TENLEAP-AI/digital-human-koubo/hardware/esp32-s3-board/kicad/README.md

# Zeebuddy 主板 V1（KiCad 9）

ESP32-S3-WROOM-1U-N16R8 + Air780E 的主板，第一版，**草稿**：原理图已画完，PCB 已布通，
**还有几条规范没满足（见下），还不能投板。**引脚分配按 `../docs/requirements.md` 的方案三，
两颗扩展芯片的引脚按板上位置重新分过（见"还没定的"一节的表）。

> **下一轮布线进行中**（2026-11-12）：板子文件仍是全部连通的 731b83a 走线；脚本已改成按 GEN-7、VIP-1、USB-3 出底子，
> 新底子上自动布线还剩 13 ~ 19 处没连。做法、数字和要定的事见 [`reports/routing-closure.md`](reports/routing-closure.md) 第 10 节。
> 现在直接重跑脚本得到的是这个没做完的版本，不是仓库里的板子。
>
> **当前状态**（2026-11-11）：六层、板厚 1.6 mm，按 [`../docs/layout-spec.md`](../docs/layout-spec.md)（V0.3）在做。
> - `zeebuddy-mainboard.kicad_pcb`：`731b83a` 那一版 570 处连接全部布通。2026-11-12 按独立复查改了两处原理图
>   （Type-C 保护芯片 U1 第 5 脚接 VBUS；R44 改为默认贴），U1 第 5 脚这根线在现在的板子上被锁定的 USB 线围住，
>   **留作 1 处未连通**，和下一轮的 USB 重画一起做。KiCad 9.0.9 完整检查：未连通 1、布线违规 0、
>   原理图一致性（含字段差异）0。报告在 [`reports/`](reports/)。
> - 首版配置：屏用 G3 ~ G7 五根数据线（G0 ~ G2 接地），保留 TF 卡，R58 ~ R60 已删除。
> - **屏的接口没有定，定之前不要投板。**屏厂给的型号（华迪创显 HD28142C22）是 MIPI 接口，这块主板是按 8 位串行 RGB 设计的，
>   驱动不了；要屏厂答复能不能做 RGB 接口的版本。见 [`../docs/display-interface-for-vendor.md`](../docs/display-interface-for-vendor.md)。
> - **KiCad 检查通过不等于规范全部满足。**还没满足或没检查的：USB 四段里三段的等长（USB-3）；
>   1 段 4.2 mm 的 0.11 mm 窄线（GEN-1 允许的窄线最长 3 mm）；过孔到焊盘 ≥0.15 mm（GEN-7）没有写进 KiCad 规则，
>   现在按 0.10 mm 检查；另有 3 处和规范的出入等确认（见规范的"待定问题"）。
>   逐项见 [`reports/routing-closure.md`](reports/routing-closure.md)。

## 文件

| 文件 | 内容 |
|---|---|
| `zeebuddy-mainboard.pdf` | 原理图 PDF，直接看这个 |
| `zeebuddy-mainboard.kicad_pro` / `.kicad_sch` | KiCad 工程和顶层图 |
| `power.kicad_sch` | 1 电源：Type-C、充电（SY6970）、电池、3.3 V |
| `mcu.kicad_sch` | 2 主控：ESP32-S3 模组、下载口、USB 切换 |
| `expander.kicad_sch` | 3 两颗 I²C 扩展芯片、按键 |
| `cellular.kicad_sch` | 4 4G：Air780E、SIM 卡、天线 |
| `display.kicad_sch` | 5 屏、触摸、背光 |
| `camera.kicad_sch` | 6 前后摄像头、总线切换、摄像头电源 |
| `audio_tf.kicad_sch` | 7 麦克风、功放、TF 卡 |
| `zeebuddy.kicad_sym` | 工程自带的符号（Air780E、排线座等） |
| `zeebuddy-mainboard.kicad_pcb` | PCB：六层，外形、螺丝孔、210 个封装；电源、地、天线线、USB 已布好并锁定，信号线全部布通 |
| `reports/drc-report.txt` / `.json` | KiCad 9.0.9 的完整检查报告（含原理图一致性） |
| `reports/routing-closure.md` | 布线收尾记录：每处断点怎么处理的、改了什么摆位、规范核查结果、还没满足的规范、独立复查的结论 |
| `connector-positions.png` | 所有排线座的位置、第 1 脚、排线插入方向（`gen/connectors.py` 生成），给结构和排线供应商 |
| `../docs/display-interface-for-vendor.md` | 给屏厂的排线接口定义（8 位串行 RGB，主板现在的接法）：脚位表、要屏厂确认的事项、背光和触摸 |
| `../docs/display-request-serial-rgb.md` | 给屏厂的改法说明（8 位串行 RGB，一页，不含内部分析）：要求、脚位、要对方答复的问题 |
| `../docs/display-interface-qspi-proposal.md` | 给屏厂评估的 QSPI 接口定义（提案，主板还没按它改） |
| `placement-front.png` / `placement-back.png` | 正反两面主要器件的摆放示意图 |
| `routing.png` | 当前布线的示意图 |
| `freerouting/zeebuddy-mainboard.dsn` | **第二轮**给 Freerouting 用的板子文件（底子作为障碍，只有信号线要布） |
| `freerouting/zeebuddy-mainboard.ses` | 第二轮 Freerouting 的结果（2.5.0，限时 20 分钟） |
| `freerouting/round1.ses` | 第一轮的布线结果，存档用。它对应的是旧摆放（提交 `2e952f9`），不能导入现在的板子 |
| `zeebuddy.pretty/` | 工程自带的封装（Air780E、SY6970、麦克风和几个占位封装） |
| `gen/` | 生成原理图、封装库和 PCB 的脚本，见下面"PCB 是怎么生成的" |

## 这份图是脚本生成的

原理图不是在 KiCad 里手画的，而是由 `gen/design.py` 生成。每个引脚引出一小段线，接一个网络标号，
同名的标号就是连在一起，所以图上看不到长连线。

要改电路：改 `gen/design.py`，然后运行

```bash
gen/build.sh
```

它会重新生成全部图纸，用 KiCad 导出网表并和脚本里写的连接逐脚比对，再跑 ERC、导出 PDF；
然后生成封装库和 PCB，跑 DRC 和"PCB 与原理图是否一致"的检查。
直接在 KiCad 里改图，下次生成时会被覆盖。

**PCB 目前也是脚本整板生成的**，每次运行都会重摆、重布。等布线接近完成、需要手工收尾时，就不能再整板重新生成了。

## 检查结果

- 网表比对：833 个引脚全部与脚本里写的连接一致。
- KiCad ERC：0 个错误，1 个警告（功放散热焊盘接地，符号库里这个脚的类型是"未指定"，可以忽略）。
- PCB 与原理图一致性：213 个封装、全部焊盘的网络都与原理图一致。
- KiCad DRC：元件之间没有重叠，没有超出板边；已布的线没有间距、短路、孔距、板边类的违规。
  有 1 个提示：天线座封装与库里的不一致（我把它自带的禁布区从"所有层"改成了只在背面，是有意的）。
  未连接 0 个。

这些只说明"图和脚本一致、没有悬空或短接、摆放不打架"，**不代表电路经过了实物验证**。

## PCB 是怎么生成的

| 步骤 | 脚本 | 做什么 |
|---|---|---|
| 摆放 | `gen/place.py`、`gen/board.py` | 每个元件的位置；生成摆好的板子 |
| 底子 | `gen/power.py`、`gen/route.py` | `power.py` 是手工定坐标的电源铜皮和过孔，程序逐段检查间距；`route.py` 再布天线线、USB、每个地和 3.3 V 焊盘的短线加过孔，全部锁定 |
| 交给自动布线 | `gen/freeroute.py` | 生成 `freerouting/*.dsn`；布完后用 `--ses` 导入结果 |
| 收尾 | `gen/finish.py` | 清掉悬空线头，去掉违规线段并重连，补还没连上的 |
| 检查 | `gen/check.py` | 按规范逐条量数字，出"规则 — 要求 — 实测 — 结论"表 |
| 查原因 | `gen/diagnose.py` | 布不通时查是板子装不下还是布线程序的问题 |

```bash
/usr/bin/python3.12 gen/board.py .     # 摆放
/usr/bin/python3.12 gen/route.py .     # 底子（约 2 秒）
/usr/bin/python3.12 gen/freeroute.py . # 生成 .dsn
/usr/bin/python3.12 gen/check.py .     # 检查表
```

## PCB 布线现状（六层）

六层的用法：第 1、6 层放元件、短线和电源铜皮，第 2、5 层整层地，第 3 层走信号，第 4 层铺 3.3 V。

布线分两步（规范第 2 节的顺序）：**先把底子做好并锁定，再让 Freerouting 只布信号线。**
第一轮顺序反了（先布信号，电源和地的过孔事后挤不进去），所以重做。

### 底子里有什么

| 内容 | 怎么做的 |
|---|---|
| 电池 → 充电芯片 | 背面一块 2 mm 宽的铜皮，从电池焊盘直接到充电芯片的电池脚，电池电容在路上 |
| 充电芯片 → Air780E | 充电芯片转了 90°，系统输出脚朝上，接一条 2 mm 宽的铜带沿上方直通 4G 电源开关；开关管 → 220 µF → 模组供电脚是一整块铜皮。电池焊盘到模组供电脚铜皮共约 21 mm |
| 电源汇合点（PWR-16） | 在充电芯片系统输出的电容处：4G 一路往右，另一路经 4 个过孔到正面，一条 2 mm 宽的铜带一直到功放 |
| 充电回路 | 电感紧贴开关脚（铜长 2.7 mm），自举电容压在开关节点上，系统输出电容的地焊盘正对芯片的功率地脚 |
| 3.3 V 降压（正面） | 输入电容的地从芯片肚子底下接回地脚；开关脚到电感 0.65 mm；输出经 2 个过孔进第 4 层 |
| 背光升压（正面，移到了下方） | 电感在芯片正上方，二极管和输出电容在左侧，高频回路在 2 mm 以内 |
| 5 V 输入（VBUS） | Type-C 两组供电脚各引一条 0.6 mm 的线，从保护芯片两侧绕过定位柱，到 TVS 汇成 1.0 mm，沿下边缘走，再转到背面从 SIM 卡座底下（避开卡座的触点窗）到充电芯片 |
| 天线线 | 和以前一样：0.34 mm 直线、第 5 层只在天线座焊盘下开窗。新增：线两侧各两条地线，把 1 mm 的隔离带实实在在占住 |
| USB | 四段都已布好并锁定（等长还没达标，见下） |
| 地和 3.3 V | 每个焊盘一段短线加一个过孔，共 236 个；先打电容的，再接引脚 |

### 按规范量出来的结果

`gen/check.py` 的输出（节选）：

| 规则 | 要求 | 实测 | 结论 |
|---|---|---|---|
| DRC | 间距、短路、孔距、板边等 0 条 | 0 条 | 通过 |
| 原理图一致性 | 0 处差异 | 0 处 | 通过 |
| 底子完整 | 电源、地、3.3 V、天线、USB 全部连上 | 0 处没连 | 通过 |
| PWR-1 | 电池、系统电源、4G 供电的铜皮 ≥2.0 mm；收窄处 ≥1.0 mm、长 ≤2 mm；引脚处按引脚宽 | 收窄处最窄 1.1 mm、最长 1.8 mm | 通过 |
| PWR-2 | 电池焊盘到 Air780E 供电脚：铜皮 ≤30 mm、≤15 mΩ | 约 21 mm、约 6.1 mΩ（按方块数估算，不含充电芯片和开关管） | 通过 |
| PWR-3 | 220 µF 正极到模组供电脚 ≤1.8 mm，电容在电流的路上 | 1.76 mm | 通过 |
| PWR-5 | 220 µF 地焊盘旁 ≥3 个 0.3 mm 地孔 | 3 个 | 通过 |
| PWR-8 | 换层过孔数：系统电源 ≥4，VBUS 和 3.3 V 主干 ≥2 | 4 / 2 / 2 / 2 / 2 | 通过 |
| PWR-12 | 开关节点铜长 ≤3 mm，不打过孔 | 充电 2.74 mm、3.3 V 降压 0.64 mm、背光 0.84 mm，均无过孔 | 通过 |
| PWR-14 | 散热焊盘地孔：充电芯片 ≥5，功放 ≥4 | 6 个、4 个 | 通过 |
| DEC-6 | ESP32 底部地焊盘 ≥9 个地孔 | 12 个 | 通过 |
| RF-5 | 天线线两侧地孔间距 ≤2 mm | 14 个，最大间隔 1.8 mm | 通过 |
| RF-6 | 天线线总长 ≤15 mm | 6.5 mm | 通过 |
| RF-9 | 背面其它信号离天线线 ≥1 mm | 最近 2.0 mm | 通过 |
| RF-11 | 天线座每个地焊盘旁 ≥2 个地孔 | 5 个、2 个 | 通过 |
| USB-3 | 每段两根线长度差 ≤0.5 mm | 1.8 / 0 / 3.3 / 2.6 mm | **三段不通过** |

这张表只覆盖底子负责的规则（电源、地孔、天线线、USB 长度）。信号类的规则还没有写进脚本。

### 和规范有出入的地方

这几处已经记进规范的"待定问题"，等确认：

- **USB 等长（USB-3）**：四段里三段没达标。功能上不会有问题（常见设计指南的上限约 3.8 mm），但没达到规范收紧后的 0.5 mm。
- **VBUS 线宽（PWR-9）**：Type-C 旁边有约 7 mm 是两条 0.6 mm 并联，不是一条 1.0 mm（定位柱和保护芯片之间放不下）。
- **TVS 的位置（PWR-7）**：离 Type-C 供电脚约 6 mm，规范的判据是 2 mm（那一带正面没有空位）。
- **充电输入电容的地（PWR-11）**：芯片的引脚排列不允许同一面直接连，改为经相邻地层回流，孔紧挨焊盘。

另外有两处要留意：

- 5 V 输入线有一段从 SIM 卡座底下走（背面，避开了卡座封装标出的 6 个触点窗）。卡座的实际型号定了以后要对着图纸再确认一次。
- 4G 电源开关用的是 AO3401A，数据手册给的导通电阻上限是 60 mΩ（栅压 4.5 V 时）、85 mΩ（2.5 V 时）。
  按 2 A 算会掉 0.12 V 以上，占了"跌落 ≤300 mV"预算的四成。这是原理图层面的事，这次没有动，
  打样前值得换一颗导通电阻更低的管子。

### 第三轮：布通（2026-11-11）

第二轮停在"三个信号层装不下这么多交叉"。第三轮没有加层，改的是交叉本身：

| 改了什么 | 为什么 |
|---|---|
| 前摄排线座 J11 移到上边缘右侧，紧挨总线切换芯片；按键排线座 J5 左移 10 mm | 前摄的 14 根线原来要横穿 25 mm 的 4G 模组外围 |
| 两颗扩展芯片的信号按器件在板上的位置重新分配（6 个信号换了芯片或引脚） | 左边的中断线接在右边的芯片上，右边的摄像头控制线接在中间的芯片上，各跨 30 ~ 65 mm |
| 删除 R58 ~ R60（屏低 3 位借 TF 卡线的选配） | 三条 40 mm 以上的线横穿全板，首版用不上 |
| U8 下移 0.8 mm，U7 转 180° | U8 的中断脚被两个 3.3 V 脚的连线盖死；U7 的按键脚背对着它们的上拉电阻 |
| 底子里手工加了 4 处短线（`power.py`） | TF 卡座第 4、5 脚，U8 第 18 脚，U7 的中断脚：这些脚光靠锁定的铜就被围住，自动布线解不了 |
| 测试点、时钟串联电阻、稳压芯片的输出电容等挪到它们所连的引脚旁 | 缩短支线，让出通道 |

找这类问题用的办法是在只有底子的板子上逐个引脚试"能不能出来"（出不来的就是被锁定的铜围死的），
以及对每一处没连上的连接算"最短的路要穿过哪些线、沿途有多少过孔"。

结果：Freerouting 2.5.0 自己停在剩 3 处，`finish.py` 之后剩 1 处（充电芯片的 I²C 时钟脚），
`hand.py` 手工接通；`widen.py` 把过窄的线加宽。每处断点的处理见 [`reports/routing-closure.md`](reports/routing-closure.md)。

**重新生成的命令**（顺序不能变；`hand.py` 里的坐标只对这一份布线结果有效）：

```bash
python3 gen/design.py . && python3 gen/verify.py . zeebuddy-mainboard      # 原理图
/usr/bin/python3.12 gen/board.py .                                          # 摆放
/usr/bin/python3.12 gen/route.py .                                          # 底子
/usr/bin/python3.12 gen/freeroute.py .                                      # 生成 freerouting/*.dsn
java -jar freerouting-2.5.0.jar -de freerouting/zeebuddy-mainboard.dsn -do freerouting/zeebuddy-mainboard.ses \
     --router.autorouter.max_passes=40 --router.job_timeout=00:20:00 -mt 1 --gui.enabled=false
/usr/bin/python3.12 gen/freeroute.py . --ses freerouting/zeebuddy-mainboard.ses   # 导入
RIPUP=150 /usr/bin/python3.12 gen/finish.py .                               # 清理、补线
/usr/bin/python3.12 gen/hand.py . --kicad-decides                           # 手工那几段
/usr/bin/python3.12 gen/widen.py zeebuddy-mainboard.kicad_pcb               # 加宽过窄的线
/usr/bin/python3.12 gen/check.py .                                          # 检查表
```

仓库里的 `freerouting/zeebuddy-mainboard.ses` 就是这次用的那份结果，直接从"导入"那一步做起可以得到同一块板子。

### 第二轮的记录

下面是第二轮（三层、原来的摆放）的过程，保留作记录；数字已被第三轮取代。

**结果（2026-11-11，Freerouting 2.5.0，每次限时 20 分钟）**

| 没连上的信号连接 | 第一次（原摆放） | 第二次（排线座下方清出空带） |
|---|---|---|
| 交给 Freerouting 之前 | 243 | 243 |
| Freerouting 到点停下时 | 48 | 51 |
| `finish.py` 清理并补线之后 | 38 | **42** |

两次导入后 KiCad 检查都是 0 条违规（没有短路、没有间距问题），底子一条没动。板子文件里是第二次的结果。

**第二次改了什么摆放。** 前摄排线座 J11 的引脚下方原来 0.5 mm 就是一排元件。现在：
C46、C47 挪到 C18 右边，Q2 挪到 R73 下方，Q3 ~ Q5 和它们下面三排电阻往下让了 0.9 mm。
J11 引脚下方有了约 2 mm 的空带，电源部分没有动。

**为什么数字没有变好。** 两次的差别在自动布线的波动范围内（±5）。剩下的 42 处：

| 位置 | 数量 |
|---|---|
| 前摄像头排线座 J11（正面，上边缘） | 9 |
| 屏排线座 J8（背面，上边缘） | 6 |
| 后摄像头排线座 J10（背面，上边缘） | 4 |
| 其余（扩展芯片 U8、SIM、测试点、几颗电阻等） | 23 |

出线空带只解决了"第一步迈不出去"，没有解决"迈出去以后没路走"：

- 前摄的 14 根线要从 J11（x = 14 ~ 26 mm）走到总线切换芯片 U12 / U13（x = 41 ~ 49 mm），
  中间 25 mm 是 4G 模组的外围电路，正反两面都是元件和过孔。
- J8（背面）和 J11（正面）在 x = 12 ~ 22 mm 正反重叠，两边的过孔互相占位；J8 引脚下方 1 mm 就是
  2 mm 宽的系统电源铜带，只能打一排过孔。
- 只有三个信号层（第 1、3、6 层）。放开到六层试过一次，Freerouting 自己能做到剩 19 处，但线会走在地层和 3.3 V 层上，不能用。

下一步要动的是排线座的位置（把前摄排线座移到总线切换芯片旁边，或者和屏排线座错开），这会影响排线从哪里伸出来，
要先和结构对一下。

**交接文件的做法（脚本自动完成）**

- 底子里已经连好的 25 个网络（地、3.3 V、各路电源、天线、USB）**不作为网络**交给 Freerouting：
  它们的铜变成禁布区，焊盘不带网络。Freerouting 看到的只有障碍和 243 处信号连接。
  （第一次直接把它们当锁定的线交过去，Freerouting 每一轮都去尝试连接地和 3.3 V 的 250 多个焊盘，
  30 分钟没走完第一轮。）
- 地和 3.3 V 各留一个焊盘，这样三层平面还在文件里，Freerouting 才不会在平面层上走信号线
  （去掉平面试过一次：它在平面层上布了 160 段线，全部和过孔短路）。
- 通孔在内层补了铜；板子外形往里收 0.32 mm；天线线两侧用地线占住。
- 运行时加时间上限（`--router.job_timeout`）：Freerouting 只在停下时才写结果，不限时会为最后几十处跑一个小时以上。

**重跑的命令**

```bash
/usr/bin/python3.12 gen/freeroute.py .                       # 生成 .dsn
java -jar freerouting-2.5.0.jar -de freerouting/zeebuddy-mainboard.dsn -do freerouting/zeebuddy-mainboard.ses \
     --router.autorouter.max_passes=40 --router.job_timeout=00:20:00 -mt 1 --gui.enabled=false
/usr/bin/python3.12 gen/freeroute.py . --ses freerouting/zeebuddy-mainboard.ses   # 导入
/usr/bin/python3.12 gen/finish.py .                          # 清理、补线
/usr/bin/python3.12 gen/check.py .                           # 检查表
```

注意：

- Freerouting **不会**把 USB 当差分对来走，所以 USB 是先在这边画好再锁定的。
- `.dsn` 由 `gen/freeroute.py` 生成；元件位置或底子变了要重新生成，旧的 `.ses` 就不能用了。
- 用界面跑也可以（`文件 → 打开` 选 `.dsn`，点自动布线，停下后 `文件 → 另存为` 存成 `.ses`），但界面没有时间上限，要自己看着停。

### 以前几轮的记录

**自己写的布线程序**（`SIGNALS=1 gen/route.py`，网格搜索加拆线重布）：旧摆放下布通 509 ~ 514 / 580，
四层版是 484 / 579。在新的底子上不拆线只布一遍是 489 / 576。它现在只用来做底子和收尾。

**为什么布不完**（`gen/diagnose.py`，旧摆放上量的）：没连上的 71 处里，空板上也布不通的 0 处，
被固定的铜堵住的 6 处，只是被别的信号线挡住的 65 处；需要过孔的 520 个引脚在 2 mm 内都能分到过孔位；
最紧的截面只用了 27%。结论是板子装得下，问题在布线程序。

**试过的办法**：先短后长、只拆挡路的一段、给细间距引脚预先打孔（没有帮助）、协商布线（`NEGOTIATE=1`，没有收敛，
代码保留，默认不启用）。

**Freerouting 第一轮（2026-11-11，旧摆放，结果存在 `freerouting/round1.ses`）**：信号线只剩 28 处没连（我的程序是 65 处），
但留下了这些问题，第二轮逐条做了处理：

| 第一轮的问题 | 数量 | 第二轮怎么处理 |
|---|---|---|
| 地和 3.3 V 的焊盘完全没接（它不负责接平面） | 255 处 | 底子里先接好并锁定 |
| 第三层的线从通孔上压过去 | 17 段 | 导出文件里给这些通孔补上内层的铜 |
| 离板边不到 0.3 mm | 20 段 | 导出的外形往里收 0.32 mm |
| 电源线走了第三层、线宽不够 | VBAT、VSYS、VBUS 等 | 电源全部在底子里手工布好并锁定，不交给它 |
| 天线线旁 1 mm 内有别的过孔 | 2 个 | 线两侧用锁定的地线占住 |
| 线宽 0.075 mm、悬空的过孔和线头 | 2 段、26 个、42 段 | 仍由 `finish.py` 导入后清理 |

## PCB 摆放

- 外形和四个螺丝孔取自参考主板 M03 的 STEP 模型：64 × 34 mm（参考板是 0.8 mm 四层；本板是 1.6 mm 六层）。
  右上角的螺丝孔离板边只有 1.2 mm，放不下铜环，做成了不带铜的孔；另外三个孔的铜环接地。
- **背面是"高"的一面**：ESP32-S3 模组（高 3.2 mm）、Air780E（2.3 mm）、屏 / 触摸 / 后摄的排线座、电池和喇叭焊盘、充电芯片；
  下边缘从背面看由左到右是 **TF 卡座、Type-C、4G 天线座、SIM 卡座**，三个对外的口在同一面同一条边。
- **正面是"低"的一面**：前摄排线座、两个按键排线座、麦克风、下载焊盘，以及绝大部分小元件。
  充电芯片的外围、Air780E 的大电容和电源开关、ESP32 的去耦电容、天线匹配放在背面，紧挨着对应的引脚。
- **第二轮重摆的部分**（都是为了让电源按规范走）：
  - 背面：充电芯片转了 90°，电感、各个电容按引脚重新围着它摆；4G 电源开关移到 220 µF 上方，220 µF 调了头（正极朝上）。
  - 正面：3.3 V 降压移到系统电源过孔旁边；功放留在左下角喇叭焊盘旁，转了 90°（供电脚朝右、输出朝上）；
    背光升压移到下方空处；Air780E 的三个小滤波电容和 TVS 移到供电脚正对面；Type-C 的保护芯片转了 90°，
    给两侧各让出一条 0.6 mm 的走线位；几个电源测试点挪到了各自电源的旁边。
  - 正面的 IO 扩展芯片（U8）右移了 0.6 mm，让它底部的地焊盘正对背面天线线两侧，好在里面打地孔。
- 与参考主板位置相同的：Type-C、SIM 卡座、电池焊盘、喇叭焊盘、麦克风、按键排线 A。其它位置是我定的。
- 为了把 TF 卡座放到背面，ESP32 模组顶到了上边缘，Air780E 横过来放。代价是 Air780E 四周的间距只剩
  1.3 ~ 2.2 mm（到排线座 1.3、到 SIM 卡座 1.6、到 Type-C 1.9、到 ESP32 模组 2.2），合宙建议是 3 mm。
- 图纸坐标：板子左上角在 KiCad 页面的 (100, 60) mm 处。

**占位的封装**（型号定了要换）：三种排线座（按常见的 0.5 mm 翻盖座估的尺寸）、SIM 卡座（GCT SIM8060）、
TF 卡座（Molex 104031-0811）、Type-C（HRO TYPE-C-31-M-12）、两个轻触开关、IO 扩展芯片（按 TI 的 QFN-24 封装）。

## 自建封装的出处

| 封装 | 出处 |
|---|---|
| `Air780E` | 合宙官方 PADS 封装包 V20241030 里的 109 个焊盘坐标和尺寸；与官方"封装尺寸推荐"图一致 |
| `SY6970_QFN-24_4x4mm` | SY6970 数据手册 Rev 0.1 的推荐 PCB 图：焊盘 0.55 × 0.28、间距 0.5、散热焊盘 2.7 × 2.7 |
| `MSM261S4030H0R` | 敏芯数据手册 V1.0 的推荐焊盘图：焊盘 0.9 × 0.6、行距 1.0、两列间隔 1.0 |

## 元件脚位的出处

| 元件 | 脚位出处 |
|---|---|
| ESP32-S3 模组、MAX98357A、FSUSB42、ME6211、三极管、MOS 管、保护器件 | KiCad 9 官方符号库 |
| SY6970QCC 充电芯片 | 矽力杰 SY6970 数据手册 Rev 0.1 的管脚表；外围元件值也按这份手册 |
| XL9555QF24 | 用官方库里 TCA9555RTWR 的符号；对照 XL9555 数据手册，QFN-24 的 24 个脚完全相同 |
| SY8089AAAC | 用官方库里 TLV62569DBV 的符号；对照 SY8089 数据手册，5 个脚和 0.6 V 反馈电压相同 |
| Air780E | 合宙《Air780E 硬件手册》AT 方式管脚表，109 个焊盘 |
| 摄像头 24 脚排线 | 乐鑫 ESP32-S3-EYE 主板原理图的 J4 |
| 屏 22 脚排线 | 屏厂的 LB28BOE47 确认图 |
| MSM261S4030H0R 麦克风 | 敏芯数据手册 V1.0 的管脚表 |
| SY7200AABC 背光驱动 | 矽力杰 SY7200A 数据手册 Rev 1.0 的管脚表 |
| 74CBTLV3257 | 按标准脚位自建，对照过 KiCad 官方库里同型号的分单元符号 |
| 触摸排线、按键排线、SIM 卡座 | **占位，脚位待定** |

## 可以替换的料

| 图上的型号 | 可替换 | 说明 |
|---|---|---|
| SY6970QCC | BQ25895RTWR | 24 个脚相同，贵约 6 元；TI 的数据手册用 2.2 µH 电感 |
| XL9555QF24 | TCA9555RTWR | 脚位相同；TCA9555 没有内部上拉 |
| SY8089AAAC | TLV62569DBV | 脚位和反馈电压相同 |

没有采用 NS4168 功放：它的逻辑高电平要求 0.7 × 供电电压，功放用电池电压供电时 3.3 V 的信号不够高；
改用 3.3 V 给它供电又会损失输出功率。

## 还没定的

见顶层图上的清单。封装只填了有把握的（阻容、芯片、模组）；连接器的封装是占位，画板前要按实际型号换。

**投板前要定的选配电阻**（2026-11-11 记录）：

| 电阻 | 作用 | 现状 | 等什么 |
|---|---|---|---|
| R58 ~ R60 | 把屏的低 3 位数据线借给 TF 卡的 3 根线（8 位全接，但不能用 TF 卡） | **已删除**。首版用 5 根数据线（G3 ~ G7），保留 TF 卡 | 拿到实物屏后看颜色渐变能否接受；不够再重新分配 ESP32 引脚，做到 8 位全接且保留 TF 卡 |
| R8（不贴） | 按键 1 兼作充电芯片的唤醒（QON） | 保留。它让 KEY1 多出一条 50 mm 的支线 | 确认关机后是否需要用按键 1 通过充电芯片唤醒 |
| R73（不贴） | 把 1.2 V 送到前摄的 DVDD | 保留。支线约 30 mm | 定前摄实物料号和排线定义，确认模组是否需要主板提供 1.2 V。关系到首版能不能测前摄 |

**两颗扩展芯片的引脚分配**（固件按这张表配置；信号按器件在板上的位置分，不按输入输出分）：

| 芯片 | 地址 | 位置 | 输入 | 输出 | 不用 |
|---|---|---|---|---|---|
| A（U7） | 0x20 | 板子右侧 | P00 ~ P05 = KEY1 ~ KEY6，P07 = SD_DET，P11 = LTE_STATUS_N | P06 = CAMF_PWDN，P10 = CAM_SEL，P12 = CAM_RST，P13 = EXP_SPARE | P14 ~ P17（设成输出） |
| B（U8） | 0x22 | 中间偏左 | P10 = CHG_INT，P17 = TP_INT | P00 = LCD_RST，P01 = LCD_CS，P02 = LCD_SCL，P03 = LCD_SDA，P04 = TP_RST，P05 = CAM_PWR_EN，P06 = CAMR_PWDN，P12 = PA_EN，P13 = LTE_PWR_EN，P14 = LTE_PWRKEY_EN，P15 = LTE_RESET_EN，P16 = USB_SEL | P07、P11（被天线线的地孔围住，线出不来；设成输出） |

和最初的分配相比换了位置的：TP_INT（A.P06 → B.P17）、CHG_INT（A.P10 → B.P10）、CAMF_PWDN（B.P07 → A.P06）、
CAM_SEL（B.P10 → A.P10）、CAM_RST（B.P11 → A.P12）、EXP_SPARE（B.P17 → A.P13）。两颗的 INT 并在一起接 ESP32。
