TENLEAP-AI/digital-human-koubo/hardware/esp32-s3-board/docs/pcb-redesign-brief.md

# Zeebuddy 主板改板需求说明（给 PCB 工程师）

日期：2026-11-13。

## 0. 请你做什么

这是一块儿童学习机（AI 拍学机）的主板：ESP32-S31 模组跑应用，合宙 Air780E 负责 4G 联网。
原理图和 PCB 都按 ESP32-S3 画完过一版。**2026-11-13 主控改为 ESP32-S31**，所以这次是：原理图按 S31 改，PCB 重新画。
S31 的引脚分配我们已经做好，见 `docs/esp32-s31-pinmap.md`。

| 项 | 内容 |
|---|---|
| 主要工作 | 按第 6 节的规范重新摆放、布线，做到 DRC 零错误、零未连接，规范的"必须"项全部满足 |
| 原理图 | **S31 版已画好**（2026-11-14，分支 `claude/board-s31`，214 个元件、180 个网络，网表核对和 ERC 通过）。改动见 `docs/esp32-s31-pinmap.md` 第 4 节。**用 KiCad 10 打开**（模组符号用了 KiCad 10 的格式）。该分支里的 PCB 文件还是 S3 版的，不能用，请按新原理图重画 |
| 工具 | 现有工程是 KiCad 9（9.0.9）。最好继续用 KiCad；用别的软件也行，但交付时要附 KiCad 能打开的文件或完整的 Gerber 和源文件 |
| 交付 | 见第 9 节 |
| 开工前请先回复 | 报价、工期，以及第 7.1 节两种做法你倾向哪一种 |

工程是我们用脚本生成的。交给你之后**以 KiCad 文件为准**，直接在 KiCad 里改，不用管 `gen/` 目录里的脚本。

## 1. 现有资料

全部在 GitHub 仓库 `TENLEAP-AI/digital-human-koubo` 的 `hardware/esp32-s3-board/` 目录下，
分支 `claude/esp32-board-layout-2w2fx8`。

| 文件 | 内容 |
|---|---|
| `kicad/zeebuddy-mainboard.kicad_pro` 等 | KiCad 工程：7 张原理图、PCB、自带的符号库和封装库 |
| `kicad/zeebuddy-mainboard.pdf` | 原理图 PDF |
| `docs/layout-spec.md` | **布线规范 V0.4**，每条规则有编号（GEN、PWR、RF、USB……），下文引用的编号都在这里 |
| `kicad/connector-positions.png` | 所有排线座的位置、第 1 脚、排线插入方向 |
| `kicad/reports/routing-closure.md` | 上一版布线的记录：哪里最挤、试过什么、哪些规范没满足 |
| `kicad/reports/drc-report.txt` | 上一版的 KiCad 检查报告 |
| `docs/requirements.md` | 需求和引脚预算的来龙去脉 |
| `docs/air780e-design-notes.md`、`docs/esp32-s3-design-notes.md` | 两个模组的设计要点（出自原厂资料） |

上一版 PCB 有两个状态，都可以参考：

| 版本 | 在哪 | 情况 |
|---|---|---|
| 全部布通的一版 | 分支 `claude/backup-board-v1-routed` | 570 处连接全部连通、间距违规 0；但有约 300 个过孔贴着或压着焊盘，USB 等长不满足 |
| 按新规范重做的一版 | 分支 `claude/board-v2-gen7-round` | 过孔和 USB 都满足了，但还有 13 ~ 19 处没连通，停在这里 |

## 2. 板子的基本参数

| 项目 | 要求 |
|---|---|
| 外形 | 64 × 34 mm，外形和参考主板一致（KiCad 工程里已画好，含圆角和缺口） |
| 层数、板厚 | 6 层，1.6 mm，外层 1 oz、内层 0.5 oz |
| 叠层 | 按嘉立创六层阻抗叠层设计（外层 7628 预浸料 0.21 mm），型号下单时确认（规范第 1 节、13.1） |
| 各层用途 | L1 正面元件和短线；L2 整层地；L3 主要信号层；L4 3.3 V 铺铜（先不走信号）；L5 整层地；L6 背面元件、短线、大电流铜皮 |
| 贴片 | 两面贴。重的器件（两个模组、钽电容、充电电感、卡座、Type-C）在背面 |
| 螺丝孔 | 三个接地的金属化孔，中心在 (2.0, 14.5)、(3.7, 32.0)、(60.3, 32.0)；一个非金属化孔在 (62.2, 1.2)。坐标见第 4 节说明 |
| 过孔 | 信号 0.2 / 0.45 mm，电源 0.3 / 0.6 mm。0.2 mm 是这个板厚下的下限，不要再小 |
| 限高 | Air780E 高 2.3 mm，ESP32-S31 模组 3.2 mm。外壳两面的限高还没给，开工时和结构一起确认 |

## 3. 主要器件

| 位号 | 器件 | 说明 |
|---|---|---|
| U4 | **ESP32-S31-WROOM-1U-N16R16V** | 主控，背面。18.0 × 20.5 × 3.2 mm，64 个焊盘；16 MB Flash、16 MB PSRAM；Wi-Fi 用模组自带的 IPEX 座。规格书还是预发布 v0.5 |
| | | 符号和封装用乐鑫官方 KiCad 库 github.com/espressif/kicad-libraries 里的 `ESP32-S31-WROOM-1U`（已核对与规格书一致，带 3D 模型） |
| U9 | 合宙 Air780E | 4G 模组，背面。**要能换贴北美版 Air780EEN**（同封装） |
| U2 | SY6970QCC | 开关充电 + 电源路径，I²C 地址 0x6A。可换 BQ25895RTWR（脚位相同） |
| U3 | SY8089AAAC | 3.3 V 降压。可换 TLV62569DBV |
| U11 | SY7200AABC | 背光升压恒流，20 mA |
| Q1 | AO3401A | Air780E 的电源开关 |
| U15 / U16 | 2.8 V / 1.2 V LDO | 摄像头供电 |
| U1 | USBLC6-2SC6 | Type-C 的 USB 保护 |
| ~~U6~~ | ~~FSUSB42MUX~~ | **去掉**。S31 有两个独立 USB 口：Type-C 接全速口（GPIO33 / 34），Air780E 接高速口（专用 USB_DP / USB_DM） |
| U7 / U8 | XL9555QF24 ×2 | I²C 扩展芯片。U7 地址 0x20 放输入（按键、TF 卡检测、4G 状态），U8 地址 0x22 放输出（复位、使能、屏的三线 SPI）。不用 0x21（和前摄冲突） |
| U5 | 803 型 3.08 V 复位监控（开漏） | 接 EN。**默认贴**（乐鑫要求电池供电产品加） |
| U12 ~ U14 | 74CBTLV3257 ×3 | 前后摄像头共用并口时的总线切换 |
| U17 | MAX98357A | I²S 功放，接电池电压（VSYS） |
| Y1 | 24 MHz 有源晶振 | **只留位置不贴**：摄像头主时钟改由主控 GPIO55 经 0R 输出 |
| C19 | 220 µF 低 ESR 钽电容 | Air780E 供电，不能用陶瓷电容代替（规范 PWR-4） |

### 接口和连接器

位置是板子坐标：从正面看，左上角为原点，X 向右，Y 向下，单位 mm（背面的器件也按"从正面看"的坐标写）。

| 位号 | 接口 | 面 | 位置 | 说明 |
|---|---|---|---|---|
| J8 | 屏的板对板母座，亚奇 OCN OK-128GF040/2-35（0.35 mm 间距，40 信号脚 + 2 个端头电源脚，配合高 0.6 mm） | 背面 | 上边缘，中心 x ≈ 16.2 | **屏的接口还没定，见第 5 节**；已定用亚奇公母座代替原来的 FPC 座 |
| ~~J9~~ | ~~触摸排线座~~ | | | **去掉**：触摸已并进 J8 的 37 ~ 40 脚 |
| J10 | 后摄排线座 24P 0.5 mm（OV2640，200 万） | 背面 | 上边缘，中心 x ≈ 32 | |
| J11 | 前摄排线座 24P 0.5 mm（30 万，型号待定） | 正面 | 上边缘，中心 x ≈ 51 | |
| J5 / J4 | 按键排线 6P 0.5 mm ×2 | 正面 | J5 上边缘 x ≈ 39.4；J4 右边缘 | 6 个按键分两条排线 |
| J1 | Type-C 16P | 背面 | 下边缘中间 | 5 V / 2 A 充电，兼作下载 |
| J6 | Nano SIM 卡座 | 背面 | 下边缘左侧 | |
| J13 | TF 卡座（带检测） | 背面 | 下边缘右侧 | |
| J7 | IPEX 座（4G 天线） | 背面 | 下边缘，Type-C 左边 | |
| J2 / J12 | 电池焊盘、喇叭焊盘 | 背面 | 左边缘 | 电池 2000 mAh 单节锂电 |
| MK1 | I²S 麦克风 MSM261S4030H0R | 正面 | 右下 | |
| J3 | 下载 / 调试焊盘 | 正面 | 下边缘 | 串口 0、BOOT、EN |

各排线座的第 1 脚和排线插入方向见 `kicad/connector-positions.png`。
**外形、螺丝孔、各接口所在的那条板边要和外壳对齐**。接口沿板边挪动多少可以接受，开工前和我们、结构一起确认。
上一版已经确认过可以挪：前摄排线座（从 x ≈ 20 挪到了 x ≈ 51）。

连接器的封装现在是占位的（翻盖式 FPC 用 Hirose FH12 系列代替），**画板前要按实际采购的型号换封装**，型号我们提供。
**屏和触摸的接口已定：亚奇 OCN OK-128 系列板对板公母座**，主板贴母座 OK-128GF040/2-35，屏排线上是公座 OK-128GM040/2-35。0.35 mm 间距、配合高度 0.6 mm、40 个信号脚（两排各 20）加两端 2 个电源脚（每个 3 A），信号脚每脚 0.3 A。规格书我们另发，封装按规格书里的推荐焊盘画。注意：
- 公母座脚号是镜像的，原理图和封装一律按母座的脚号；
- 两端的电源脚接地；
- 0.35 mm 间距要 0.1 mm 线宽线距，焊盘间不能过线，出线要错开打孔，六层板常规工艺能做；
- 座子上方要留压泡棉的位置（结构件压住，防跌落松脱）；
- 插拔寿命只有 30 次，调试时少插拔。

## 4. 电路配置

### 4.1 电源

| 电源 | 从哪来 | 给谁 | 电流 |
|---|---|---|---|
| VBUS 5 V | Type-C，经 USBLC6 | 充电芯片 SY6970 | 按 2 A 设计 |
| VBAT | 充电芯片 | 电池，2000 mAh 单节锂电 | 充电 ≤1 A，放电按 3 A 设计 |
| VSYS | 充电芯片的系统输出 | 下面四路 | 3 A |
| VDD_4G | VSYS 经 AO3401 开关 | Air780E | 峰值按 2 A 设计 |
| 3.3 V | VSYS 经 SY8089 降压 | ESP32、扩展芯片、屏、卡等，L4 整层铺铜分配 | 1 A |
| 2.8 V、1.2 V | 3.3 V 经两颗 LDO | 摄像头 | 小 |
| 背光 | VSYS 经 SY7200 升压恒流 | 屏背光，约 18 V | 20 mA |
| 功放 | VSYS | MAX98357A → 喇叭 | 1 A |

- 大电流（VBAT、VSYS、VDD_4G）全部走外层铜皮，最窄 2.0 mm，不上 L4（PWR-1）。
- 功放和 4G 从 VSYS 电容处星形分开，各走各的铜皮（PWR-16）。
- 充电电流的硬件兜底：ILIM 电阻 680 Ω，充电芯片的 DP / DM 短接不接 USB 数据线。原理图已做好，布线不用管。

### 4.2 ESP32-S31 引脚分配

完整的表见 `docs/esp32-s31-pinmap.md`，要点：

- 屏和摄像头接在 S31 规格书里的**专用高速引脚**上（屏数据 D0 ~ D11 = GPIO8 ~ 19、像素时钟 40、DE / HSYNC / VSYNC 43 ~ 45；摄像头 GPIO46 ~ 57），走线从模组这几个脚直接出。屏 D12 ~ D15 = GPIO35 ~ 38。
- TF 卡固定在 GPIO20 ~ 25（4 线）；Type-C 的 USB 固定在 GPIO33（D−）/ 34（D+）；调试串口 GPIO58（TX）/ 59（RX）；BOOT 键 GPIO61。
- 扩展芯片中断、触摸中断在 GPIO0、1（低功耗引脚，可唤醒）。
- GPIO36、37 是启动配置脚，接屏的 D13、D14（屏的输入上电时高阻，不影响启动）。GPIO42 空，引到测试点。

### 4.3 扩展芯片

两颗 XL9555：U7（0x20）接 6 个按键、TF 卡检测、4G 状态（全是输入）；U8（0x22）接 4G 的电源 / 开机 / 复位、摄像头电源 / 待机 / 复位 / 切换、功放使能、屏和触摸的复位、屏的三线 SPI（全是输出）。两颗的中断并在一起接 GPIO0。
同一颗芯片里的脚**可以按摆放重新分配**，改了告诉我们，固件跟着改。

## 5. 屏的接口

**2026-11-14 定：并口 RGB，两家屏共用一个 40 脚板对板座（亚奇公母座）**。联讯 ST7102 用 16 根数据线（RGB565），
NV3049F 用其中 8 根（8 位串行 RGB）。40 脚定义见 `docs/display-request-rgb-st7102.md` 第 3 节，主控引脚见 `docs/esp32-s31-pinmap.md` 第 2 节。

- 屏数据 D0 ~ D11、PCLK、DE、HSYNC、VSYNC 接模组的专用高速脚（其中 D0 ~ D7 在模组底部那圈小焊盘上），D12 ~ D15 走普通 GPIO。
- 像素时钟约 21 ~ 25 MHz（退回 8 位串行时约 60 MHz）。PCLK 两边要有地线，走线按时钟线要求（规范 SIG-4）。
- 屏的初始化三线 SPI、复位走扩展芯片。触摸 I²C、中断也在这个座子上。

## 6. 布线规范要点

完整规范见 `docs/layout-spec.md`。下面是最要紧的，标"必须"的都要满足。

| 类别 | 要求 | 编号 |
|---|---|---|
| 线宽线距 | 信号线 0.15 mm，引脚间窄处 0.10 mm 且 ≤3 mm 长；铜间距 ≥0.10 mm；铜到板边 ≥0.3 mm | GEN-1、2、6 |
| 过孔 | 孔壁到孔壁 ≥0.25 mm；过孔到焊盘 ≥0.15 mm，不在焊盘上打孔（**见 7.1**）；除塞孔外全部盖油 | GEN-5、7、8，VIP-1 |
| 地孔 | 时钟和 USB 换层时 1 mm 内配地孔；全板地孔间距 ≤5 mm | GEN-10、GND-3 |
| 电源 | 见 4.1；开关电源的电容紧贴芯片，地在同一面直接相连；开关节点 ≤3 mm、不打孔 | PWR-1 ~ 18 |
| Air780E 供电 | 220 µF 正极到供电脚 ≤1.8 mm，在电流必经路上；电池到供电脚铜皮 ≤30 mm、≤15 mΩ | PWR-2、3、5 |
| 4G 天线线 | 50 Ω 共面单端，只走 L6，约 0.34 mm 宽、两侧 0.2 mm 间隙；只在天线座信号焊盘下 L5 开窗；两侧地孔间距 ≤2 mm；总长 ≤15 mm；匹配元件紧挨天线座 | RF-1 ~ 12 |
| USB | 90 Ω 差分，约 0.19 / 0.15 mm；两根线全程并排同层；**每段长度差 ≤0.5 mm**，整条 ≤1.0 mm；每根换层 ≤2 次 | USB-1 ~ 9 |
| 去耦 | 电容离电源脚 ≤2 mm，先过电容再进芯片；每个电容自己的地孔 | DEC-1 ~ 7 |
| 时钟 | 串联电阻离驱动端 ≤3 mm；优先走 L3；与其它线间距 ≥0.3 mm；换层 ≤2 次 | SIG-4 |
| SIM 卡 | 线 ≤30 mm；时钟和数据之间夹地 | SIG-1 ~ 3 |
| 地 | L2、L5 保持完整，成排过孔错开，不切出 >3 mm 的缝 | GND-1 |
| 工艺 | 小元件间距 ≥0.3 mm；元件离板边 ≥1 mm；每面 3 个定位点（放不下就放拼板工艺边）；测试点全在正面、直径 1 mm | DFM-1 ~ 8 |

## 7. 这次改板要解决的问题

### 7.1 过孔离焊盘（最主要的问题，请先给建议）

上一版能全部布通，靠的是电源和地的过孔直接贴着、压着焊盘（约 300 个离焊盘不到 0.15 mm，其中 66 个压在小焊盘上）。
按规范把过孔从焊盘上挪开之后，我们自己重做了十几遍，始终差 13 ~ 19 处连不上。
把间距放宽到 0.10 mm 也没用，问题在"过孔压不压焊盘"，不在间距差的那 0.05 mm。

两种做法，请你评估：

| | 做法 A：盘中孔 | 做法 B：过孔不碰焊盘 |
|---|---|---|
| 怎么做 | 过孔做**树脂塞孔 + 电镀盖帽**，允许过孔打在焊盘上 | 坚持规范 GEN-7，重排几个最挤的地方 |
| 好处 | 布线空间大，上一版的摆放基本可以沿用 | 板厂工艺常规，不加价 |
| 代价 | 板厂加价，要确认六层板的价格、最小孔径 | 摆放要大改，可能要挪接口、和结构重新对 |

我们倾向做法 A，但要先知道加多少钱。你如果有别的办法，也欢迎提。

### 7.2 已知最挤的地方（上一版的经验）

这是 S3 版摆放的经验。换成 S31、去掉 USB 切换芯片和一颗扩展芯片之后，位置会变，但排线座旁、模组旁小元件这几类地方仍然最紧。

| 位置 | 情况 |
|---|---|
| 屏排线座 J8、后摄排线座 J10（背面上边缘） | 排线座的脚正上方，正面是两颗摄像头 LDO、晶振和一排电阻，几乎打不了过孔；脚下方是 Air780E 的焊盘 |
| 扩展芯片 U7 一带（右侧） | 按键线、TF 卡、摄像头控制线都在这里汇合，下面是 ESP32 模组的焊盘列 |
| Air780E 旁的小元件（中间） | 背面是模组焊盘，正面是一片小电阻和三极管，过孔位很少 |
| 充电芯片的四个信号脚 | 一边是 5 V 铜带，一边是 VSYS 铜皮 |
| Type-C 下方 | 5 V 铜带在正面围成一圈，圈里打不了孔。CC 电阻要放在圈外 |

详细记录在 `kicad/reports/routing-closure.md`。

### 7.3 其它要一起改的

- Type-C 保护芯片 U1 的第 5 脚接 VBUS（原理图已改，上一版 PCB 没接上）。
- USB 只剩两段，各自等长：Type-C → USBLC6 → 主控 GPIO33 / 34（全速）；Air780E → 主控专用高速口（**480 Mbps，按高速 USB 的要求走**：90 Ω、等长、少换层）。
- 屏的像素时钟换层 ≤2 次，串联电阻靠近 ESP32（SIG-4）。
- 定位点（DFM-5）。
- 连接器换成实际型号的封装。

## 8. 还没定、需要我们提供的

| 事项 | 什么时候给 |
|---|---|
| ESP32-S31 的硬件设计指南、参考原理图（乐鑫还没公开发布，向代理要） | 开工前 |
| 屏的接口（QSPI 还是串行 RGB） | 样品测完，几周后 |
| 做法 A 还是 B | 你给建议、我们问完板厂价格后 |
| 各排线座、卡座、Type-C 的实际型号 | 开工前 |
| 外壳两面的限高、接口能挪多少 | 开工前，和结构一起 |
| 前摄的型号（决定 R73 要不要贴、要不要给它 1.2 V） | 尽快 |
| 屏厂按我们 40 脚定义出的母座脚号对照表（座子型号已定 OK-128GF040/2-35） | 屏厂答复后 |
| R8（按键 1 兼作充电芯片唤醒）留不留 | 开工前 |
| 板厂叠层和阻抗线宽 | 下单前，按板厂计算器 |

## 9. 交付要求

1. 完整的 PCB 工程（原理图如有改动一并交）。
2. KiCad（或你所用软件）的 **DRC 报告：零错误、零未连接**，原理图和 PCB 一致。
3. **规范核查表**：`layout-spec.md` 里每条"必须"规则一行，写要求、实测值、是否满足；不满足的写原因。
4. 生产文件：Gerber、钻孔、贴片坐标、BOM、拼板图（带工艺边和定位点）。
5. 给板厂的叠层截面图：天线线和 USB 的线宽、间隙、参考层、介质厚度（规范 5.1、RF-12）。
6. 正反两面的 3D 图或 STEP 文件，给结构核对。

## 10. 验收

- DRC 零错误、零未连接，原理图一致性零差异。
- 规范核查表里"必须"项全部满足，或每一条不满足的都有我们书面同意。
- 我们按核查表抽查天线线、USB、电源铜皮、Air780E 供电几处。
- 投板前双方一起过一遍人工评审清单（规范 11.3）：丝印、器件方向、电流走向、天线净空、贴片可行性。
