TENLEAP-AI/digital-human-koubo/hardware/esp32-s3-board/docs/display-request-serial-rgb.md

# 屏打样要求：8 位串行 RGB 版本（NV3049F，给屏厂）——已作废

> **2026-11-14 作废：NV3049F 改用 16 位并口 RGB，见 [display-request-rgb-nv3049f.md](display-request-rgb-nv3049f.md)。本文只留作记录。**

日期：2026-11-12；2026-11-13 加上触摸；2026-11-14 改为 40 脚公母座（主控换 ESP32-S31）。我们的主板已经按这个接口画好，屏按下面做出来就能直接用。

## 1. 一句话要求

2.8 英寸、480 × 640、驱动芯片 NV3049F 的屏，接口做成 **8 位串行 RGB + 三线 SPI**，排线按第 3 节的 40 脚定义出；**带电容触摸**，触摸排线按第 3.1 节的 6 脚定义出。
先做 3 ~ 5 片样品，屏和触摸一起打样。

## 2. 接口要求

| 项目 | 要求 |
|---|---|
| 图像接口 | **8 位串行 RGB**：只用 8 根数据线 D7 ~ D0，每个像素分 3 个时钟送（红、绿、蓝各一个字节），加 DOTCLK、HSYNC、VSYNC、DE |
| 命令接口 | 三线 SPI（CS、SCL、SDA），9 位一帧，只用来发初始化命令。我们只写不读 |
| 逻辑电平 | 3.3 V |
| 供电 | 主板只给一路 3.3 V |
| 复位 | RST，低有效 |
| 背光 | **灯必须串联**，电流 20 mA。主板按 6 颗串联、约 18 V 做的，4 ~ 6 颗串联都可以。主板的背光是升压恒流电路，**并联的灯用不了** |

**2026-11-14 补充：主控换成 ESP32-S31 以后，引脚够接 16 位并口 RGB 了**。如果 NV3049F 支持 16 位并口 RGB（RGB565），我们更希望改用 16 位并口：和另一家屏的接法统一，像素时钟也从约 60 MHz 降到约 21 MHz。脚位就用第 3 节的 40 脚定义，第 28 ~ 35 脚接 D8 ~ D15。不支持的话按 8 位串行 RGB 做，第 28 ~ 35 脚不接。请在第 5 节第 1 条一起答复。

## 3. 排线脚位（40 脚，板对板公母座）

**2026-11-14 改**：主控换成 ESP32-S31 以后，主板上屏的座子统一用 40 脚，两家屏共用。你们的屏用其中的 8 根数据线（D0 ~ D7），
第 28 ~ 35 脚不接；触摸并进同一条排线（第 37 ~ 40 脚），触摸芯片用 3.3 V（接第 6、7 脚的 VCI）。脚号按**主板上母座的脚号**。

| 脚 | 名称 | 方向 | 说明 |
|---|---|---|---|
| 1 | LEDA | 电源 | 背光正极 |
| 2 | LEDA | 电源 | 背光正极 |
| 3 | LEDK | 电源 | 背光负极 |
| 4 | LEDK | 电源 | 背光负极 |
| 5 | GND |  |  |
| 6 | VCI | 电源 | 3.3 V |
| 7 | VCI | 电源 | 3.3 V（屏的 IO 电源也接这里） |
| 8 | GND |  |  |
| 9 | RST | 主板 → 屏 | 复位，低有效 |
| 10 | CS | 主板 → 屏 | SPI 片选 |
| 11 | SCL | 主板 → 屏 | SPI 时钟 |
| 12 | SDA | 主板 → 屏 | SPI 数据 |
| 13 | GND |  |  |
| 14 | DOTCLK | 主板 → 屏 | 像素时钟 |
| 15 | GND |  | 隔开时钟 |
| 16 | DE | 主板 → 屏 | 数据有效 |
| 17 | HSYNC | 主板 → 屏 | 行同步 |
| 18 | VSYNC | 主板 → 屏 | 场同步 |
| 19 | GND |  |  |
| 20 | D0 | 主板 → 屏 | 串行 RGB 数据（最低位） |
| 21 | D1 | 主板 → 屏 | 串行 RGB 数据 |
| 22 | D2 | 主板 → 屏 | 串行 RGB 数据 |
| 23 | D3 | 主板 → 屏 | 串行 RGB 数据 |
| 24 | D4 | 主板 → 屏 | 串行 RGB 数据 |
| 25 | D5 | 主板 → 屏 | 串行 RGB 数据 |
| 26 | D6 | 主板 → 屏 | 串行 RGB 数据 |
| 27 | D7 | 主板 → 屏 | 串行 RGB 数据（最高位） |
| 28 | NC |  | 不接（这个位置给 16 位屏用） |
| 29 | NC |  | 不接（这个位置给 16 位屏用） |
| 30 | NC |  | 不接（这个位置给 16 位屏用） |
| 31 | NC |  | 不接（这个位置给 16 位屏用） |
| 32 | NC |  | 不接（这个位置给 16 位屏用） |
| 33 | NC |  | 不接（这个位置给 16 位屏用） |
| 34 | NC |  | 不接（这个位置给 16 位屏用） |
| 35 | NC |  | 不接（这个位置给 16 位屏用） |
| 36 | GND |  |  |
| 37 | TP-INT | 触摸 → 主板 | 触摸中断，低有效 |
| 38 | TP-RST | 主板 → 触摸 | 触摸复位，低有效 |
| 39 | TP-SCL | 主板 → 触摸 | 触摸 I²C 时钟 |
| 40 | TP-SDA | 双向 | 触摸 I²C 数据 |

**排线末端的做法：用亚奇品牌的板对板（BTB）公母座**。排线末端焊**公座**，主板上贴配套的**母座**。

- 请推荐亚奇的具体系列，给出**公座和母座的完整型号**（两者必须配套）、间距（常见 0.4 mm）、配合高度。配合高度希望 ≤1.0 mm，以结构最终确认为准。
- 上面的脚位表是**信号的顺序**。换成公母座后，请按所选型号的脚数重新排一张"母座脚号 → 信号"的对照表给我们：
  选的型号不是 40 脚的话按上表顺序排，脚数比信号多的，多出的脚接地；公座和母座的脚号是镜像的，**对照表一律按主板上母座的脚号写**，避免两边对反。
- **触摸能并进同一个公母座的话，我们倾向并进**：触摸的小排线接到屏的排线上，屏和触摸从一个公座出来（比如 30 脚左右）。
  做不到就触摸单独一对小公母座。请告诉我们哪种可行。
- 排线上公座的位置、方向和背面的补强板，随排线图一起给。

## 3.1 触摸（一起打样）

屏上要带**电容触摸**，触摸的小排线接到屏的排线上，从同一个公座出来（第 3 节第 37 ~ 40 脚）。

| 项目 | 要求 |
|---|---|
| 类型 | 电容触摸，单点即可，支持两点更好 |
| 触摸芯片 | 建议 CST836U（I²C）；用别的芯片请告诉我们型号 |
| 结构 | 触摸盖板和屏贴成一体，请说明是全贴合还是框贴 |
| 接口 | I²C，主板上有 3.3 V 上拉；中断和复位低有效 |
| 供电 | 用屏排线上的 3.3 V（第 6、7 脚）。芯片如果只能用 2.8 V，请在排线上自带稳压，或者告诉我们 |

## 4. 屏厂这边要做的

1. **芯片的接口配置脚**（IM[3:0]）在排线或玻璃上接成"RGB + SPI"模式。
2. **把芯片设成 8 位串行 RGB 模式**，并给出这个模式下的完整初始化代码。
3. 排线按第 3 节的脚位出线。
4. 提供排线图：长度、出线位置、弯折位置、金手指朝哪一面、第 1 脚在哪边。屏和触摸两条排线都要。
5. 触摸和屏贴合，触摸排线按第 3.1 节出线，给出触摸芯片的驱动代码或寄存器说明。

## 5. 打样前请书面答复

| # | 问题 | 屏厂答复 |
|---|---|---|
| 1 | **请书面确认：芯片是 NV3049F，样品用 8 位串行 RGB**，也就是只用 8 根数据线、每个像素分 3 个时钟送。我们查到的 NV3049 手册（2014 年版）只写了 16 / 18 / 24 位并口和 MIPI，所以请把 NV3049F 规格书里讲串行 RGB 的那几页发给我们 | |
| 1.1 | **NV3049F 支不支持 16 位并口 RGB（RGB565）**？支持的话我们改用 16 位并口（见第 2 节末尾）。请给出 16 位模式的初始化代码和时序 | |
| 2 | 串行模式下 3 个字节的颜色顺序（红绿蓝还是蓝绿红）；HSYNC、VSYNC、DE 的极性；行、场消隐的要求 | |
| 3 | **DOTCLK 的最小值、典型值、最大值，以及推荐的刷新率。** 我们的主控（ESP32-S31）8 位数据时像素时钟最高约 80 MHz，计划按 **60 MHz 左右、每秒 50 ~ 60 帧**做。480 × 640 每个像素 3 个时钟。请确认这个时钟下显示正常，并给出对应的消隐参数 | |
| 4 | 我们查到 NV3049F 的屏是 RGB666（每种颜色 6 位）。**每个颜色字节的 8 位里，哪 6 位有效，是不是 D7 ~ D2？** 主板 8 根数据线全接 | |
| 5 | 只给一路 3.3 V 行不行；电流多大 | |
| 6 | 背光能不能按串联做；几颗灯、电压、电流 | |
| 7 | 触摸：芯片型号、I²C 地址、能不能直接用 3.3 V 供电；中断是推挽还是开漏；驱动代码或寄存器说明 | |
| 8 | 排线图：长度、从模组哪边出线、弯折位置、公座的位置和朝向；公母座的完整型号、配合高度、母座脚号对照表；触摸是否并进同一个公母座 | |
| 9 | 打样费、开模费、起订量、交期 | |

第 1 和第 3 条最要紧：第 1 条不成立，这个方案就做不了；第 3 条决定画面流不流畅、闪不闪。

## 6. 样品到了我们怎么验

先不上主板，用开发板点亮：确认初始化代码能用、60 MHz 左右画面稳定不漂移、每秒 50 帧以上不闪、颜色和渐变正常。确认之后再定排线、投主板。

触摸：用开发板的 I²C 读出触摸芯片的 ID，单点、两点触摸坐标正确，四个角和边缘都能点到。
