TENLEAP-AI/digital-human-koubo/hardware/esp32-s3-board/docs/display-interface-for-vendor.md

# 屏排线接口定义（给屏厂）

日期：2026-11-12。对应主板：Zeebuddy 主板 V1（`hardware/esp32-s3-board/kicad`）。

屏厂按这份定义做排线。脚位顺序是按 LB28BOE47（同为 NV3049F 的 8 位串行 RGB 屏）的排线定的。

> 2026-11-12：屏厂提出可以改成 QSPI 接口。QSPI 的脚位定义和要屏厂答复的问题在
> [display-interface-qspi-proposal.md](display-interface-qspi-proposal.md)，正在等屏厂评估。这一份（串行 RGB）是备选。

## 0. 先要屏厂答复的一件事：现有型号是 MIPI 接口，我们的主板驱动不了

屏厂给的资料是华迪创显 **HD28142C22**（2.83 英寸，480 × 640，驱动芯片 NV3049）：规格书 V1.0（2025-03-25）、
外形图和一份初始化代码。按规格书，这个型号是 **两通道 MIPI-DSI 接口**，22 脚排线上是 D0P/D0N、CLKP/CLKN、D1P/D1N、
RESET 和电源；初始化代码也是 MIPI 的写法（`DCS_Short_Write`，像素时钟 23 MHz，每像素一个时钟，约 60 帧 / 秒）。

**我们的主控 ESP32-S3 没有 MIPI-DSI 接口**，主板是按"8 位串行 RGB + 三线 SPI"设计的（第 1、3 节）。两者接不上。

所以排线不是"换个脚位顺序"的问题，要屏厂确认能不能做一个 **RGB 接口的版本**：

| # | 请屏厂确认 | 屏厂答复 |
|---|---|---|
| A | 这块玻璃上的 NV3049 能不能改成 **8 位串行 RGB（DOTCLK、HSYNC、VSYNC、DE、D7 ~ D0）+ 三线 SPI（CS、SCL、SDA）** 出线？接口模式是靠排线上的配置脚定，还是要换玻璃 | |
| B | 能做的话：按第 3 节的 22 脚定义出一版排线，开模费、起订量、交期 | |
| C | RGB 模式下的初始化代码。现在给的这份是 MIPI 模式的，不能直接用 | |
| D | RGB 模式下每个像素要 3 个时钟。我们的主控只能给 20 ~ 26 MHz，按现有时序（每帧约 115 万个时钟）是 **每秒 17 ~ 22 帧**。这个帧率下能不能正常显示、闪不闪 | |

如果 A 的答复是"做不了"，就要换屏（换成本来就是串行 RGB 接口的型号），或者换主控（带 MIPI 的 ESP32-P4，主板要重做）。
这件事定下来之前，下面的脚位表只是我们这一侧的要求。

## 0.0 NV3049 数据手册里写的接口（2026-11-12 补充）

查了 NV3049 的数据手册（New Vision，2014-08-25，预发布版 V1，267 页）：

| 项目 | 手册的说法 |
|---|---|
| 显存 | **没有**（Without internal GRAM）。图像要由主控不停地送 |
| 图像接口 | 两种：**MIPI-DSI**（两通道），或**并口 RGB**（16 / 18 / 24 位，每个像素一个时钟） |
| 命令接口 | 三线 9 位 SPI |
| 接口怎么选 | 芯片上的 4 个硬件配置脚 IM[3:0]，不是软件能改的 |
| **8 位串行 RGB** | **手册里没有** |
| **QSPI** | **手册里没有** |
| 并口 RGB 的像素时钟 | 周期不小于 28 ns，也就是不超过约 35 MHz |

对我们的意思：

- 按这份手册，这块玻璃不走 MIPI 就只能走**并口 RGB**。16 位并口要 16 根数据线加 4 根同步线，共 20 根，再加 SPI。
  我们的 ESP32-S3 可用的 33 个引脚已经全部分完，屏现在只占 9 个，**再多拿 11 个拿不出来**（除非砍掉摄像头或 TF 卡）。
- 我们的主板是按"8 位串行 RGB"设计的，依据是之前查到的 **NV3049F** 的实际产品（全志平台上有 8 位串行 RGB 的屏在卖）。
  NV3049F 和这份手册里的 NV3049 不是同一版：屏厂给的初始化代码切换寄存器页要连写三次（`FF 30`、`FF 49`、`FF 01`），
  手册里只写一次（`FF 01`）。所以 **F 版支不支持 8 位串行 RGB，这份手册回答不了，要屏厂或芯片原厂答复**。
- QSPI 不是这颗芯片的功能。屏厂说的 QSPI 版本只能是换了另一颗驱动芯片的屏，见 QSPI 提案里的第 1 个问题。

请屏厂补答：HD28142C22 上用的是 NV3049 还是 NV3049F；F 版有没有 8 位串行 RGB 模式，配置脚怎么接。

## 0.1 从 HD28142C22 的资料里已经确认的

这些和接口无关，RGB 版本大概率相同，已经按它改了主板：

| 项目 | 资料里的数值 | 对主板的影响 |
|---|---|---|
| 外形 | 模组 46.90 × 66.55 mm，显示区 43.20 × 57.60 mm，厚 2.37 mm | 结构用 |
| 排线 | 22 脚，0.5 mm 间距，金手指宽 0.30 mm、长 3.5 mm，排线头宽 11.5 mm；从模组下边正中伸出，总长 40 mm；展开出货 | 和我们 J8 的规格一致（22 脚、0.5 mm） |
| 金手指朝向 | 排线展开平放时，金手指在**模组背面那一面**，正面那一面是补强板；**从正面看第 1 脚在左** | 决定上接还是下接，见第 7 节 |
| 背光 | 6 颗灯**串联**，18 V，20 mA；电流的绝对上限也是 20 mA；亮度约 350 cd/m² | 主板的串联恒流升压可以带。电流采样电阻已从 5.1 Ω 改成 **10 Ω（20 mA）**；原来预设的 39 mA 超过上限 |
| 供电 | 接口表写 VCC 2.8 ~ 3.2 V；电气特性表写 VCI 2.5 ~ 3.6 V（典型 2.8 V）、IOVCC 1.65 ~ 3.6 V（典型 1.8 V） | 主板给的是 **3.3 V**，比接口表的 3.2 V 高 0.1 V。请屏厂确认 3.3 V 能不能直接用 |
| 触摸 | 这个型号**不带触摸** | 触摸屏要另配，排线和脚位另定（第 6 节） |

DWG 图纸这边没有打开（没有转换工具），外形和排线的数字取自规格书第 10 页的同一张图。
屏厂的规格书、图纸和初始化代码没有放进仓库。

## 1. 我们怎么用这块屏

| 项目 | 内容 |
|---|---|
| 屏 | LB28BOE47，2.8 英寸，480 × 640，驱动芯片 NV3049F |
| 显示接口 | 8 位串行 RGB（每个像素 3 个时钟），加 HSYNC、VSYNC、DE、DOTCLK |
| 配置接口 | 三线 SPI（CS、SCL、SDA），只用来发初始化命令 |
| 逻辑电平 | 3.3 V |
| 主控 | ESP32-S3（8 MB 八线 PSRAM） |
| **首版只接 5 根数据线** | D7 ~ D3 接主控，D2 ~ D0 在主板上经 0 Ω 接地。每种颜色 32 级 |

## 2. 主板上的排线座

| 项目 | 内容 |
|---|---|
| 位号 | J8 |
| 规格 | 22 脚，0.5 mm 间距，翻盖式 |
| 位置 | 主板**背面**，上边缘。排线从上边缘插入 |
| 第 1 脚 | 距主板左边 10.95 mm（从正面看的坐标）；第 22 脚距左边 21.45 mm。**从背面看，第 1 脚在右边** |
| 上接还是下接 | **还没定**，要和屏厂、结构一起定（见第 6 节） |
| 座子型号 | 还没选。可以按屏厂排线的厚度和金手指来选 |

所有排线座在板上的位置见 [`../kicad/connector-positions.png`](../kicad/connector-positions.png)。

## 3. 脚位

方向一栏："出"是主板输出给屏，"电源"是主板供电。

| 脚 | 名称 | 方向 | 电平 | 主板这边 | 说明 |
|---|---|---|---|---|---|
| 1 | LEDA | 电源 | 约 18 V（最高约 27 V） | 背光升压输出 | 背光正极。串联恒流驱动，见第 5 节 |
| 2 | LEDK | 电源 | 约 0.2 V | 电流采样电阻 10 Ω | 背光负极。恒流 20 mA |
| 3 | SDA | 出 | 3.3 V | I/O 扩展芯片 | SPI 数据。**只写不读**；速度很慢（每秒几千位） |
| 4 | SCL | 出 | 3.3 V | I/O 扩展芯片 | SPI 时钟 |
| 5 | NC | — | — | 不接 | |
| 6 | VCI | 电源 | 3.3 V | 3.3 V 经 0 Ω，旁边 1 µF + 100 nF | 屏的供电。主板只提供 3.3 V 这一路 |
| 7 | D7（G7） | 出 | 3.3 V | ESP32 GPIO42 | 数据最高位 |
| 8 | D6（G6） | 出 | 3.3 V | ESP32 GPIO41 | |
| 9 | D5（G5） | 出 | 3.3 V | ESP32 GPIO40 | |
| 10 | D4（G4） | 出 | 3.3 V | ESP32 GPIO39 | |
| 11 | D3（G3） | 出 | 3.3 V | ESP32 GPIO38 | |
| 12 | D2（G2） | — | 0 V | 经 0 Ω 接地 | 首版不驱动 |
| 13 | D1（G1） | — | 0 V | 经 0 Ω 接地 | 首版不驱动 |
| 14 | D0（G0） | — | 0 V | 经 0 Ω 接地 | 首版不驱动 |
| 15 | CS | 出 | 3.3 V | I/O 扩展芯片 | SPI 片选 |
| 16 | DOTCLK | 出 | 3.3 V | ESP32 GPIO47，串 33 Ω | 像素时钟。计划 20 ~ 26 MHz |
| 17 | HSYNC | 出 | 3.3 V | ESP32 GPIO44，串 100 Ω | 和主控的串口 0 接收脚共用 |
| 18 | DE | 出 | 3.3 V | ESP32 GPIO48 | |
| 19 | VSYNC | 出 | 3.3 V | ESP32 GPIO43，串 470 Ω | 和主控的串口 0 发送脚共用：上电后约 1 秒内这根线上有启动信息的波形，此时屏处于复位 |
| 20 | RST | 出 | 3.3 V | I/O 扩展芯片，主板有 4.7 kΩ 下拉 | 低有效。上电默认低，主控初始化完才释放 |
| 21 | GND | 电源 | 0 V | 地 | |
| 22 | GND | 电源 | 0 V | 地 | |

## 4. 请屏厂确认或提供

| # | 事项 | 屏厂答复 |
|---|---|---|
| 1 | 排线图：长度、宽度、出线位置、弯折位置、金手指朝哪一面、补强板、第 1 脚标记 | |
| 2 | NV3049F 在 **8 位串行 RGB、480 × 640** 下的完整初始化代码，以及三线 SPI 的格式（每帧几位、先发高位还是低位） | |
| 3 | 时序：DOTCLK 的最小、典型、最大值；每个像素 3 个时钟的颜色顺序；HSYNC、VSYNC、DE 的极性；行、场消隐 | |
| 4 | 最低刷新率。我们的主控只能做到 **20 ~ 25 帧 / 秒**（DOTCLK 20 ~ 26 MHz），这个帧率下能不能正常显示、有没有闪烁 | |
| 5 | 只接 D7 ~ D3、D2 ~ D0 接地时显示是否正常 | |
| 6 | 背光：RGB 版本是否仍是 6 颗灯串联、18 V、20 mA（规格书第 4 页写 6 颗，第 6 页的文字写 4 颗，以哪个为准） | |
| 7 | 主板只给一路 3.3 V：能不能直接接 VCC；是否还需要单独的 1.8 V 接口电源；电流多大 | |
| 8 | 上电顺序的要求：VCI、RST、信号线各自的先后和间隔 | |
| 9 | 第 19 脚（VSYNC）在复位期间有波形，屏能否承受 | |
| 10 | 触摸：芯片型号、I²C 地址、排线脚位；触摸和屏是分开两条排线还是合成一条 | |

## 5. 背光

主板的背光电路是**串联恒流升压**：输出电压自动跟随灯串，最高约 27 V（过压保护点约 30 V），电流由一颗电阻定。
按 HD28142C22 的规格书（6 颗灯串联、18 V、20 mA，绝对上限 20 mA），电阻取 10 Ω，电流 20 mA。主控用 PWM 调光，只能往下调。

如果 RGB 版本的背光和这个不一样（比如并联的低压背光），要提前告诉我们改电路。

## 6. 触摸排线座（J9）

HD28142C22 不带触摸，触摸屏要另配。下面是按常见定义占位的，**没有依据，等触摸屏的供应商给脚位**：

| 脚 | 我们的假设 | 主板这边 |
|---|---|---|
| 1 | VDD 3.3 V | 3.3 V |
| 2 | GND | 地 |
| 3 | SCL | I²C 时钟（和摄像头、扩展芯片、充电芯片共用一条总线） |
| 4 | SDA | I²C 数据 |
| 5 | INT | I/O 扩展芯片（输入） |
| 6 | RST | I/O 扩展芯片，有 10 kΩ 上拉 |

位置：主板背面，上边缘，J8 左边（从正面看的坐标：第 1 脚距左边 3.75 mm，第 6 脚 6.25 mm）。6 脚，0.5 mm 间距。

触摸芯片的 I²C 地址不能和板上已有的冲突：扩展芯片 0x20、0x22，充电芯片 SY6970（0x6A），摄像头（OV2640 是 0x30，
前摄待定，常见的占 0x21）。

## 7. 还没定、会影响排线的事

1. **上接还是下接。** 同一条排线插上接座和下接座，第 1 脚的位置正好相反。判断方法：把排线按整机里真实的走法弯到主板的座子上，
   看金手指朝哪边——**朝着主板板面的用下接座，背着板面的用上接座**。现有排线的金手指在模组背面那一面，从正面看第 1 脚在左；
   主板的 J8 在背面、上边缘，从背面看第 1 脚在右。屏和主板在整机里怎么叠、排线从屏的下边绕到主板的哪条边，要结构先给出来。
   定下来之后按 1:1 打印核对一次再开模。
2. **排线长度和弯折。** 取决于屏和主板在整机里的相对位置，由结构给出。
3. **座子型号。** 定了上接或下接、排线厚度之后选。
