TENLEAP-AI/digital-human-koubo/hardware/esp32-s3-board/docs/layout-spec.md

# 主板 PCB 布局布线规范（六层版，V0.4）

适用于 Zeebuddy 主板 V1（ESP32-S3-WROOM-1U + Air780E，64 × 34 mm，两面贴件）六层版。
原理图和引脚分配见 [requirements.md](requirements.md) 和 `../kicad/`。

## 版本记录

| 版本 | 日期 | 改动 | 依据 |
|---|---|---|---|
| V0.1 | 2026-11-11 | 初稿 | — |
| V0.4 | 2026-11-12 | USB-7 按两路 USB 的速度分开写：Type-C 一路只到 ESP32-S3（全速），保护器件电容放宽到 ≤4 pF | 乐鑫文档：ESP32-S3 的 USB 只有全速 12 Mbps；独立复查指出现选件 3.5 pF 与原条文矛盾 |
| V0.3 | 2026-11-11 | PWR-16 的汇合点改到充电芯片系统输出的电容处；PWR-3 放宽到 1.8 mm；PWR-1 写明引脚处和不走负载电流的支路怎么算，并给 3.3 V 降压输入、背光两条小电流支路定了宽度（0.6 / 0.3 mm）。前两条是确认过的；PWR-1 的补充是做板时发现原规则在引脚处无法执行而加的，**还需要确认** | 实际电路和封装尺寸 |
| V0.2 | 2026-11-11 | 板厚改 1.6 mm；天线线改"0.34 mm 线 + 只在天线座信号焊盘下开窗"；L4 先只放 3.3 V、大电流全走外层；内层 0.5 oz 载流数字更正；C19 增加 ESR 与器件类型；VBUS 改 1.0 mm 并补 3.3 V 宽度；USB-6 降为建议；新增 PWR-16、RTN-1、TST-1、THM-1、AUD-2、SSM-1、VIP-1；新增第 11 节脚本清单 | 评审意见 + 嘉立创叠层 + 实板限制 |

## 待定问题

下面几处是对照原理图和实际摆放时发现的，**正文还没改**，等确认：

| 条目 | 问题 | 建议 |
|---|---|---|
| PWR-9 | 要求 VBUS 全程 ≥1.0 mm。Type-C 的两组供电脚旁边各有一个定位柱，和保护芯片之间只剩 1.07 mm，放不下 1.0 mm 的线。现在是两组脚各引一条 0.6 mm 的线（并联，合计 1.2 mm），长约 7 mm，到 TVS 处汇成 1.0 mm | 改为"两组供电脚各自引出时，两条合计 ≥1.0 mm" |
| PWR-7 | 第 11.2 节的判据是"TVS 到接口 ≤2 mm"。Type-C 这一侧正面 2 mm 以内被保护芯片和定位柱占满，TVS（D1，SOD-123F）放在离供电脚约 6 mm 处；电流确实先经过它的焊盘 | 换小一号的 TVS（如 SOD-323），或者把判据放宽到 7 mm |
| PWR-11 | 充电芯片的输入电容（C3）：芯片的 PMID 脚和 PGND 脚之间隔着开关脚，同一面上没法直接用铜皮把电容的地接回 PGND。现在电容离引脚 0.7 mm，地焊盘旁打孔到相邻的地层（0.21 mm），再从芯片底部焊盘的 6 个孔回来 | 这种引脚排列只能这样做；规则加一句"引脚排列不允许时，经相邻地层回流，孔紧挨焊盘" |
| USB-3 | 四段里三段没达标（长度差 1.8 / 3.3 / 2.6 mm）。常见设计指南对高速 USB 的上限是约 3.8 mm，功能上不会有问题 | 信号线布完后单独调等长，或者把每段的要求放宽到 ≤3 mm |
| 5.1 | "天线座信号焊盘是一个明显的电容，会让匹配变差"说重了。按 0.21 mm 的介质估算，这个焊盘比同样长度的 50 Ω 线只多出约 0.1 pF，影响不大 | 开窗保留（成本很低，是常规做法），措辞改轻 |
| 13.1 | 叠层型号 `JLC06161H-7628` 和外层 0.2104 mm 还没有在嘉立创下单页核实 | 核实前，线宽 0.34 mm 等都是设计值 |
| 14 节 EVD-1 | 原稿这一行不完整 | 级别和检查方式是入库时补的 |

## 本版相对 V0.1 的主要改动

- 板厚 0.8 → 1.6 mm，叠层按外层 7628 预浸料（约 0.21 mm）设计。50 Ω 线宽由 0.17 mm 变为 0.34 mm。
- 取消"沿全线挖空 L5"。L5 全程保持完整，只在天线座的信号焊盘下开一个小窗（RF-3）。RF-3 / RF-4 / RF-5 全部重写。
- L4 先只放 3.3 V，大电流（VBAT / VSYS / VDD_4G / VBUS）全部走外层。PWR-1 重写。
- 内层 0.5 oz 的载流数字更正为 1.80 / 4.67 mm（原来按 17.5 µm 算的 1.56 / 4.07 偏小）。
- C19 增加 ESR ≤ 50 mΩ 和器件类型要求，否则 300 mV 的验收指标做不到。
- VBUS 0.8 → 1.0 mm，补 3.3 V 的宽度要求。
- USB-6 降为建议，允许 ≤1.5 mm 的短分支。
- 删除"功放从 3.3 V 取电"（会明显降低输出功率），改为 PWR-16：功放和 4G 从同一汇合点各走各的铜皮。
- 新增 RTN-1（回流路径）、TST-1（测试点清单）、THM-1（散热铜面积）、AUD-2（功放类型）、SSM-1（叠层对称）、VIP-1（焊盘内打孔）。
- 新增第 11 节：把原来标"人工"的 7 条改成脚本可查，并给出判据。

## 怎么读这份规范

- 每条规则有编号（如 `PWR-3`），评审和检查时按编号对。
- "级别"：**必须** = 不满足不能投板；**建议** = 做不到要写明原因。
- "检查"：**DRC** = 写进 KiCad 的规则，软件自动查；**脚本** = 用脚本量出数字；**人工** = 对着图看，且必须是不可计算的项（见 11.3）。
- "依据"：**你** = 你提的四条要求；**合宙** = 合宙 Air780E 的设计指导文档；**估算** = 用公式算的；**经验** = 通用工程做法。
- 标 **待确认** 的数字是占位，要板厂或你给了信息才能定；每条待确认在第 13 节都有默认值。

---

## 1. 叠层和各层用途

成品板厚 1.6 mm，外层 1 oz，内层 0.5 oz。叠层按嘉立创六层阻抗叠层（外层 7628 预浸料）设计，具体型号下单时确认（见 13.1）。

| 层 | 名称 | 用途 | 说明 |
|---|---|---|---|
| L1 | 正面 | 元件 + 短线 | "低"的一面：小元件、前摄和按键的排线座、麦克风 |
| L2 | 地 | 整层地 | 正面和 L3 的回流层，不走线 |
| L3 | 信号 | 主要走线层 | 夹在 L2 和 L4 之间，长线、总线、时钟优先走这里 |
| L4 | 电源 | 3.3 V 铺铜；天线座开窗正下方的一小块地 | 先只放 3.3 V，不放信号（见 STK-6） |
| L5 | 地 | 整层地 | 背面所有线的回流层，不走线；只在 RF-3 的窗里开口 |
| L6 | 背面 | 元件 + 短线 + 大电流铜皮 | "高"的一面：两个模组、对外接口、天线线、USB、电池和充电的铜皮 |

参考尺寸（待板厂确认，见 13.1）：

| 位置 | 材料 | 厚度 |
|---|---|---|
| L1 / L6 铜 | 1 oz | 0.035 mm |
| L1–L2 介质 | 7628 预浸料（εr≈4.4） | 0.2104 mm |
| L2–L3 / L3–L4 / L4–L5 介质 | 芯板 / 预浸料（εr≈4.6） | 各约 0.35 mm |
| L5–L6 介质 | 7628 预浸料 | 0.2104 mm |
| L2 / L3 / L4 / L5 铜 | 0.5 oz | 0.0152 mm |

| 编号 | 规则 | 级别 | 检查 | 依据 |
|---|---|---|---|---|
| STK-1 | L2、L5 只铺地，不走任何线。唯一的开口是 RF-3 的局部开窗 | 必须 | DRC | 经验 |
| STK-2 | L3 以横向走线为主，L4 以纵向为主；两层的线不允许上下重叠平行走超过 5 mm | 建议 | 脚本 | 经验 |
| STK-3 | 只用通孔，不用盲孔、埋孔 | 必须 | DRC | 成本 |
| STK-4 | 外层铜厚 1 oz，内层 0.5 oz（以板厂标准叠层为准） | — | 下单 | — |
| STK-5 | 板厚 1.6 mm | 必须 | 下单 | 已定 |
| STK-6 | L4 先按"只放 3.3 V 铺铜、不放信号"布。布不通时允许放信号，但必须满足：① 3.3 V 到每个用电点的最窄通道 ≥1.8 mm；② 不在 L3 总线正下方平行走超过 5 mm（与 STK-2 同一条）；③ 不切断天线座开窗下方的地 | 建议 | 脚本 | 你 |
| STK-7 | 叠层关于中心对称：介质厚度和铜厚上下对称，避免 1.6 mm 板过炉翘曲 | 必须 | 下单 | 经验 |

**为什么是 1.6 mm 而不是 0.8 mm**：0.8 mm 时外层介质只能取最薄的约 0.1 mm，50 Ω 微带只有 0.15 ~ 0.17 mm，
比 0402 焊盘（约 0.5 mm）和天线座焊盘窄得多，只能靠"把 L5 整条挖掉、改参考 L4"来解决。
1.6 mm 可以用 7628 外层（约 0.21 mm），50 Ω 直接就是 0.34 mm，和焊盘宽度接近，L5 全程保留完整。
这一步把第 5 节的复杂度去掉了一大半。

---

## 2. 布线顺序

1. **定叠层和规则。** 确认嘉立创六层 1.6 mm 的阻抗叠层型号，拿到各层厚度后，用阻抗计算器算出天线线（50 Ω）和 USB（90 Ω）的线宽线距，写进 KiCad 的规则。
2. **按规范复查摆放。** 先改已知不符合的地方（见第 12 节），并处理剩下的 3 处元件间距冲突。
3. **先布关键线，布完锁定**，顺序：天线线 → 电源铜皮（电池、Air780E、充电）→ 三个开关电源的回路 → 去耦电容到引脚 → USB 四段差分线 → 时钟线。
4. **扇出。** 两个模组和各排线座的引脚先用短线加过孔引到 L3 / L4。优先把过孔放在焊盘外；焊盘内打孔只按 VIP-1 的限定用。
5. **布其余的线。** 长的总线（摄像头、屏）走 L3，纵向连接走 L4，短连接留在 L1 / L6。自动布线（扩展后的程序或 Freerouting）可以走 L3 / L4，L2 / L5 已排除。
6. **铺铜和打地孔。** L1 / L6 空余处铺地，L4 铺 3.3 V，按规则补地孔。
7. **检查。** KiCad DRC（含自定义规则）→ 脚本量数字出"规则 — 实测 — 是否通过"表 → 原理图一致性。全部通过后再交人工评审。
8. **人工评审。** 按 11.3 的清单过一遍，签字。

---

## 3. 通用规则

| 编号 | 项目 | 数值 | 级别 | 检查 |
|---|---|---|---|---|
| GEN-1 | 普通信号线宽 | 0.15 mm；引脚之间窄处允许 0.10 mm，长度 ≤3 mm | 必须 | DRC |
| GEN-2 | 铜到铜间距 | 最小 0.10 mm，有空间处 0.15 mm | 必须 | DRC |
| GEN-3 | 信号过孔 | 孔 0.2 mm / 外径 0.45 mm | 必须 | DRC |
| GEN-4 | 电源过孔 | 孔 0.3 mm / 外径 0.6 mm | 必须 | DRC |
| GEN-5 | 孔壁到孔壁 | ≥0.25 mm | 必须 | DRC |
| GEN-6 | 铜到板边 | ≥0.3 mm | 必须 | DRC |
| GEN-7 | 过孔到焊盘 | ≥0.15 mm，不在焊盘上打孔（芯片散热焊盘和 VIP-1 允许的除外） | 必须 | DRC |
| GEN-8 | 过孔盖油 | 除 VIP-1 的塞孔外全部盖油 | 必须 | 下单 |
| GEN-9 | 拐弯 | 用 45° 或圆弧，不用直角 | 建议 | 人工 |
| GEN-10 | 时钟和 USB 换层时 | 1 mm 以内配一个地孔 | 必须 | 脚本 |

**0.2 mm 孔的长径比**：1.6 mm 板 + 0.2 mm 孔 = 8:1，在嘉立创常规能力的上限。不要再往 0.15 mm 走
（10.7:1，电镀均匀性和塞孔都不可靠）。所以 GEN-3 的 0.2 mm 是下限，不是"可以再小一点"。

---

## 4. 电源

### 4.1 设计电流

| 网络 | 设计电流 | 来历 |
|---|---|---|
| 电池 → 充电芯片 → 系统（VBAT、VSYS） | 3 A | 4G 发射 + 3.3 V + 功放 + 背光同时工作，留余量 |
| Air780E 供电（VDD_4G） | 2 A | 合宙标称峰值 1 A（FDD 最大发射时平均 600 ~ 700 mA），取 2 倍余量 |
| Type-C 输入（VBUS） | 2 A | 硬件限流约 0.53 A，按固件以后可能调高留余量 |
| 3.3 V 主干 | 1 A | ESP32 发射峰值约 0.5 A，加屏、摄像头、卡 |
| 喇叭输出 | 1 A | 功放满功率（用电池电压，见 PWR-16） |

### 4.2 铜皮载流（IPC-2221，温升 10 °C）

| 层 | 1 A | 2 A | 3 A |
|---|---|---|---|
| 外层 1 oz（35 µm） | 0.30 mm | 0.78 mm | 1.37 mm |
| 内层 0.5 oz（15.2 µm，嘉立创实际值） | 1.80 mm | 4.67 mm | 8.16 mm |

外层按嘉立创实际 1.6 mil（约 40 µm）复算会更小（0.26 / 0.67 / 1.18），所以上表的外层一列是保守值，可以放心用。
内层一列必须按 15.2 µm 算——比按名义 17.5 µm 算大约大 15%，这是 V0.1 的一处错误。

**结论：大电流一律走外层（L6）。** 3 A 走内层 0.5 oz 要 8 mm 宽，这块板放不下。

### 4.3 规则

| 编号 | 规则 | 级别 | 检查 | 依据 |
|---|---|---|---|---|
| PWR-1 | VBAT、VSYS、VDD_4G 用外层（L6 为主）铜皮，不用线、不上 L4。最窄处 ≥2.0 mm；焊盘入口处允许收窄到 1.0 mm，长度 ≤2 mm；L6 上不得被模组焊盘或过孔阵列切断。芯片引脚处按引脚本身的宽度（充电芯片每组只有两个 0.28 mm 的引脚）。这条管的是走负载电流的路径：电池 → 充电芯片 → 汇合点 → Air780E，以及功放支路；去测试点、上拉电阻、小滤波电容的支路不走负载电流，用 ≥0.3 mm 的线即可；3.3 V 降压的输入支路 ≥0.6 mm，背光支路 ≥0.3 mm | 必须 | 脚本 | 你 |
| PWR-2 | 电池焊盘到 Air780E 供电脚，铜皮总长 ≤30 mm、电阻 ≤15 mΩ（外层 1 oz 约 0.5 mΩ/方块） | 必须 | 脚本 | 你、估算 |
| PWR-3 | Air780E 的 220 µF（C19）正极焊盘到模组供电脚 ≤1.8 mm（合宙的封装自带约 1.2 mm 的外框，电容进不去），且电容在电流的必经之路上，不是挂在旁边的支路 | 必须 | 脚本 | 你、合宙 |
| PWR-4 | C19 必须是低 ESR 的聚合物钽或高分子电容，ESR ≤50 mΩ；不得用 MLCC 代 220 µF（直流偏压下容值会掉 40 ~ 60%） | 必须 | 人工 + BOM | 合宙、估算 |
| PWR-5 | C19 的地焊盘旁打 ≥3 个 0.3 mm 地孔，离焊盘 ≤1 mm | 必须 | 脚本 | 经验 |
| PWR-6 | Air780E 的小滤波电容放在供电脚正对面（另一面），过孔紧挨焊盘 | 必须 | 脚本 | 合宙 |
| PWR-7 | 电源的保护管（TVS）放在电源进来的那一端，电流先过保护管 | 必须 | 脚本 | 合宙 |
| PWR-8 | VBAT、VSYS、VDD_4G 换层时用 ≥4 个 0.3 mm 过孔；VBUS 和 3.3 V 主干 ≥2 个 | 必须 | 脚本 | 经验 |
| PWR-9 | VBUS 从 Type-C 到充电芯片线宽 ≥1.0 mm | 必须 | DRC | 估算 |
| PWR-10 | 3.3 V 主干：外层 ≥0.6 mm，L4 铺铜最窄处 ≥1.8 mm | 必须 | 脚本 | 估算 |
| PWR-11 | 开关电源（充电、3.3 V 降压、背光升压）：输入电容、输出电容紧贴芯片引脚，电容的地和芯片的地在同一面直接用铜皮连，不靠过孔绕到别的层 | 必须 | 脚本 | 合宙 |
| PWR-12 | 开关节点（芯片到电感）的铜尽量小，长度 ≤3 mm，不打过孔，不铺大铜皮 | 必须 | 脚本 | 合宙 |
| PWR-13 | 反馈线从输出电容取，0.15 mm，离电感和开关节点 ≥1 mm | 必须 | 脚本 | 经验 |
| PWR-14 | 充电芯片底部散热焊盘打 ≥5 个地孔；功放底部散热焊盘 ≥4 个 | 必须 | 脚本 | 经验 |
| PWR-15 | 3.3 V 用 L4 的铺铜分配，每个用电点自己打孔取电 | 建议 | 脚本 | 经验 |
| PWR-16 | 功放和 4G 从同一个汇合点各走各的铜皮：汇合点放在充电芯片系统输出（VSYS）的电容处，两路铜皮各自 ≥PWR-1 的宽度，中间不共用任何一段窄路；功放的输入电容就近放在功放脚边 | 必须 | 脚本 | 你 |
| PWR-17 | 喇叭两根输出线 ≥0.4 mm，并排走，离麦克风和天线线 ≥3 mm | 必须 | 脚本 | 经验 |
| PWR-18 | 背光升压输出到屏的两根线 0.25 mm，与其它线间距 ≥0.2 mm（这里电压最高到 30 V） | 必须 | DRC | 经验 |

**关于功放供电（V0.2 修正，V0.3 更正网络名）**：功放接电池电压，不接 3.3 V——接 3.3 V 会明显降低输出功率。
实际电路里功放、4G 电源开关、3.3 V 降压、背光都接在充电芯片的系统输出（VSYS）上，电池（VBAT）只接充电芯片。
因此功放和 Air780E 同属 VSYS 网络，隔离只能靠布局：星形汇合点 + 各自独立的铜皮 + 功放自己的输入电容。
功放的地回流不要从模组下方穿过。

**实物验收**：电池 3.6 V 和满电 4.2 V 各测一次；4G 满功率发射时用示波器量模组供电脚对模组地脚（不是对板边地），
跌落 ≤300 mV 且不低于 3.3 V。测试时记录电池型号、引线长度和发射功率档位。

---

## 5. 4G 天线线

这块板**没有板载天线**。4G 走 IPEX 座（J7）接外置天线，Wi-Fi 用 ESP32 模组自带的 IPEX 座，板上没有 Wi-Fi 射频线。
本节管的是"模组天线脚 → 匹配元件 → IPEX 座"这一段。

### 5.1 结构（V0.2 改为局部开窗）

1.6 mm 板、外层 7628（0.21 mm）时，50 Ω 微带是 0.34 mm，和 0402 焊盘（0.5 mm）、天线座信号焊盘（约 1 mm）宽度接近，
**不需要沿全线挖空 L5**。但天线座的信号焊盘仍比线宽大得多，在这个高度下是一个明显的电容，会让匹配变差，
所以**只在这个焊盘下面开窗**，把它的参考面从 L5（0.21 mm）推到 L4（约 0.56 mm），电容降一半以上。

结构尺寸（板厂确认叠层后按计算器复核）：

| 项 | 数值 | 说明 |
|---|---|---|
| L6 → L5 介质 | 0.2104 mm | 7628 预浸料 |
| 线宽 w | 0.34 mm | 50 Ω 单端；JITX 对该叠层算得 0.3421，独立复算 0.35 |
| 两侧共面间隙 g | 0.20 mm（初值） | 由计算器定；共面的地在 L6，紧贴线两侧 |
| L5 开窗 | 只在 J7 信号焊盘下，焊盘外形每边放 0.3 mm | 其余 L5 全程完整 |
| 开窗正下方 L4 | 连续地，比开窗每边大 ≥1.0 mm | 参考面从 L5 切到 L4 时的落点 |
| 共面地与线边 | = g | 与开窗宽度无关，两个是不同的尺寸 |

不要把 C29 / C30 的地焊盘包进开窗——那两个电容的地要靠 L5 地，开窗会把它们的地回流切断。开窗边缘离任何地焊盘 ≥0.2 mm。

下单时给板厂一张截面图，标出六个数（w、g、L6→L5 厚度、开窗宽度、开窗下方 L4 到 L6 的总厚、铜厚）。
不要用"5 倍线宽"这种间接量——板厂按"5 倍线宽"和按"共面波导"算，会得到两个不同的 w。

### 5.2 规则

| 编号 | 规则 | 级别 | 检查 | 依据 |
|---|---|---|---|---|
| RF-1 | 特征阻抗 50 Ω ±10%，整段都要控制。线宽和间隙用板厂阻抗计算器按实际叠层算，算完填进上表 | 必须 | 板厂 | 你、合宙 |
| RF-2 | 只走 L6，不打过孔，不分叉 | 必须 | DRC | 合宙 |
| RF-3 | L5 只在 J7 信号焊盘下开窗（尺寸见 5.1），其余全长保持完整地；开窗不得覆盖任何电容的地焊盘 | 必须 | 脚本 | 合宙、你 |
| RF-4 | 开窗正下方的 L4 是连续地，比开窗每边大 ≥1.0 mm，中间不走任何线、不铺 3.3 V | 必须 | DRC | 合宙 |
| RF-5 | 线两侧的 L6 地铜上打地孔，间距 ≤2 mm，把 L6、L5、L4、L2 的地连起来；开窗范围内不要求连 L5 | 必须 | 脚本 | 合宙、估算 |
| RF-6 | 模组脚到天线座总长 ≤15 mm | 必须 | 脚本 | 合宙 |
| RF-7 | 拐弯用 135° 或圆弧 | 必须 | 脚本 | 合宙 |
| RF-8 | π 型匹配（R49 串联、C29 / C30 并联）紧挨天线座；并联电容的焊盘直接压在线上，不引支线；每个电容的地焊盘旁各打一个地孔 | 必须 | 脚本 | 合宙 |
| RF-9 | 相邻层没有与它平行或交叉的信号线；L6 上其它信号离它 ≥1 mm | 必须 | DRC | 合宙 |
| RF-10 | 电感、开关节点、喇叭输出离天线线和天线座 ≥5 mm | 建议 | 脚本 | 合宙 |
| RF-11 | 天线座的每个地焊盘旁打 ≥2 个地孔 | 必须 | 脚本 | 经验 |
| RF-12 | 下单时把这段线标出来，要求板厂做阻抗控制并提供阻抗报告 | 必须 | 下单 | 合宙 |

RF-5 的 2 mm：合宙给的最高频率约 2.66 GHz，板上波长约 64 mm，二十分之一是 3.2 mm，取 2 mm 留余量（估算）。

**分支 B**：如果板厂确认 1.6 mm 六层只有 0.1 mm 外层介质的叠层（没有 7628 档），退回 V0.1 的
"沿全线挖空 L5、参考 L4、线宽 0.4 mm"方案，并把 RF-3 / RF-4 改回原样。这个分支必须在 13.1 确认之后二选一，不能两套混用。

**天线下方净空**：净空针对天线本体。外置天线贴在外壳里的位置，附近不要有电池、屏的金属背板、喇叭，
4G 和 Wi-Fi 两根天线要分开。具体距离以天线厂规格书为准，并在外壳设计阶段就找天线厂评估（合宙）。

---

## 6. USB

涉及四段：Type-C（J1）→ 保护器件（U1）→ 切换芯片（U6）→ Air780E；以及切换芯片 → ESP32。
Air780E 那一路是高速 USB，按最严的要求做；ESP32 那一路速度低，用同一套规则。

| 编号 | 规则 | 级别 | 检查 | 依据 |
|---|---|---|---|---|
| USB-1 | 差分阻抗 90 Ω ±10%，线宽线距用板厂计算器算。同一叠层下 100 Ω 的参考点是 0.172 / 0.15，90 Ω 大约 0.19 / 0.15，以计算器为准 | 必须 | 板厂 | 合宙 |
| USB-2 | 每一段的两根线全程并排、同层、同时换层，间距固定 | 必须 | DRC | 你、合宙 |
| USB-3 | 对内长度差：每段 ≤0.5 mm，从接口到芯片整条路径 ≤1.0 mm。从焊盘量到焊盘，不算分支 | 必须 | 脚本 | 你 |
| USB-4 | 长度补偿（绕线）做在产生长度差的那一端附近 | 建议 | 人工 | 经验 |
| USB-5 | 每根线换层 ≤2 次；两根线的过孔并排对称，旁边各配一个地孔 | 必须 | 脚本 | 合宙 |
| USB-6 | 不留分支：测试点（TP14 / TP15）优先直接压在线上；允许 ≤1.5 mm 的短分支（1 mm 盘和 2 mm 分支的附加电容相当，都约 0.1 pF 量级） | 建议 | 脚本 | 你、估算 |
| USB-7 | 保护器件紧挨 Type-C 座。Type-C 这一路只通到 ESP32-S3，是全速（12 Mbps），保护器件每线电容 ≤4 pF 即可（现选 USBLC6-2SC6，手册最高 3.5 pF），第 5 脚接 VBUS。Air780E 的 USB 是高速口：如果以后在它那一侧（模组到 USB 切换芯片之间）加保护器件，电容要 <1 pF | 必须 | 脚本 | 合宙、乐鑫 |
| USB-8 | 差分对与其它信号间距 ≥0.5 mm，与时钟线、开关节点 ≥1.0 mm | 必须 | DRC | 经验 |
| USB-9 | 走线下方的参考层连续，不跨铺铜的缝 | 必须 | 人工 | 经验 |

USB-3 说明：常见设计指南给高速 USB 的上限是 150 mil（约 3.8 mm），这里收紧到 1.0 mm。
四层版量到的是 1.5 / 0 / 0.9 / 2.2 mm，不满足。

USB-6 说明：V0.1 要求"必须压在线上"，其实两种做法的附加电容差不多，压线并不是天然更好；
而且 1 mm 的盘压在细线上会破坏 USB-2 的"间距固定"。所以降为建议，给 1.5 mm 的余地。

---

## 7. 去耦电容和两个模组

| 编号 | 规则 | 级别 | 检查 | 依据 |
|---|---|---|---|---|
| DEC-1 | 每个电源脚的去耦电容离引脚 ≤2 mm（焊盘边到焊盘边）；大小电容都有时，小的更靠近引脚 | 必须 | 脚本 | 你 |
| DEC-2 | 先过电容再进芯片：供电从过孔或铜皮先到电容焊盘，再到引脚；引脚自己不另外打孔接电源层 | 必须 | 脚本 | 你 |
| DEC-3 | 每个电容的地焊盘旁打自己的地孔，离焊盘 ≤0.5 mm；最多两个电容共用一个 | 必须 | 脚本 | 经验 |
| DEC-4 | ESP32 模组 3V3 脚：过孔 → 22 µF（C12）→ 100 nF（C13）→ 引脚，线宽 ≥0.4 mm | 必须 | 脚本 | 你 |
| DEC-5 | ESP32 的使能脚的阻容紧挨引脚 | 必须 | 脚本 | 经验 |
| DEC-6 | ESP32 模组底部的地焊盘打 ≥9 个地孔（3×3 网格）；Air780E 的每个地焊盘旁打一个地孔 | 建议 | 脚本 | 经验 |
| DEC-7 | 摄像头的 2.8 V、1.2 V 稳压芯片和电容放在摄像头排线座旁，电容离座子引脚 ≤2 mm | 必须 | 脚本 | 经验 |

DEC-6 说明：V0.1 写 ≥6 个，偏少。底部地焊盘同时承担散热和射频地，建议 3×3 起，空间允许就加密。

---

## 8. 其它信号

| 编号 | 规则 | 级别 | 检查 | 依据 |
|---|---|---|---|---|
| SIG-1 | SIM 卡的线尽量短（本板目标 ≤30 mm），离天线线和 Air780E 电源铜皮 ≥1 mm | 必须 | 脚本 | 合宙 |
| SIG-2 | SIM 的时钟线和数据线之间夹一条地；复位线两侧也有地 | 必须 | 脚本 | 合宙 |
| SIG-3 | SIM 的保护管、串联电阻、电容放在卡座旁 3 mm 内 | 必须 | 脚本 | 合宙 |
| SIG-4 | 时钟线（摄像头主时钟和像素时钟、屏的像素时钟、TF 卡时钟、音频位时钟）：串联电阻离驱动端 ≤3 mm；优先走 L3；与其它线间距 ≥0.3 mm；换层 ≤2 次 | 必须 | DRC + 脚本 | 经验 |
| SIG-5 | 摄像头并口、屏的并口各自成组走，同一组用相同的层；组内最长和最短相差 ≤10 mm | 建议 | 脚本 | 估算 |
| SIG-6 | TF 卡的时钟、命令、数据线长度相差 ≤5 mm | 建议 | 脚本 | 经验 |
| SIG-7 | I²C 的上拉电阻只放一处；I²C 不与时钟线平行走超过 10 mm | 建议 | 脚本 | 经验 |
| SIG-8 | 麦克风的三根线和它的电源远离喇叭输出线、背光升压 ≥3 mm；麦克风的电容离引脚 ≤1 mm | 必须 | 脚本 | 经验 |
| SIG-9 | 对外接口（Type-C、SIM、TF、按键排线）的保护器件放在接口旁，信号先过保护器件再往里走，保护器件的地孔离焊盘 ≤0.5 mm | 必须 | 脚本 | 经验 |

SIG-5 说明：这些总线的时钟不超过几十 MHz，10 mm 的长度差只相当于约 70 皮秒，对时序没有影响（估算）。

---

## 9. 地和铺铜

| 编号 | 规则 | 级别 | 检查 |
|---|---|---|---|
| GND-1 | L2、L5 除了过孔的让位孔和 RF-3 的开窗之外保持完整；成排的过孔要错开，不能把地切出超过 3 mm 的缝 | 必须 | 脚本 |
| GND-2 | L1、L6 空余处铺地，孤立的小铜皮去掉；铺铜与线的间距 0.2 mm | 必须 | DRC |
| GND-3 | 地孔：整板间距 ≤5 mm 一个，板边一圈 ≤5 mm | 建议 | 脚本 |
| GND-4 | 接口和模组的每个地焊盘都有自己的地孔 | 必须 | 脚本 |
| GND-5 | 三个带铜环的螺丝孔接地，并连到 L2、L5 | 必须 | DRC |
| GND-6 | 0402、0603 的焊盘接大铜皮时用十字连接；模组、电感、钽电容、接口的电源和地焊盘用实心连接 | 建议 | 人工 |

---

## 10. 摆放和生产工艺

| 编号 | 规则 | 级别 | 检查 | 依据 |
|---|---|---|---|---|
| DFM-1 | 重的器件（两个模组、钽电容、充电电感、卡座、Type-C）都在背面；背面第二次过炉 | 必须 | 人工 | 合宙 |
| DFM-2 | 小元件之间的间距 ≥0.3 mm | 必须 | DRC | 经验 |
| DFM-3 | Air780E 四周：合宙建议留 3 mm，本板做不到，现在最小 1.3 mm。贴片前把周边器件的高度列出来一起问贴片厂 | — | 人工 | 合宙 |
| DFM-4 | 除接口外，元件离板边 ≥1.0 mm；螺丝孔周围 2 mm 内不放元件 | 必须 | DRC | 经验 |
| DFM-5 | 每面 3 个定位点（1 mm 铜点、2 mm 开窗）。板上放不下就放在拼板的工艺边上 | 必须 | 人工 | 经验 |
| DFM-6 | 拼板加工艺边；连接点避开 Type-C、SIM、TF、天线座 | 必须 | 人工 | 经验 |
| DFM-7 | 测试点全部放正面，直径 1.0 mm，中心距 ≥1.8 mm；清单见 TST-1 | 必须 | DRC | 经验 |
| DFM-8 | 丝印标出极性、1 脚、接口名称；丝印不压焊盘 | 建议 | DRC | 经验 |

---

## 11. 检查手段和证据

### 11.1 现状

| 手段 | 管哪些规则 | 现状 |
|---|---|---|
| KiCad 网络分类（线宽、间距、过孔） | GEN、PWR-9、PWR-10、PWR-18、USB-8、RF-9 | 四层版已有，改六层时更新 |
| KiCad 自定义规则 `.kicad_dru`（禁布区、差分对间距和长度差、层限制） | STK-1、STK-6、RF-2、RF-4、USB-2、USB-3、SIG-4 | **还没写** |
| 关键走线布完锁定 | 第 4 ~ 7 节的关键线 | 四层版已实现 |
| 检查脚本 | 所有标"脚本"的规则 | `../kicad/gen/check.py` 已覆盖电源铜皮、开关电源、地孔、天线线、USB 长度；信号类规则**还没写** |
| 人工评审清单 | 第 11.3 节列出的不可计算项 | 就是本文件 |
| 板厂阻抗报告 | RF-1、USB-1 | 下单时要求 |
| 实物验证 | 供电跌落、4G 发射功率和接收灵敏度、USB 能否稳定识别 | 打样后做 |

### 11.2 从"人工"改成"脚本"的 7 条

| 规则 | 量什么 | 通过判据 |
|---|---|---|
| STK-2 | L3 与 L4 线段的投影重叠长度、夹角 | 重叠 >5 mm 且夹角 <30° 即不通过 |
| PWR-7 | TVS 与接口的包围盒距离；从接口到负载的网络连通顺序 | TVS 到接口 >2 mm，或 TVS 不在必经路径上，不通过 |
| PWR-11 | 输入 / 输出电容的地焊盘与芯片地焊盘是否同层直接连通（连通性图，不经其他层） | 必须同层相连 |
| PWR-13 | 反馈走线到电感、开关节点铜皮的最小距离 | <1 mm 不通过 |
| RF-7 | 相邻线段的夹角 | 不在 [135°, 180°] 不通过 |
| RF-8 | 匹配元件到座子的距离；电容焊盘是否落在走线多边形内 | 距离 >2 mm 或不在线上，不通过 |
| GND-1 | 平面空隙的最大内切缝宽（从铜皮多边形算） | >3 mm 不通过 |

其余仍标"人工"的，只剩丝印可读性、器件极性 / 方向、电流走向是否符合直觉这三类。

### 11.3 人工评审清单（只剩不可计算的项）

- 每张丝印是否可读、是否压焊盘、极性和 1 脚是否清楚。
- 器件方向是否与 BOM 和封装一致。
- 电源电流走向是否与 PWR-16 的星形汇合点一致（看图判断，不量数字）。
- 天线和外壳的配合、天线净空（要天线厂参与）。
- DFM-3 的贴片可行性（要贴片厂参与）。

### 11.4 投板条件

- DRC 零错误、零未连接；
- 原理图一致性零差异；
- 检查脚本的表里"必须"项全部通过；
- "待确认"项全部有结论（每条在 13 节有默认值，不用等）；
- 人工评审签字；
- 每条规则对应的证据（DRC 报告 / 脚本输出 / 板厂阻抗报告文件名）在台账里可查。

---

## 12. 与四层版相比要先改的地方

| 规则 | 现状 | 要做的 |
|---|---|---|
| PWR-3 | C19 正极到供电脚 1.9 mm | 已做：1.76 mm，规则放宽到 1.8 mm（V0.3） |
| USB-6 | TP14 / TP15 是从线上引出的分支 | 改为线上或 ≤1.5 mm 分支 |
| USB-2 / USB-3 | 只有最长的一段并排走，长度差最大 2.2 mm | 四段全部按差分对重布 |
| RF-3 / RF-4 | 四层版没有做开窗 | 按 5.1 的新结构重布（只开天线座信号焊盘下） |
| DFM-5 | 没有定位点 | 加定位点或确定用工艺边 |
| PWR-14、DEC-3、GND-3、GND-4 | 没有专门检查过地孔数量 | 写进脚本后逐项核对 |
| STK-6 | 四层版 L4 有信号 | 先按纯 3.3 V 试布 |
| — | 还有 3 处元件间距冲突 | 布任何线之前先解决 |

再加一条：**换成六层之后，摆放要重新评审一次**，不能只改上面几处就开始布线——L5 的开窗位置、L4 的地岛、模组间距都会变。

---

## 13. 待确认的事项

| 事项 | 谁来定 | 默认值（拿不到就先用这个） |
|---|---|---|
| 13.1 嘉立创六层 1.6 mm 的阻抗叠层型号（外层是不是 7628、各层介质多厚） | 板厂 / 阻抗计算器 | 按外层 7628（0.21 mm）设计，线宽 0.34 mm |
| 50 Ω 和 90 Ω 的最终线宽线距 | 板厂计算器 | 50 Ω 0.34 mm；90 Ω 0.19 / 0.15 |
| 内层铜厚、0.2 mm 过孔是否加价 | 下单页 | 内层 0.5 oz；过孔 0.2 / 0.45 视为常规 |
| Air780E 的峰值电流 | 已有 | 2 A（合宙标称 1 A 的 2 倍） |
| 外置天线的型号和它要求的净空 | 天线厂 | 先按"离金属 10 mm、4G / Wi-Fi 天线间距 ≥30 mm"占位 |
| 投板前由谁做人工评审 | 你 | 必须有人签字，否则不投板 |

下单页要确认的就一件事：六层 / 1.6 mm / 1 oz 外层 / 0.5 oz 内层，叠层名是不是 `JLC06161H-7628`，外层预浸料是不是 0.2104 mm。
是，就删掉第 5 节的分支 B；不是、只有 0.1 mm 那档，退回全线挖空。

天线线交给板厂算的输入：线在 L6、参考层选 L5、类型共面单端（Coplanar Single Ended）、目标 50 Ω、导体到地间隙初值 0.2 mm。算出来填回 5.1 的表。

---

## 14. 新增规则（V0.2 加入，编号独立）

| 编号 | 规则 | 级别 | 检查 |
|---|---|---|---|
| RTN-1 | 回流路径：L3 参考 L2、L6 参考 L5、天线座开窗处参考 L4。任何开槽（RF-3 开窗、成排过孔的让位孔、螺丝孔、模组地焊盘开口）不得让某条线的参考面在其正下方断开超过一个线宽 | 必须 | 脚本 |
| THM-1 | 充电芯片、3.3 V 降压、背光升压、功放：按耗散功率给出最小散热铜面积（外层 1 oz，温升 20 °C），并写进 BOM 备注 | 必须 | 脚本 |
| AUD-2 | 写明功放是 D 类还是 AB 类、有没有输出滤波；D 类要额外评估载波（几百 kHz ~ 1 MHz）对麦克风的干扰 | 必须 | 人工 |
| TST-1 | 测试点清单：VBAT、VSYS、3.3 V、VDD_4G、BOOT、VDD_EXT、PWRKEY、GND 各至少一个，全部放正面（合宙建议） | 必须 | DRC |
| SSM-1 | 叠层关于中心对称（见 STK-7） | 必须 | 下单 |
| VIP-1 | 焊盘内打孔只允许：① 焊盘尺寸 ≥0.8 mm 的地焊盘或散热焊盘；② 孔径 0.2 mm；③ 下单时明确要求树脂塞孔 + 电镀盖帽。0.5 ~ 0.6 mm 的模组引脚焊盘上不打孔（0.2 / 0.45 的过孔会把焊盘吃掉，几乎没有锡量） | 必须 | 下单 + 脚本 |
| EVD-1 | 每条规则的检查结果要落到台账：规则编号、要求、实测、通过 / 不通过、证据文件名 | 必须 | 台账 |
