TENLEAP-AI/digital-human-koubo/hardware/esp32-s3-board/docs/air780e-design-notes.md

# 合宙 Air780E 设计笔记（与 ESP32-S3 配套）

读完合宙官方资料后整理的设计约束。第 1 ~ 8 节出自下面"资料来源"里的官方文档；
第 9 节"与 ESP32-S3 配套"是我根据两边资料推出来的设计建议，不是官方原文。

## 资料来源

| 文档 | 版本 | 链接 |
|---|---|---|
| Air780E 硬件手册 | V1.0（22 页） | https://docs.openluat.com/air780e/product/ |
| AT 使用方式参考设计原理图 | V20241025 | 同上页面"参考设计原理图" |
| 开机启动及外围电路 | 2025-08 | https://docs.openluat.com/air780e/at/hardware/design/poweron/ |
| 供电设计及选型 | 2026-09 | https://docs.openluat.com/air780e/at/hardware/design/power/ |
| 串口电路设计 | 2026-09 | https://docs.openluat.com/air780e/at/hardware/design/uart/ |
| SIM 卡电路设计 | 2026-09 | https://docs.openluat.com/air780e/at/hardware/design/sim/ |
| 天线电路设计 | 2026-10 | https://docs.openluat.com/air780e/at/hardware/design/ant/ |
| GPIO 注意事项、USB/SPI/I2C/ADC/LED（LuatOS 方式） | 2025-08 | https://docs.openluat.com/air780e/luatos/hardware/design/ |
| Cat.1 模组 AT 命令手册（只查了 PPP、串口、DTR 相关章节） | V1.6.8（274 页） | https://docs.openluat.com/air780e/at/app/at_command/ |
| 官方 PADS 封装包（含可读的 .asc 焊盘坐标） | V20241030 | 产品页"原理图及PCB封装" |

官方提示：硬件手册内容较老，与网页版"硬件指南"冲突时以网页版为准。

没读的：AT 指令手册的其余章节、LuatOS 版参考设计原理图细节、"开机 GPIO 电平变化"文章（在未放行的 doc.openluat.com 上）、
开发板 EVB_Air780X 原理图（附件站跳转到一个未放行的第三方域名，没有下载）。

## 1. 模组概况

- 4G Cat.1 bis，**单天线**。频段 FDD B1/B3/B5/B8，TDD B34/B38/B39/B40/B41，国内三大运营商全支持。
- 上行最大 5 Mbps，下行最大 10 Mbps；发射功率 23 dBm。
- **不支持语音通话（VoLTE）和 TTS**；短信不支持电信卡。
- LGA 封装，109 个焊盘，**15.8 × 17.7 × 2.3 mm**（以封装图为准；手册正文里另有"16×18"的写法）。
- 工作温度 -40 ~ +85 °C。
- 两种用法：**AT 指令**（外接主控，管脚功能固定）或 **LuatOS 二次开发**（模组自己当主控）。不支持 C-SDK。
- Flash 5 MB、RAM 2 MB（LuatOS 方式下）。

## 2. 供电（最容易出问题的部分）

- VBAT（42、43 脚）：**3.3 ~ 4.3 V，典型 3.8 V**。可直接接单节锂电池。
- **持续供电能力 > 1 A，瞬间 > 2 A**。射频发射瞬间有 1.5 ~ 2 A、百微秒级的脉冲电流；
  最大发射功率下平均电流 600 ~ 700 mA。
- VBAT 上的跌落和纹波要 **< 400 mV**，否则射频变差，严重时周期性重启（串口反复打印 `RDY`）。
- VBAT 引脚旁的电容（参考设计）：**220 µF 低 ESR 钽电容 + 0.1 µF + 33 pF + 10 pF**，再加一颗 TVS。
  官方保守推荐值是 1000 µF，空间允许就加大。
- 三种供电方案：
  - **DCDC**（参考设计用 JW5359M，输出 3.9 V）：输入电容 22 µF 紧贴芯片，电感 4.7 µH，
    反馈电阻上并前馈电容（1000 pF），输出 22 µF。电感饱和电流要大于"输出电流 × 1.5"。
  - **LDO**：只适合输入不超过 5 V；输出设到接近 4.2 V 以减小压差；
    封装必须带大散热焊盘（TO-252、TO-263、SOT-223），SO-8 这类小封装会过热。
  - **锂电池直供**：最理想；充电电流 500 mA 以下用线性充电（如 TP4056），1 A 以上用开关充电。
    TP4056 没有路径管理，电池不在时不能靠充电口直接给模组供电。
- VDD_EXT（24 脚）：IO 电源输出，最大 30 mA；**休眠时会断电并间歇性输出脉冲**，不能当稳定电源用。
- RefVolt（99 脚，AT 方式）：始终输出高电平，只能当上拉参考电源，最大 3 mA。

## 3. 开机、关机、下载

- **PWRKEY（7 脚）**：拉低超过 1 s（手册写 1.5 s）开机。模组内部已上拉并串了 5.6 kΩ，
  **外部禁止加任何上拉**。主控控制时用 NPN 三极管开集驱动，三极管靠近模组，基极串 4.7 kΩ。
- PWRKEY 直接接地可以实现"上电即开机"，但电池低电量时会反复开关机。
- **RESET_N（15 脚）**：拉低（建议 > 500 ms）是**硬关机，不是重启**，之后还要再操作 PWRKEY 才能开机。
  同样内部上拉、外部禁止上拉；也用 NPN 驱动，靠近模组留 10 nF / 100 pF 对地电容。
- **STATUS（25 脚）**：开机约 400 ms 后输出高电平，可接主控判断模组是否已开机。
- **USB_BOOT（82 脚）**：开机时被拉高（接 VDD_EXT）就进下载模式，此时不响应 AT 指令。平时悬空或拉低，留测试点。
- **USB（59 DP、60 DM、61 VBUS）**：用于升级固件和抓日志，留测试点；差分 90 Ω，TVS 寄生电容 < 1 pF。
- DBG_UART（38、39 脚）：固定 921600，只输出日志，留测试点，不要接外设。
- 参考设计里还有一路"主控切断模组电源"：主控 GPIO 经 NPN 拉低 DCDC 的 EN，可在模组死机时彻底断电重启。

## 4. IO 电平

- **IO_Volt_Set（100 脚）**：悬空 = 所有 IO 为 1.8 V（默认）；**接地 = 3.3 V**。
- 电平相差不超过 0.5 V 时可以直连，TX/RX 上各串 1 kΩ 限流电阻。
- 需要电平转换时：115200 以下可用 NPN 三极管方案，更高波特率用电平转换芯片（TXS0102 等）。
- 需要休眠的设计里，**上拉电源一律用 RefVolt / AGPIO，不要用 VDD_EXT**，否则模组无法休眠。

## 5. 串口（AT 方式）

| 管脚 | 名称 | 说明 |
|---|---|---|
| 17 | MAIN_RXD | 模组接收，接主控 TX |
| 18 | MAIN_TXD | 模组发送，接主控 RX |
| 19 | MAIN_DTR | 唤醒输入；内部上拉并串 5.6 kΩ，外部不要加上拉 |
| 20 | MAIN_RI | 收到短信或数据上报时输出 120 ms 低脉冲（数据上报需 `AT+CFGRI=1`） |
| 21 | MAIN_DCD | 目前无功能 |
| 22 | MAIN_CTS | 硬件流控，与主控 **直连不交叉**（CTS 接 CTS） |
| 23 | MAIN_RTS | 硬件流控，直连不交叉 |

- 默认 115200，自适应波特率，最高 921600。流控默认关闭（`AT+IFC` 打开）。
- 只有主串口能在休眠时唤醒模组；**从低功耗模式唤醒时要用 9600 波特率发 AT**，其它波特率会丢前几个字节。
- 不用的串口管脚悬空。

## 6. SIM 卡

- SIM1（11 DAT、12 RST、13 CLK、14 VDD）：自适应 1.8 V / 3.3 V 卡。只用一张卡时用 SIM1。
- SIM2（62 ~ 65 脚）：电平跟随 IO 电平设置，不自适应；常用于贴片卡。双卡单待。
- USIM_DET（79 脚）：只对 SIM1 有效，电平变化触发检测；用 100 kΩ 上拉到 RefVolt，**不要上拉到 VDD_EXT**。
- 外围：RST、CLK、DAT 各串 22 Ω；各并 33 pF 到地；VDD 上 0.1 µF + 33 pF；每根线一颗 TVS（寄生电容 ≤ 50 pF）。
- Layout：卡座尽量靠近模组，走线 < 20 cm；远离射频线和 VBAT；CLK 与 DAT 之间用地隔开，RST 也要包地；
  TVS 和外围元件靠近卡座。

## 7. 天线

- 天线脚 LTE_ANT（35 脚），工作频率 824 ~ 2655 MHz。Wi-Fi Scan 与 4G 共用这根天线。
- 走线全程 **50 Ω 阻抗控制**，尽量短，135° 拐角，参考地平面完整，沿线打地过孔，不与其它信号平行或交叉。
- 靠近天线端预留 **π 型匹配**：串联位先贴 0 Ω，两颗对地电容先不贴，等天线调试后再定值。
- 与天线脚相邻的地焊盘不要做花焊盘，要与地铜全连接。
- 官方给的共面波导线宽（线到两侧地铜间距 6 mil）：

| 板子 | 线宽 | 备注 |
|---|---|---|
| 2 层 1.0 mm | 21.77 mil | 参考地为底层 |
| 2 层 1.2 mm | 24.11 mil | |
| 2 层 1.6 mm | 25.42 mil | |
| 4 层 1.2 mm | 24.02 mil | 参考地为 L3，L2 在走线下方挖空 5 倍线宽 |
| 4 层 1.6 mm | 26.43 mil | 同上 |

- 内置天线的性能和外壳、周边器件强相关，官方建议设计之初就找天线厂评估。

## 8. 封装与生产

- 推荐焊盘见硬件手册第 20 页；官方 PADS 封装包里的 `Air780E_AT.asc` 有 109 个焊盘的精确坐标。
  KiCad 自带库里没有 Air780E，需要自己建封装。
- **模组与其它元件间距至少 3 mm**。
- 钢网厚度 0.2 mm；建议 PCB 第一面回流焊完成后再贴模组，避免模组二次受热。
- AT 方式下大量焊盘是"悬空不接"（见硬件手册第 14 页的清单），不能顺手接地。

## 9. 与 ESP32-S3 配套（我的设计建议）

- **已确认的方案**：ESP32-S3 跑应用（语音、AI、显示），Air780E 只负责 4G 联网；
  两者用 UART 连接，AT 指令控制，**PPP 拨号上网**。
- **PPP 可行**：硬件手册的 AT 功能表里 Air780E 一列 PPP 为"支持"；
  AT 手册 V1.6.8 给出的流程是 `ATD*99#` → `CONNECT`，`+++` 退回命令模式，`ATO` 回到数据模式。
- **AT 手册里没有 CMUX（串口多路复用）指令**，所以 PPP 在线时同一个串口不能同时发 AT。
  要查信号强度等信息，得先切回命令模式：`+++` 前后各要空 1 s / 0.5 s；
  或者设 `AT&D1` 后拉一下 DTR 立即切换。因此 **MAIN_DTR 建议接上**。
- **串口速率决定网速上限**：115200 时约 11 KB/s，够语音流，但传一张 100 KB 的照片要 9 秒左右；
  921600（模组支持的最高值）约 90 KB/s。要跑高波特率就**必须接硬件流控 RTS / CTS**，
  并且 TX/RX 上的串联电阻不能太大（官方提示会影响信号边沿）。
  波特率可以用 `AT+IPR=921600;&W` 固定保存，默认是自适应（开机后主控先发几个 `AT` 训练）。
- **不依赖模组的 IO 电平**（2026-11 更新）：连接方式已改为 USB，并且要兼容只有 1.8 V 电平的北美版 Air780EEN，
  所以模组一侧的所有信号都按"与电平无关"来设计，100 脚不接。详见第 10 节。
  （早先的做法是把 100 脚接地、统一到 3.3 V 后串口直连，这个做法已不再采用。）
- **两路电源分开**：Air780E 的 VBAT 要 3.8 V 左右、能扛 2 A 脉冲；ESP32-S3 要 3.3 V、500 mA 以上。
  不能让 Air780E 挂在 ESP32 的 3.3 V LDO 上：3.3 V 是它供电范围的下限，发射脉冲一来就会把 ESP32 一起拉复位。
  建议"输入 → DCDC 出 3.8 ~ 4.0 V 给 Air780E"，"3.3 V 另用一颗 LDO 或 DCDC 给 ESP32"。
- **只靠 USB 5 V / 500 mA 供电有风险**：两个模组同时发射时峰值电流超过普通 USB 口的能力，
  需要大储能电容，或者改用电池 / 5 V 2 A 适配器。这一点要先定下来。
- **ESP32-S3 侧建议连接的信号**：

| ESP32-S3 | Air780E | 说明 | 能否挂 IO 扩展芯片 |
|---|---|---|---|
| UART TX | MAIN_RXD (17) | 串电阻 | 不能 |
| UART RX | MAIN_TXD (18) | 串电阻 | 不能 |
| UART RTS（输出） | MAIN_RTS (23) | 硬件流控，直连不交叉 | 不能 |
| UART CTS（输入） | MAIN_CTS (22) | 硬件流控，直连不交叉 | 不能 |
| 输出 | MAIN_DTR (19) | PPP 在线时切回命令模式；也用于唤醒模组。用二极管隔离 | 可以 |
| 输出 → NPN | PWRKEY (7) | 开机，拉低 > 1 s | 可以 |
| 输出 → NPN | RESET_N (15) | 硬关机 | 可以 |
| 输入 | STATUS (25) | 判断是否已开机 | 可以 |
| 输入（可选） | MAIN_RI (20) | 有数据或短信时唤醒主控 | 要唤醒主控就不能 |
| 输出（可选） | 模组电源 EN | 彻底断电重启 | 可以 |

  这样 Air780E 只占 ESP32-S3 的 4 根原生 GPIO，其余慢信号都可以放到 I²C 扩展芯片上。

  UART 用 ESP32-S3 的 UART1 或 UART2（可映射到任意空闲 GPIO）；避开 GPIO0、3、45、46 这四个启动配置脚，
  也不要占用 GPIO43/44（下载口）和 GPIO19/20（USB）。控制 PWRKEY、RESET_N 的 GPIO 要选上电不会误动作的脚，
  或者靠 NPN 基极的下拉电阻保证默认不导通。
- **Air780E 断电而 ESP32 仍在运行时**，ESP32 的 TX 高电平会经模组 IO 倒灌；串联电阻能限流，
  固件里也应在模组断电期间把 TX 设为低电平或高阻。
- **两根天线要拉开**：4G 的 B40（2300 ~ 2400 MHz）和 B41（2496 ~ 2690 MHz）紧挨着 2.4 GHz 的 Wi-Fi / 蓝牙。
  ESP32-S3 模组的天线和 4G 天线尽量放在板子的两端或两个角，DCDC 远离两根天线。
  （相邻频段互扰是通用射频经验，不是出自上面的文档。）
- **板上要留的测试点**：Air780E 的 USB（VBUS、DP、DM、GND）、USB_BOOT + VDD_EXT、DBG_TXD/RXD、PWRKEY、VBAT。

## 10. 改用 USB 连接，并兼容北美版 Air780EEN

**已确认的决定**：Air780E 与 ESP32-S3 之间走 USB（ESP32-S3 做 USB 主机），不走串口；板子要能换贴北美版 Air780EEN。

### Air780EEN 与 Air780E 的对比（来自合宙官方资料）

| | Air780E | Air780EEN |
|---|---|---|
| 销售区域 | 中国 | 北美 |
| 频段 | FDD B1/B3/B5/B8，TDD B34/B38/B39/B40/B41 | FDD B2/B4/B5/B12/B13/B66/B71 |
| 封装 | 17.7 × 15.8 mm，109 个焊盘 | **完全相同**（见下） |
| 高度 | 2.3 mm | 2.1 mm |
| IO 电平 | 1.8 V，可设为 3.3 V（100 脚接地） | **只能 1.8 V**，100 脚要悬空 |
| 开发方式 | AT 指令或 LuatOS | 只有 AT 指令 |
| PPP、USB 上网（RNDIS / ECM） | 支持 | 支持（合宙 AT 功能表） |
| 乐鑫 USB 4G 组件的已测列表 | 在列 | 不在列，需要拿样品实测 |
| 供电 | 3.3 ~ 4.3 V | 相同 |
| SIM1 | 自适应 1.8 V / 3.3 V 卡 | 相同 |

封装一致性是我自己核对的：把两个型号官方 PADS 封装包里的焊盘定义逐项比对，109 个焊盘的坐标和焊盘形状完全一致。
AT 方式下的引脚名称 55 个相同，唯一不同的是 100 脚。

### 兼容两个型号的设计规则

Air780EEN 的 IO 只有 1.8 V，而 ESP32-S3 和 IO 扩展芯片是 3.3 V。所以模组一侧的信号一律做成与电平无关：

| 信号 | 做法 |
|---|---|
| 数据通道 | USB（D+ / D−），与 IO 电平无关 |
| PWRKEY、RESET_N | NPN 三极管开集驱动（参考设计原本就是这样） |
| STATUS | 经一颗 NPN 三极管转成 3.3 V 电平再给扩展芯片；也可以不接，改用"USB 是否枚举成功"判断模组是否开机 |
| NET_STATUS 指示灯 | NPN 三极管驱动 |
| 100 脚 | 不接。留一个不贴的 0 Ω 位到地，只在确定只用 Air780E 且需要 3.3 V IO 时才贴 |
| 主串口、调试串口 | 只引到测试点，不连 ESP32-S3（Air780EEN 上是 1.8 V 电平） |
| USB_BOOT | 测试点，上拉到模组自己的 VDD_EXT |
| VBUS（61 脚） | 合宙说明它只用于 USB 插入唤醒，不是必须；预留一个接法，样品实测后再定 |

这样两个型号用同一块板、同一份其它物料，只换模组本身。

### 换型号时要跟着变的

- **4G 天线。** 北美频段低到 617 MHz（B71），中国版最低 824 MHz。频率越低天线要越长，
  小机身里做好低频段很难。板上的 50 Ω 走线、IPEX 座和 π 型匹配位是通用的，但天线本体和匹配元件值要按区域分别调。
- **固件里的 APN、运营商配置。**

### 出货北美前必须另外确认的

- **运营商认证。** 合宙 Air780EEN 产品页列出的证书只有 FCC 和 CE，没有列 PTCRB 或 AT&T、Verizon、T-Mobile 的认证。
  美国运营商通常要求模组或整机通过其认证，这一点要直接问合宙。
- **整机认证**（FCC 等）是整机厂的事，与用哪颗模组无关，周期要留出来。
- **USB 拨号实测。** 乐鑫的已测列表里只有 Air780E。
