TENLEAP-AI/digital-human-koubo/hardware/esp32-s3-board/docs/nv3049f-research.md

# NV3049F 公开资料调研

屏 LB28BOE47 用的驱动芯片 NV3049F 没有公开的数据手册。这里汇总从公开渠道能确认的信息、
对设计的影响，以及仍然必须向屏厂确认的问题。

## 资料来源

| 来源 | 内容 | 可信度 |
|---|---|---|
| 全志 V821 官方文档《Serial RGB 点亮 854x480 屏》<br>https://docs.aw-ol.com/docs/soc/v821/disp/disp2/disp_driver_lcd_serial_rgb/ | 用 NV3049F + BOE 4.5 寸屏点亮串行 RGB 的教程 | 高（芯片原厂文档；我只读到搜索摘要，原文站点未放行） |
| 全志 V821 物料支持列表<br>https://docs.aw-ol.com/docs/soc/v821/hardware/support_list/ | NV3049F_BOE4.5 的接口和驱动方式 | 高（同上） |
| 全志 Tina SDK 里的 `nv3049f.c` 驱动<br>https://github.com/sam-yangjj/tina-v821-v1.3-bsp （`drivers/video/sunxi/disp2/disp/lcd/nv3049f.c`） | 完整的初始化序列和三线 SPI 写法 | 高（已读原文） |
| V821 AI 眼镜板级配置<br>https://github.com/Nopiskl/V821_AIGlassess （`quick_config.json`） | NV3049F 串行 RGB 的时序参数 | 高（已读原文） |
| 联发科平台 `nv3049f_28` 驱动<br>https://github.com/maozi-114/android_kernel_mt6735-37_3.18.79 | 一块 **2.8 寸 480 × 640** 的 NV3049F 屏，MIPI 接口，含 182 条初始化参数 | 中（作者说明是从内核二进制里还原的） |
| 数码之家帖子《用 ESP32S3 成功驱动 8bitRGB 屏》<br>https://www.mydigit.cn/thread-374960-1-1.html | ESP32-S3 驱动 8 位串行 RGB 屏的实测 | 中（个人实测，三年多前；只读到搜索摘要） |
| 芯片目录站的 NV3049 条目（搜索摘要） | 最大分辨率、有无显存、接口 | 低（二手信息） |

上面的驱动代码是别人的版权作品（全志的是 GPL），没有复制进本仓库，需要时按链接去读。

## 已确认的事实

**芯片本身**

- NV3049F 是上海新相微的 TFT 驱动芯片，最大分辨率 480 × 864，**没有内置显存**。
- 支持的接口：RGB（并行、8 位串行）+ 三线 SPI 配置，另外还支持 **MIPI DSI（2 条数据通道）**。
- 面板色深是 **RGB666**（每种颜色 6 位，26 万色）。全志物料列表写的是"480 × RGB666 × 854，Serial RGB 8BIT"。

**8 位串行 RGB 模式**

- 之前的推断得到证实：**每个像素用 3 个时钟**，依次送三个颜色字节。
  全志配置里行总长是 1479 个时钟 = 493 个像素周期 × 3。
- 三个颜色字节的先后顺序可以配置（全志的例子是"绿-蓝-红"），不一定是红绿蓝。
- 全志平台用的是 **DE 模式**（物料列表写"DE + TCON"）。
- 消隐区很短：行消隐只有 13 个像素周期，场消隐 16 行。

**实际产品里的时序**

| 产品 | 屏 | 接口 | 像素时钟 | 刷新率 |
|---|---|---|---|---|
| 全志 V821 AI 眼镜 | 480 × 854 | 8 位串行 RGB | 71 ~ 77 MHz | 约 55 ~ 60 帧 / 秒 |
| 联发科手机方案 | 2.8 寸 480 × 640 | MIPI 2 通道 | — | 行：同步 4、后沿 44、前沿 46；场：同步 4、后沿 14、前沿 16 |

**初始化方式**

- 三线 9 位 SPI：先送 1 位"命令 / 数据"标志，再送 8 位数据，高位在前；时钟空闲为低，上升沿采样。
  全志驱动是用 GPIO 模拟的，所以挂在 IO 扩展芯片上发是可行的。
- 寄存器分页：写 `0xFF` 三次（0x30、0x49、页号）切换页。
- 串行模式和并行模式的前后沿寄存器是分开的：串行用 0x12、0x15、0x17、0x1A，并行用 0x11、0x14、0x16、0x19。
- 结尾是退出休眠（0x11）和开显示（0x29），各延时 200 ms。
- 公开的完整初始化序列有两份：4.5 寸屏的串行 RGB 版（全志），2.8 寸 480 × 640 屏的 MIPI 版（联发科）。
  伽马和栅极时序参数跟具体玻璃有关，**不能直接照搬**，但可以作为点屏的起点和对照。

**ESP32-S3 驱动 8 位串行 RGB 屏的实测（数码之家）**

- 用 ESP-IDF 的 RGB 屏驱动，数据宽度 8、每像素 24 位，能正常显示。
- **像素时钟设 20 MHz 正常，设高了画面横向漂移。**
- 必须用八线、80 MHz 的 PSRAM。
- 这是三年多前的测试，当时 ESP-IDF 还没有 Bounce Buffer 模式，现在的上限可能更高，但没有数据。

## 对我们这块屏（480 × 640）的推算

每帧时钟数 ≈ 1479 × (640 + 16) ≈ 97 万个。

| 像素时钟 | 刷新率 | 说明 |
|---|---|---|
| 20 MHz | 约 20.6 帧 / 秒 | ESP32-S3 实测可用的水平 |
| 29 MHz | 约 30 帧 / 秒 | 需要 Bounce Buffer 等优化，未经证实 |
| 58 MHz | 约 60 帧 / 秒 | 其它平台上产品的常规水平，ESP32-S3 基本做不到 |

结论：**ESP32-S3 大概只能把这块屏刷到 20 ~ 30 帧 / 秒，而它在别的产品里是按 55 ~ 60 帧 / 秒用的。**
这块屏在 20 ~ 30 帧 / 秒下会不会闪，公开资料里没有答案，是目前最大的不确定点。

## 对设计的影响

- **数据线接 6 位就不损失颜色**（面板本身只有 RGB666）。接 5 位是 32768 色，接 6 位是 26 万色。
  具体是 8 根线里的哪 6 根有效，需要屏厂确认。
- 屏的初始化挂扩展芯片可行。
- **退路**：NV3049F 支持 MIPI。如果 ESP32-S3 刷不到这块屏要求的最低刷新率，
  可以问屏厂要同一块玻璃的 MIPI 排线版本，配带 MIPI 的主控（ESP32-P4）。

## 仍然要问屏厂的问题

1. LB28BOE47 在串行 RGB 模式下，**刷新率和 DOTCLK 的最小值、典型值、最大值**。能不能在 20 ~ 30 帧 / 秒下正常显示？
2. LB28BOE47 的**完整初始化代码**（串行 RGB 版）。
3. 8 根数据线 G0 ~ G7 里，**哪 6 根对应 RGB666**；三个颜色字节的发送顺序。
4. 用 DE 模式时，**HSYNC 和 VSYNC 能不能不接**？
5. 这块屏有没有 **MIPI 接口的版本**？
6. 背光的电压和电流、FPC 间距、触摸屏的排线定义和芯片型号。
