TENLEAP-AI/digital-human-koubo/hardware/esp32-s3-board/docs/esp32-s3-design-notes.md

# ESP32-S3 主板设计笔记（原理图 + Layout 依据）

读完乐鑫官方资料后整理的设计约束，后续画原理图和 PCB 时逐条对照。
凡是没有标注"通用经验"的条目，都出自下面"资料来源"里的官方文档。

## 资料来源

| 文档 | 版本 | 链接 |
|---|---|---|
| ESP32-S3 Hardware Design Guidelines | master（修订记录到 v1.8, 2025-07） | https://docs.espressif.com/projects/esp-hardware-design-guidelines/en/latest/esp32s3/index.html |
| ESP32-S3 Series Datasheet | v2.2 | https://www.espressif.com/sites/default/files/documentation/esp32-s3_datasheet_en.pdf |
| ESP32-S3-WROOM-1 / 1U Datasheet | v1.8 | https://www.espressif.com/sites/default/files/documentation/esp32-s3-wroom-1_wroom-1u_datasheet_en.pdf |
| ESP32-S3-DevKitC-1 原理图 | V1.1 (2022-11-30) | https://dl.espressif.com/dl/schematics/SCH_ESP32-S3-DevKitC-1_V1.1_20221130.pdf |
| ESP32-S3-DevKitC-1 PCB 图 | V1.1 | https://dl.espressif.com/dl/schematics/PCB_ESP32-S3-DevKitC-1_V1.1_20220429.pdf |

还没读的：ESP32-S3-MINI-1 手册（已下载未细读）、Technical Reference Manual、芯片勘误表，以及乐鑫以外其它芯片的数据手册。

## 1. 选型

- **芯片**：QFN56（7×7 mm），57 号脚是底部 GND 焊盘。只支持 40 MHz 晶振。
- **芯片型号后缀**：F=合封 Flash，R=合封 PSRAM，V=只支持 1.8 V 外部 Flash。
  例：ESP32-S3FN8（8 MB Flash）、ESP32-S3R8（8 MB 八线 PSRAM）、ESP32-S3FH4R2。
- **模组 ESP32-S3-WROOM-1**（PCB 天线，18 × 25.5 × 3.1 mm）/ **-1U**（IPEX 座，18 × 19.2 × 3.2 mm），41 个焊盘。
  - 常用：N8、N16（无 PSRAM）；N8R2、N16R2（2 MB 四线 PSRAM）；N8R8、N16R8（8 MB 八线 PSRAM）。
  - 带八线 PSRAM 的型号（R8、R16V）：**IO35、IO36、IO37 被 PSRAM 占用，不能用**；环境温度上限 65 °C。
  - N16R16V：VDD_SPI 是 1.8 V，**IO47、IO48 也工作在 1.8 V**。

## 2. 电源

- 单电源 3.3 V（允许 3.0 ~ 3.6 V，绝对最大 3.6 V），**供电能力不小于 500 mA**。
  Wi-Fi 发射峰值电流 355 mA（802.11b, 20.5 dBm），接收约 95 mA。
- 电源入口：ESD 保护管 + 至少 10 µF。
- 模组方案：3V3 脚旁放 22 µF + 0.1 µF（模组手册外围电路）；DevKitC-1 用的是 10 µF + 0.1 µF。
- 芯片方案（自己画最小系统时）：
  - VDD3P3（2、3 脚，射频相关）：10 µF + LC 滤波（参考图 L=2.0 nH，额定电流 ≥500 mA），再加 1 µF / 0.1 µF。
  - VDD3P3_CPU（46 脚）、VDD3P3_RTC（20 脚）：各 0.1 µF，贴近引脚。
  - VDDA（55、56 脚）：参考图为 1 µF + 10 nF。
  - VDD_SPI（29 脚）：0.1 µF + 1 µF，不要加太大的电容。3.3 V 时经内部 14 Ω 电阻从 VDD3P3_RTC 取电，1.8 V 时内部 LDO 最多 40 mA。
- VDD3P3_RTC 不能单独供电，所有电源必须同时上电。

## 3. 上电与复位（EN / CHIP_PU）

- EN 不能悬空。电源稳定后至少 50 µs 再拉高 EN；复位时 EN 低于 0.25 × VDD 至少 50 µs。
- **EN 加 RC 延时：R = 10 kΩ 上拉，C = 1 µF 到地**。
- 电源上升慢、频繁上下电或电源不稳（如电池充电场景）时，RC 不够，要预留电压监控复位芯片，阈值约 3.0 V。
- EN 走线尽量短。

## 4. Strapping 引脚（上电时被采样，之后可当普通 IO）

| 引脚 | 默认 | 作用 | 设计要求 |
|---|---|---|---|
| GPIO0 | 内部弱上拉 = 1 | 启动模式：1 = 正常从 Flash 启动；0（且 GPIO46=0）= 下载模式 | 建议外加上拉；接 BOOT 按键到地；**不要挂大电容**，否则可能误进下载模式 |
| GPIO46 | 内部弱下拉 = 0 | 与 GPIO0 一起决定下载模式；也控制 ROM 打印 | 上电时不要被外部电路拉高 |
| GPIO45 | 内部弱下拉 = 0 | VDD_SPI 电压：0 = 3.3 V，1 = 1.8 V | 上电时不要被外部电路拉高（否则 3.3 V Flash 会掉电压） |
| GPIO3 | 悬空 | JTAG 信号来源选择（只在烧了对应 eFuse 后生效） | 默认可忽略 |

Strapping 引脚的保持时间：EN 拉高后至少 3 ms。

## 5. GPIO 使用限制

- **可以放心用**：GPIO1、2、4 ~ 18、21、38、47、48（注意上面 R8 / R16V 型号的例外）。
- **要小心**：
  - GPIO0、3、45、46：strapping 引脚。
  - GPIO19（USB D-）、GPIO20（USB D+）：默认是 USB Serial/JTAG。
  - GPIO39 ~ 42：JTAG（MTCK、MTDO、MTDI、MTMS）。
  - GPIO43（U0TXD）、GPIO44（U0RXD）：UART0，下载和日志口。
  - GPIO33 ~ 37：八线 Flash/PSRAM 时被占用。
- **不要用**：GPIO26 ~ 32（SPI Flash/PSRAM 专用，模组上没有引出）。
- **上电毛刺**：GPIO1 ~ 14、17、18 上电时有约 60 µs 的低电平毛刺；GPIO18、19、20 还有高电平毛刺。
  功放使能、继电器、背光这类"不能误触发"的信号要避开，或者加外部上/下拉。
- 只有 VDD3P3_RTC 电源域的引脚（GPIO0 ~ 21）能在 Deep-sleep 模式下被控制。
- ADC：ADC1 = GPIO1 ~ 10，ADC2 = GPIO11 ~ 20；官方建议用 ADC1，引脚旁加 0.1 µF 滤波。
- 触摸：GPIO1 ~ 14；串 470 Ω ~ 2 kΩ（推荐 510 Ω）。
- 32.768 kHz 晶振（可选）：GPIO15 / GPIO16，ESR ≤ 70 kΩ。
- 默认驱动能力：GPIO17/18 为 10 mA，GPIO19/20 为 40 mA，其余 20 mA。
- I2S、I2C、LCD、摄像头、SD/MMC、UART1/2、SPI3、PWM、RMT 都没有固定引脚，能通过 GPIO 矩阵映射到任意空闲 GPIO。
  SPI2 的专用脚（FSPI，速度最高）在 GPIO9 ~ 14。

## 6. 下载与调试

- **USB 直连（推荐）**：GPIO19 = D-，GPIO20 = D+，芯片内置 USB Serial/JTAG，可以直接下载、打日志、JTAG 调试，不需要 USB 转串口芯片。
  - D+/D- 上预留串联电阻（初值 0 / 22 / 33 Ω）和对地电容位（先不贴），贴近芯片。
  - 如果应用把 USB 口另作它用（USB Host、自定义 USB 设备等），自动下载会失效，必须靠 GPIO0 进下载模式，所以 **BOOT 按键一定要留**。
- **UART0**：GPIO43 = TX，GPIO44 = RX。TX 上串 499 Ω 抑制谐波。
  官方建议保留 UART 下载口，因为射频测试固件只支持 UART。
- DevKitC-1 的做法：CP2102N（USB 转串口）+ 两个 NPN 三极管（各串 10 kΩ 基极电阻）组成自动下载电路，
  DTR / RTS 控制 EN 和 GPIO0；BOOT 键接 GPIO0，RESET 键接 EN；两个 USB 口的 VBUS 各经一个肖特基二极管（1N5819）汇到 5 V；
  每根 USB 线（VBUS、D+、D-）各一个 ESD 管；LDO 为 SGM2212-3.3，输入输出各 10 µF + 0.1 µF；
  RGB 灯（SK68xx）接 GPIO38；电源指示灯串 5.1 kΩ。

## 7. Layout 规则

### 7.1 模组在底板上的摆放（最重要）

- PCB 天线**伸出板边**最好；做不到就让天线端贴着板边，**馈点一侧靠近板角**。
  官方图示：馈点在右侧的模组，放板子右上角（天线朝上）或右下角（天线朝右）；馈点在左侧的则镜像。
  从外形图看 WROOM-1 的馈点在天线区右侧，这一点是我看图判断的，定稿前要对照模组实物或封装再核对一次。
- 天线区（模组顶部 6 mm 高、18 mm 宽）下方及两侧**所有层净空**：不铺铜、不走线、不放元件；天线旁边至少留出 15 mm 的净空。
- 不要把模组放在板子中间靠四周挖空来凑净空。
- 整机里天线四周至少留 15 mm 空间，远离金属和电池。
- 天线附近的底板要有充足的地铜和密集地过孔。
- USB 口、USB 转串口芯片、UART 走线和排针尽量远离天线。

### 7.2 WROOM-1 推荐焊盘

- 外形 18 × 25.5 mm；焊盘 0.9 × 1.5 mm，间距 1.27 mm；左右各 14 个，底边 12 个。
- 左右两列焊盘中心距 17.5 mm；1 号焊盘中心距模组顶边 7.49 mm；左右两列各跨 16.51 mm。
- 底部 EPAD（41 号，GND）：3.7 × 3.7 mm 区域内 9 个 0.9 mm 方块，间隔 0.5 mm，间隙里打散热地过孔。
  EPAD 可以不焊，焊了散热更好；锡膏不能多，否则会把模组垫高。

### 7.3 叠层与电源

- **推荐四层**：L1 信号和元件 / L2 完整 GND / L3 电源和少量信号 / L4 少量信号，底层尽量不放元件。
- 两层也可以：元件和走线尽量都在顶层，底层保持完整地平面。
- 3.3 V 主电源线宽 ≥ 25 mil（0.635 mm）；其它电源线 10 mil；换层至少两个过孔。
- 去耦电容紧贴电源脚，电容的地焊盘旁边就近打地过孔。
- 元件和芯片的地焊盘要和地铜整片连接，不要用细线引出去。

### 7.4 USB

- 差分走线，等长并行，**差分阻抗 90 Ω ±10%**；下方参考地平面连续，两侧包地。
- 尽量不换层；必须换层时在换层处加一对回流地过孔。

### 7.5 其它接口

- UART：TX 串联电阻靠近芯片，走线包地。
- SPI：CLK 上串电阻（或磁珠）并预留对地电容，靠近芯片/模组引脚放置。
- SDIO：加上拉；CMD 和 DATA 与 CLK 的长度差在 ±50 mil 内；单端 50 Ω；总长最好不超过 2000 mil；不换层。
- 触摸：线宽 ≤ 0.18 mm，线长 ≤ 300 mm，电极直径 8 ~ 15 mm，周围铺网格地，远离天线。

### 7.6 只有"直接用芯片"才需要的规则

- 射频走线 50 Ω 阻抗，走表层、不打孔、不分叉，拐弯用 135° 或圆弧，两侧密集地过孔。
  参考叠层：L1 到 L2 介质厚 8.22 mil（7628 半固化片）时，线宽 12.6 mil、两侧间隙 12.2 mil。
- 芯片端 CLC 匹配用 0201，靠近 LNA_IN 之字形摆放；初值 C 1.2 ~ 1.8 pF、L 2.0 ~ 3.0 nH，必须用网分实测调。
  靠近芯片的第一颗对地电容的地焊盘上加 15 mil 长的短截线（抑制二次谐波）。
- 天线端再放一组 CLC 匹配；IPEX 座下方所有层净空。
- 晶振：40 MHz ±10 ppm；XTAL_P 上串 24 nH（初值）；晶振离芯片时钟脚至少 2 mm；
  时钟线不打孔、下方不走线、两侧包地；周围不放电感等磁性元件。
- 芯片底部 GND 焊盘至少 9 个地过孔。
- Flash 的 SPI 线上串 0 Ω 电阻位，靠近芯片；八线 SPI 要等长。

## 8. 待确认

- 板上除 ESP32-S3 以外还有哪些芯片（音频编解码、功放、麦克风、充电管理、屏幕驱动等），需要对应的数据手册。
- USB-C 的 CC1 / CC2 各接 5.1 kΩ 到地是 USB-C 规范的通用做法（通用经验，不是出自上面的乐鑫文档）；
  LDO、ESD 器件的具体型号定下来后要读各自的数据手册。
