TENLEAP-AI/digital-human-koubo/hardware/esp32-s3-board/kicad/reports/routing-closure.md

# 布线收尾记录

日期：2026-11-11。检查工具：**KiCad 9.0.9**（`kicad-cli pcb drc --schematic-parity --severity-all`）。
完整报告：[`drc-report.txt`](drc-report.txt)、[`drc-report.json`](drc-report.json)。

## 1. 三项计数

| | 基线 `7ab37c0` | 本次结果 |
|---|---|---|
| 未连通 | 12 | **0** |
| 布线违规（间距、短路、孔距、板边、线宽等） | 0 | **0** |
| 原理图一致性，含字段差异（KiCad 9.0.9） | 0 | **0** |

基线的未连通 12、布线违规 0 由两边独立确认。字段差异警告两边不一致：这边 KiCad 9.0.9 是 0 条，
独立复查用 KiCad 10.0.8 是 199 条。本次结果只在 KiCad 9.0.9 上跑过；10.0.8 上的字段警告数需要另行复查，
这里不替它下结论。工程设置里已把"封装与库比对"两项设为忽略（封装由脚本写进板子，不依赖各人电脑上的库）。

## 2. 选版：两版断点逐条对比

基线 `7ab37c0` 在三个信号层上局部收尾做不到：`EXP_INT` 的 U8.22 端光靠锁定的底子就被围死
（见 3.1），必须动摆位。所以采用了改摆位后重新布线的一版。

| # | 网络 | 基线里断开的一端 | 新版 |
|---|---|---|---|
| 1 | CAMF_PWDN | U7.7 | 已接通 |
| 2 | CAMR_VSYNC | J10.7 | 已接通 |
| 3 | EXP_INT | U7.22 → ESP32 中断网络 | 已接通（底子里直连，见 3.2） |
| 4 | EXP_INT | U8.22 | 已接通 |
| 5 | KEY1 | U7.1 | 已接通 |
| 6 | KEY2 | U7.2 | 已接通 |
| 7 | KEY5 | J5.3 | 已接通 |
| 8 | KEY5 | R24.1 | 已接通 |
| 9 | LCD_CS | J8.15 | 已接通 |
| 10 | LCD_G6 | J8.8 | 已接通 |
| 11 | LCD_HSYNC | J8.17 | 已接通 |
| 12 | USB_SEL | U8.16 | 已接通 |
| 新增 | I2C_SCL | 充电芯片 U2.5（7.15, 14.12，背面） | Freerouting 和 `finish.py` 之后唯一剩下的一处；手工接通（见 4） |

屏、摄像头、USB_SEL 没有新增断点。新增的只有 I2C_SCL 这一处，在充电芯片上。

## 3. 改动范围

首版配置不变：屏用 G3 ~ G7 五根数据线，G0 ~ G2 经 R55 ~ R57 接地，保留 TF 卡，R58 ~ R60 维持删除。
原理图相对 `7ab37c0` 没有改动。

### 3.1 摆位（`gen/place.py`）

| 器件 | 改动 | 原因 |
|---|---|---|
| U8（扩展芯片 B）和它的去耦电容 C17 | 下移 0.8 mm（y 20.0 → 20.8） | 原位置 U8 上排引脚的正上方是 Air780E 背面的一排焊盘，只有一个位置能打过孔，两个 3.3 V 脚（21、23）只好共用它，连线从中断脚（22）头顶横过去，下面是散热焊盘，中断脚四面都是锁定的铜。下移后上排引脚对着模组两排焊盘之间的空隙，各自能在正上方打孔 |
| U6、C15、R17 | 位置不变（原来和 U8 同组，现在单列一组） | — |
| U7（扩展芯片 A） | 原地转 180° | 6 个按键脚原来在左侧，上拉电阻和按键排线座在右下，6 根线都要绕芯片；转过来后按键脚朝右，前摄的两个控制脚朝上对着前摄排线座 |

下移 U8 后底子是重新生成的（地孔、3.3 V 孔、天线两侧的地孔跟着重排），不是在原板上平移一个器件。
生成后的检查：间距、短路 0 条；U8 第 21 脚没有压到任何过孔。

### 3.2 写进底子的手工线（`gen/power.py`，锁定）

| 网络 | 位置 | 内容 |
|---|---|---|
| GND | U8 第 18 脚（地址脚） | 正面 0.25 mm 线从焊盘 (26.51, 22.23) 接进散热焊盘 (24.8, 23.4)。自动生成的地线会绕过第 17 脚的端头去找过孔，把第 17 脚围住 |
| EXP_INT | U7 第 22 脚 → ESP32 第 9 脚 | 正面 (58.22, 12.41) → (58.22, 13.3)，过孔 (58.22, 13.3)，背面 → (58.22, 12.6) → (58.95, 12.2)。两个脚相距 0.4 mm，在相邻电源脚的短线之前先连上 |
| +3V3、SD_CLK_R | TF 卡座 J13 第 4、5 脚（`7e72e80` 起就有） | 两个脚各自直着向上，进麦克风两排焊盘之间的空隙打孔 |

### 3.3 手工收尾（`gen/hand.py`）

只动了充电芯片下方三条信号线，各几毫米；锁定的铜一段没动（底子 860 项，布线前后逐项比对一致）。

| 网络 | 拆掉 | 新画 |
|---|---|---|
| I2C_SCL | — | 背面 (7.15, 14.12) → (7.15, 14.45) → (7.07, 14.69)，过孔 (7.07, 14.69)；之后由程序从这个过孔接到 I²C 时钟线 |
| I2C_SDA | 第 6 脚到旧过孔 (7.12, 14.74) 的背面线、旧过孔、第 3 层第一段 | 背面 (6.65, 14.12) → (6.65, 14.9) → (6.85, 15.24) → (7.0, 15.24)，过孔 (7.0, 15.24)，第 3 层 → (5.42, 13.66) → (5.42, 13.04) |
| CHG_INT | 第 7 脚到旧过孔 (6.96, 15.34) 的背面线、旧过孔、第 3 层的一小段 | 背面 (5.97, 13.45) → (5.97, 14.9) → (6.7, 15.69) → (6.8, 15.79) → (7.0, 15.79)，过孔 (7.0, 15.79)，第 3 层 → (6.43, 15.79) → (5.98, 15.34) |

### 3.4 加宽过窄的线（`gen/widen.py`）

Freerouting 在引脚附近会把线收窄到引脚宽度。10 小段加宽（超过 3 mm 的窄线段加到 0.15 mm，0.09 mm 的加到 0.11 mm），
其中 2 小段加宽后间距不够，恢复原宽度。

## 4. 最后一处断点（I2C_SCL，U2.5）是怎么接通的

- 两端：充电芯片第 5 脚 (7.15, 14.12)，背面；I²C 时钟线最近的接入点在左上方约 9 mm。
- 挡路的：芯片下方能打过孔的只有一条 0.24 mm 宽的竖带（x = 6.93 ~ 7.17）。左边是正面 2 mm 宽的 VSYS 主干
  （x = 4.6 ~ 6.6），右边是背面 1.0 mm 的 VBUS 线（左沿 x = 7.5，从 y = 15.1 往下），下面是 R3 的焊盘（上沿 y = 16.12）。
  四个网络要在这里换层（CHG_INT、I2C_SDA、I2C_SCL、CHG_STAT）。自动布线放了三个过孔：
  CHG_INT (6.96, 15.34)、I2C_SDA (7.12, 14.74)、CHG_STAT (7.67, 14.73)；I2C_SDA 的过孔正好在第 5 脚正下方。
- 处理：竖带里三个过孔上下排成一列，中心距取规则允许的最小值，CHG_STAT 的过孔不动。
- 每一步的检查：第一次落线后 KiCad 报 1 条间距违规（I2C_SCL 的过孔离第 3 层的 CHG_STAT 线 0.078 mm，要求 0.10 mm），
  整步撤回；过孔左移 0.03 mm 后重做，KiCad 检查 0 违规、0 未连通，才保留。
- 这一处的实际间距（都在规则线上，没有余量）：

| 之间 | 实际 | 工程规则 |
|---|---|---|
| I2C_SCL 过孔 — I2C_SDA 过孔（中心距） | 0.554 mm | ≥0.55 mm（铜到铜 0.10 mm） |
| I2C_SDA 过孔 — CHG_INT 过孔（中心距） | 0.550 mm | ≥0.55 mm |
| I2C_SCL 过孔 — 第 3 层 CHG_STAT 线（铜到铜） | 0.10 mm | ≥0.10 mm |
| CHG_INT 过孔 — R3 第 1 脚焊盘（铜到铜） | 约 0.152 mm（按焊盘的圆角实形量；初稿按外接矩形算成 0.105 mm，偏小，已更正，见 7） | ≥0.10 mm（规范 GEN-7 要求 ≥0.15 mm） |

## 5. 规范核查（改摆位之后）

两个"1.8 mm"是两件事，分开记：

| 规则 | 要求 | 实测 | 结论 |
|---|---|---|---|
| RF-5 | 天线线两侧地孔间距 ≤2 mm | 14 个地孔，最大间隔 **1.8 mm** | 通过 |
| STK-6 | 第 4 层放信号线时，3.3 V 到每个用电点的最窄通道 ≥1.8 mm | **不适用，没有测量**：第 4 层上没有任何信号线（三个信号层的线段数：正面 1401、第 3 层 1044、背面 1066，第 4 层 0） | 不适用 |
| RF-9 | 背面其它信号离天线线 ≥1 mm | 最近 1.18 mm | 通过 |
| RF-6 | 天线线总长 ≤15 mm | 6.5 mm | 通过 |
| RF-11 | 天线座每个地焊盘旁 ≥2 个地孔 | 5 个、2 个 | 通过 |
| PWR-1 / 2 / 3 / 5 / 8 / 12 / 14、DEC-6 | 见 `gen/check.py` 的表 | 数字和改摆位之前一样 | 通过 |
| 底子完整 | 电源、地、3.3 V、天线、USB 全部连上 | 0 处没连 | 通过 |

没有借用第 4 层。

## 6. KiCad 检查通过但规范还没满足的

这几项 KiCad 的规则检查查不出来，投板前要处理或确认：

| 规则 | 要求 | 现状 |
|---|---|---|
| USB-3 | 每段两根线长度差 ≤0.5 mm | USBC 1.9 mm、ESP_USB 3.3 mm、LTE_USB 2.3 mm 三段不满足；ESP 那一段 0.0 mm 满足。USB 在底子里，这一轮没有动 |
| GEN-1 | 信号线 0.15 mm；引脚之间允许 0.10 mm，长度 ≤3 mm | 0.11 mm 的窄线共 112 段、合计 93 mm，都在引脚附近；其中 1 段长 4.22 mm（CAM_D1，背面，从 (49.96, 7.39) 起），两侧间距不够，加不宽 |
| GEN-7 | 过孔到焊盘 ≥0.15 mm | **没有写进 KiCad 规则**，现在按铜到铜 0.10 mm 检查。在副本里加上 0.15 mm 的规则实测：**107 个过孔**不满足（KiCad 9.0.9 报 109 对，KiCad 10.0.8 报 119 对），其中 21 个在锁定的底子里，最小 0.102 mm。初稿"约 130 个"是按外接矩形粗估的，已更正。决定：保留 0.15 mm，下一轮按这个值重做（见 7） |
| PWR-9 / PWR-7 / PWR-11 | 见规范的"待定问题" | 和之前一样，等确认 |
| SIG 类规则、`.kicad_dru`、光学定位点 | — | 还没做 |

另有两颗选配电阻的去留等确认（R8、R73，见 `README.md`"还没定的"一节）。

## 7. 独立复查（2026-11-12）及对本记录的更正

`731b83a` 由另一方用 **KiCad 10.0.8** 独立复查（文件级审查，未做实物验证）。其中能用工程文件核对的数字，
这边用 KiCad 9.0.9 和脚本重算过，逐项一致：

| 项目 | 独立复查（KiCad 10.0.8） | 这边重算（KiCad 9.0.9） |
|---|---|---|
| 未连通 / 布线违规 / 网络差异 | 0 / 0 / 0 | 0 / 0 / 0 |
| 字段差异警告 | 199 条（Description 175、Datasheet 17、Sim.Device 5、Sim.Pins 2） | 0 条。两个版本对"符号字段与封装字段不同"的检查范围不同；这 199 条不涉及网络和封装，待在 10.0.8 上处理或设为忽略 |
| ERC | 错误 0、警告 3 | 错误 0、警告 1（功放散热焊盘的引脚类型） |
| 第 4 层信号线、锁定对象数 | 0、860 | 0、860 |
| GEN-7 按 0.15 mm | 119 对、107 个过孔、最小约 0.102 mm | 109 对、107 个过孔、最小 0.102 mm |
| 焊盘内的过孔 | 17 个：15 个在 U2 / U8 / U17 的散热焊盘里，另 2 个在 C29.2 和 U9.34 | 同：U2 6 个、U8 5 个、U17 4 个，C29.2 (23.65, 24.45)、U9.34 (25.10, 22.50)，后两个是锁定的天线地孔 |
| 屏像素时钟 | ESP32 → R50 约 9.2 mm；R50 → J8.16 约 63.4 mm；共换层 5 次 | LCD_PCLK 9.2 mm、1 个过孔；LCD_PCLK_R 63.4 mm、4 个过孔 |
| RF-5 / RF-6 | 14 个地孔、最大间隔约 1.80 mm；线长约 6.47 mm | 14 个、1.8 mm；6.5 mm |

**对本记录的更正**

- 第 4 节：CHG_INT 过孔到 R3 第 1 脚焊盘是约 0.152 mm，不是 0.105 mm。
- 第 6 节：GEN-7 不满足的过孔是 107 个，不是"约 130 个"。
- 第 6 节的 USB-3 数字（1.9 / 3.3 / 2.3 mm）是整个网络的铜长相减，含测试点支路。按路径量：Type-C 两个插向到 U6
  约 3.09 / 1.74 mm，U6 到 ESP32 侧串阻约 3.42 mm，串阻到模组约 0.04 mm，U6 到 Air780E 主路径约 0.90 mm
  （独立复查的数字，这边还没有按路径重量）。

**独立复查新指出、这份记录原先没有覆盖的**

| 规则 | 现状 |
|---|---|
| VIP-1 小焊盘内不打孔 | C29.2（0.56 × 0.62 mm）和 U9.34（1.30 × 0.60 mm）里各有 1 个天线地孔，不满足。是 `route.py` 排天线两侧地孔时放进去的 |
| SIG-4 时钟线换层 ≤2 次 | 屏像素时钟换层 5 次、R50 之后长 63 mm，不满足。R50 应靠近驱动端，并为这条线规划路径 |
| GEN-10 换层处的回流地孔 | 28 个时钟和 USB 过孔里 23 个离最近的地孔超过 1 mm，没有检查过 |

**原理图和物料层面的问题**（不是布线问题，投板前要先定；定了以后才值得再布一轮）

1. Air780E 第 61 脚 VBUS：R44（10 kΩ 到 VDD_4G）默认不贴，电池供电时模组的 USB 可能不枚举。板上 4G 数据走 USB。
2. Type-C 保护器件 U1（USBLC6-2SC6）第 5 脚没接 VBUS，与 ST 的参考接法不同；器件电容最高 3.5 pF，规范 USB-7 写的是 <1 pF。
3. 电池温度：TS 脚用两颗 10 kΩ 固定分压，J2 第三个焊盘没有网络，没有电芯温度反馈；ILIM 680 Ω 对应约 0.53 A 输入；SY6970QCC 的供货状态要核对。
4. J4、J5、J8、J9、J10、J11 是占位封装，要按采购料号核对；板上没有光学定位点。

## 8. 2026-11-12 的决定和改动

针对第 7 节的原理图问题，已定的两条和做了的改动：

| 问题 | 决定 | 改了什么 | 依据和没核实的地方 |
|---|---|---|---|
| Air780E 第 61 脚 VBUS | R44（10 kΩ，VDD_4G → 第 61 脚）改为**默认贴** | 原理图、板上 R44 的贴装属性 | 板上 4G 的数据只走 USB，模组串口只到测试点；电池供电时没有外部 5 V。**合宙对这个脚的要求没有查到官方说法**，接法、阻值和电平仍要向合宙确认，并在样板上按"仅电池供电"验收枚举 |
| Type-C 保护芯片 U1 第 5 脚 | 接 VBUS（ST 的参考接法） | 原理图、板上这个焊盘的网络 | **板上还没连**：这个脚左右是锁定的 USB 线，上方是去 U6 的 USB 线，正下方背面是 Type-C 座的焊盘，没有过孔位。要和 USB 重画一起做 |
| U1 电容 3.5 pF 与 USB-7（<1 pF）矛盾 | 改规范，不换料（规范 V0.4） | `docs/layout-spec.md` 的 USB-7 | Type-C 这一路只通到 ESP32-S3，乐鑫文档写明它的 USB 只有全速 12 Mbps。3.5 pF 这个数来自独立复查引用的 ST 手册，这边没有再核对 |

屏的排线由屏厂按我们主板的脚位做：接口定义见 [`../../docs/display-interface-for-vendor.md`](../../docs/display-interface-for-vendor.md)，
排线座位置图见 [`../connector-positions.png`](../connector-positions.png)。

改动之后的检查（KiCad 9.0.9）：**未连通 1**（U1 第 5 脚到 VBUS）、布线违规 0、原理图一致性 0。

还没定的：电池温度反馈和充电参数（等电池选型）；SY6970QCC 的供货状态（没有核实）；各排线座的实际料号。

## 9. 屏的资料到了之后（2026-11-12）

屏厂给了华迪创显 HD28142C22 的规格书、图纸和初始化代码。

- **这个型号是两通道 MIPI-DSI 接口，主板（ESP32-S3，8 位串行 RGB + 三线 SPI）驱动不了。** 能不能做 RGB 接口的版本要屏厂答复，
  见 [`../../docs/display-interface-for-vendor.md`](../../docs/display-interface-for-vendor.md) 第 0 节。这件事没定之前不要投板。
- 背光按规格书改了：电流采样电阻 R62 从 5.1 Ω 改成 10 Ω（20 mA，这块屏的上限）。只改了阻值，板子的铜没有动。
- 改动之后的检查（KiCad 9.0.9）：未连通 1（U1 第 5 脚到 VBUS，同第 8 节）、布线违规 0、原理图一致性 0。

## 10. 下一轮布线（2026-11-12 开始，还没做完）

目的：把第 6、7 节里"KiCad 通过但规范没满足"的几项做掉。**仓库里的板子文件没有换，仍是 731b83a 那版走线**
（570 处全通，加上后来改的 U1.5，共 575 处里 574 处连通）。这一节记的是脚本的改动和在草稿副本上量到的结果。

### 10.1 已经做到的（底子，草稿副本上验证过）

| 项 | 原来 | 现在 | 怎么做的 |
|---|---|---|---|
| GEN-7 过孔离贴片焊盘 ≥0.15 mm（同网络也算） | 297 个不够 | 0 | `route.py` 的 `VIA_PAD`；交给 Freerouting 的副本里每个贴片焊盘加一圈禁孔区；`board.py` 写出 `.kicad_dru` |
| VIP-1 小焊盘上不打孔 | 66 个 | 0 | 同上；天线地孔在芯片地焊盘里时也检查背面的小焊盘 |
| USB-3 Type-C → 切换芯片 | 差 1.4 ~ 1.7 mm | 0.39 / 0.23 mm（A / B 面触点） | 这一段手工画，D− 在背面加一个弯 |
| USB-3 切换芯片 → 串联电阻 | 差 3.4 mm | 0.09 mm | D+ 在电阻这头先沿背面往下走，再从内层回来 |
| USB-3 Air780E → 切换芯片 | 1.12 mm | 0.07 mm | 这次底子自己就对上了 |
| U1 第 5 脚接 VBUS | 没连 | 连上 | 新底子里从芯片肚子底下接到右侧 VBUS 铜带 |
| RF-5 天线线两侧地孔 | 13 个，最大间隔 1.9 mm（其中 2 个压在背面小焊盘上） | 11 个，最大间隔 1.9 mm，没有压焊盘的 | 没位置的地方往外多找一档；最远的一个离线中心 1.65 mm |
| 稳压芯片输出电容 | 交给自动布线 | 手工接在输出脚上 | 自动布线曾从 0.75 mm 的缝里穿一根信号线，把电容和芯片隔开 |

GEN-7 和 VIP-1 的"原来"是按这次新写的检查项量的：同网络的焊盘也算，所以比独立复查的 107 个多，
多出来的主要是旧底子里电源和地的过孔贴在自己的焊盘上。USB-3 的"原来"也是按新量法（引脚到引脚，
不算到测试点的支线）重新量的。

### 10.2 还没做到的：信号线没有全部连上

新底子上跑 Freerouting 2.5.0，再用 `finish.py` 收尾，KiCad 9.0.9 检查（带上 GEN-7 规则）：
**间距违规 0，一致性问题 0，未连通 13 ~ 19 处**（共 575 处）。过孔规则两项始终是 0。

| 试的版本 | 时间 | 剩余 |
|---|---|---|
| 禁孔区 = 焊盘外扩 0.15 mm | 20 分钟 | 34 |
| 禁孔区 = 焊盘外扩 0.05 mm（Freerouting 自己还会留 0.10 mm） | 20 分钟 | 13 |
| 加：稳压芯片输出电容手工接 | 25 分钟，三个一起跑 | 14 |
| 再加：按键 4 ~ 6 的上拉电阻挪到按键排线座 B 旁 | 同上 | 16（已撤回：挡住后摄排线座最右几个脚的出线） |
| 再加：正面 VSYS 铜带在充电芯片下方让 0.7 mm | 同上 | 16 |
| 撤回上拉电阻，保留铜带让位，U15 左移 0.6 mm | 25 分钟，单独跑 | 19 |

| 加：短的信号连接先接（留给自动布线 174 处），CC 电阻挪出 5 V 铜带的圈 | 25 分钟 | 19 |
| 再加：电阻的地 / 3.3 V 焊盘并到附近已有的铜上（省 32 个过孔），USB 两头手工固定 | 25 分钟 | 19 |
| 上一行的结果，收尾时允许剩下的线借用 L4（STK-6） | — | 14 |

自动布线每一遍的走势都一样：前 10 分钟从约 100 处降到约 40 处，之后在 22 ~ 30 处之间波动，延长时间没有用。
借用 L4 只多接上 5 处，说明剩下的不是层不够，而是线从排线座和芯片引脚旁出不来：按 0.15 mm 的规则，
这些地方的过孔位不够。例如后摄排线座 J10（背面，24 脚）：脚下方到 Air780E 焊盘之间只有一排过孔位，
脚上方的正面是晶振和一排电阻，打不了孔；正面沿上边缘已经排满，没有地方可挪。

**对照：把过孔到焊盘放宽到 0.10 mm（`VIA_GAP=0.10`，仍不许压焊盘），同样的底子和 25 分钟：剩 21 处。**
和 0.15 mm 的 13 ~ 19 处没有区别。所以 0.10 和 0.15 之间的那 0.05 mm 不是关键。上一版能全通，靠的是
电源和地的过孔直接贴在、压在自己的焊盘上（66 个压小焊盘），引线长度为零，把焊盘旁的位置让给了信号线。
只要"过孔不碰焊盘"，不管间距取 0.10 还是 0.15，这块板都差十几处。

几遍之间差 ±5 处，是自动布线自己的波动；每遍没连上的是不同的线，集中在三处：屏排线座的数据线
（背面排线座正上方是正面的稳压芯片一排，过孔几乎没处打）、右边缘 IO 扩展芯片 A 下方、充电芯片的四个信号脚。

### 10.3 原因和要定的事

上一版能全部连通，是因为电源和地的过孔贴着或压着自己的焊盘。把过孔从焊盘上挪开之后，排线座和芯片引脚旁
的过孔位不够，剩下十几处；多跑、延长时间、借用 L4、放宽到 0.10 mm 都试过，没有一样能接满（见 10.2）。
正面沿上边缘已经排满，靠挪元件腾位置的余地很小。

两条路：

1. **过孔做树脂塞孔加电镀盖帽，允许过孔贴着、压着焊盘（盘中孔工艺）。** GEN-7 和 VIP-1 防的是焊锡流进孔里、
   焊盘上锡量不够，塞孔盖帽之后这两个问题都不存在。这样可以回到上一版的走线（已经全通），只补做两件事：
   U1 第 5 脚接 VBUS、三段 USB 线配长。要先向板厂确认六层板这个工艺的价格、最小孔径和焊盘尺寸要求。
2. **坚持过孔不碰焊盘。** 那就要重新排几个排线座周围的元件，或者加大板子、减少元件。屏改成 QSPI 之后
   屏排线上的信号从 13 根减到 7 ~ 8 根，会松一些，但后摄排线座、IO 扩展芯片 A、4G 模块旁的小元件这几处不受影响。

这是工艺、成本和结构的取舍，由项目来定。
