TENLEAP-AI/digital-human-koubo/hardware/esp32-s3-board/kicad/connector-positions.png

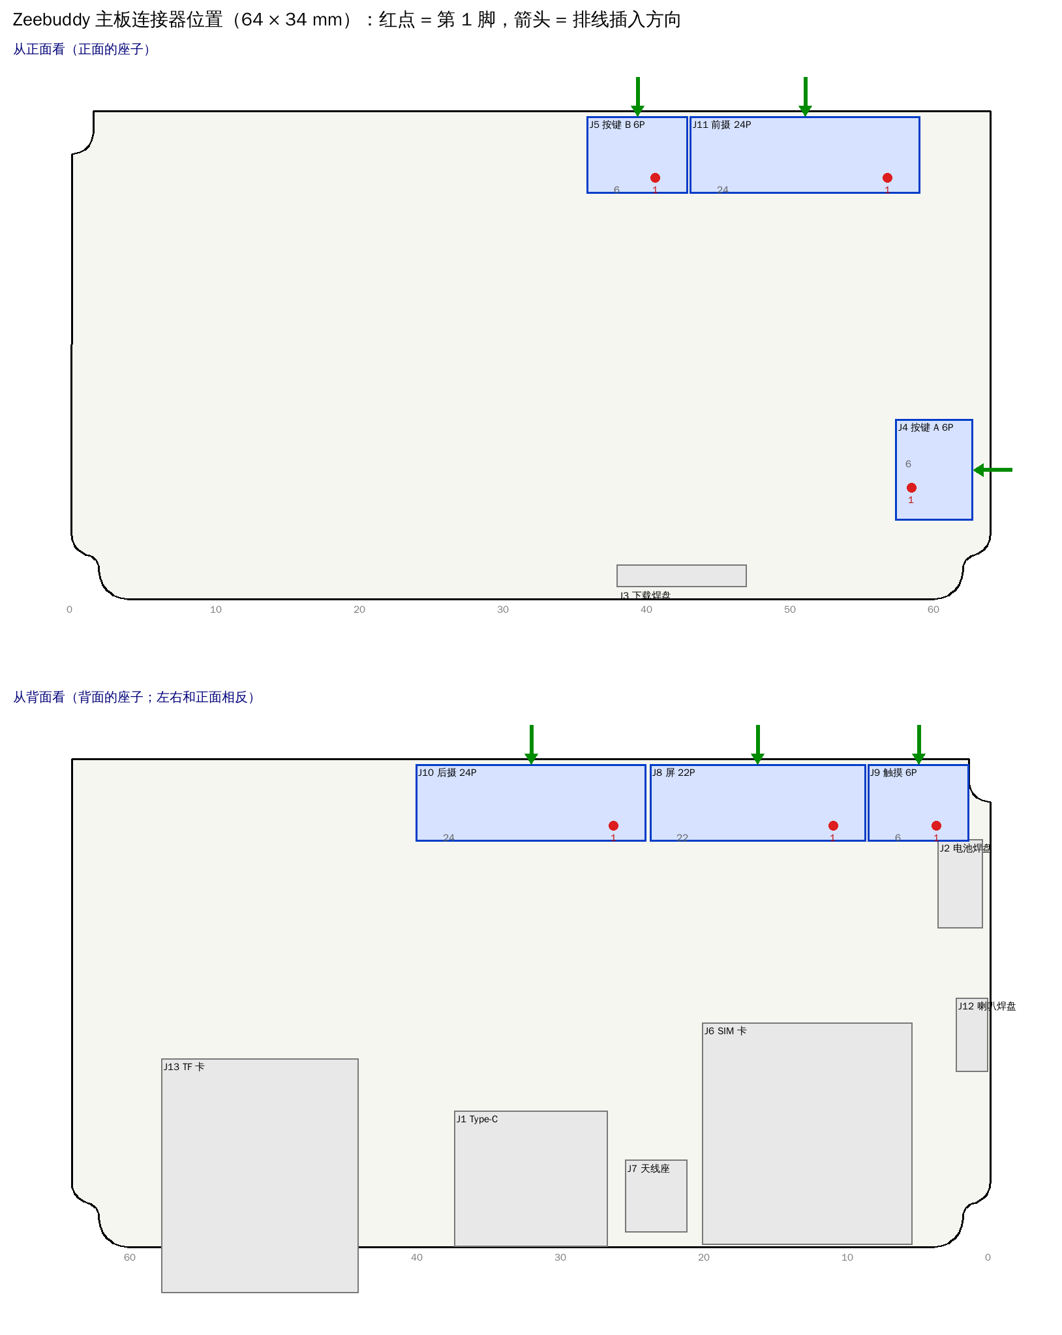
hardware/esp32-s3-board/kicad/connector-positions.png
