TENLEAP-AI/digital-human-koubo/hardware/esp32-s3-board/kicad/placement-front.png

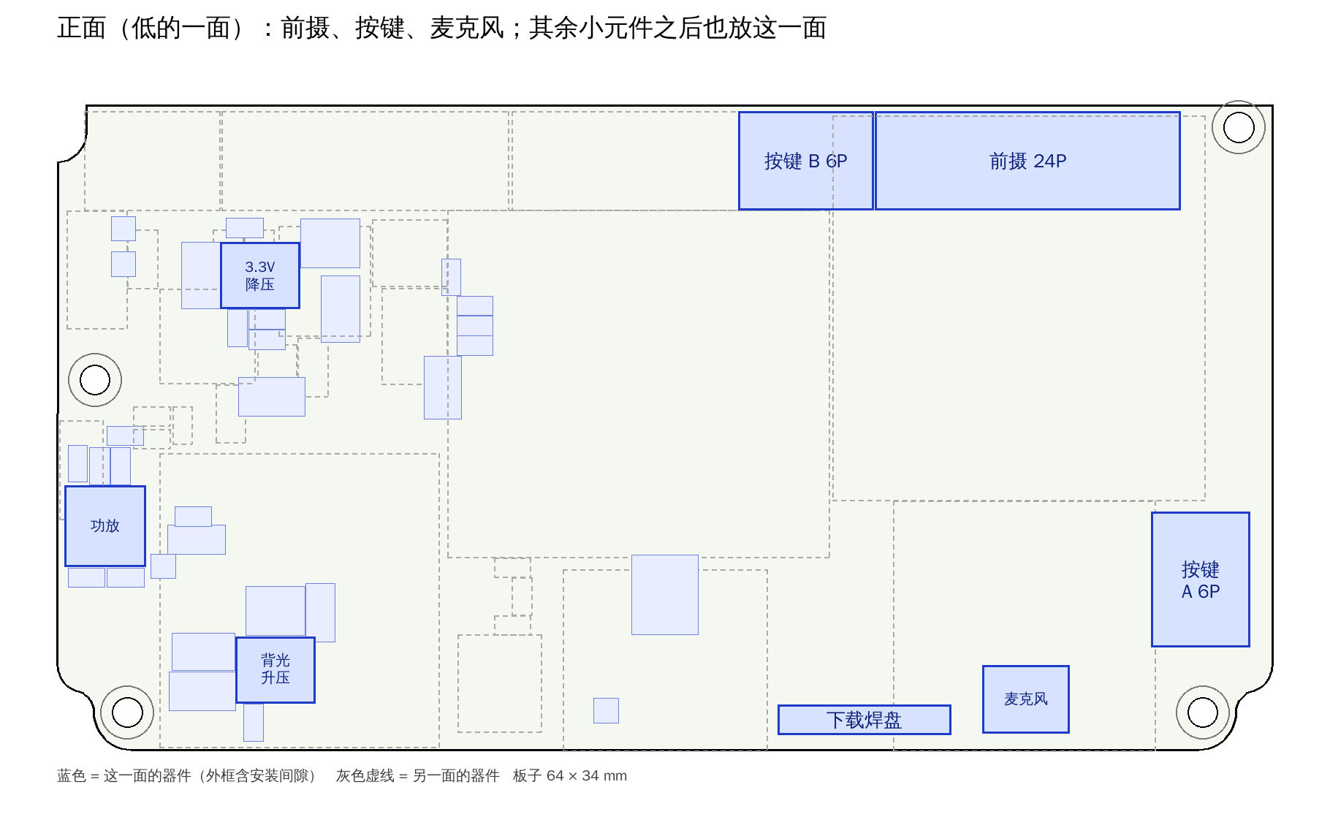
hardware/esp32-s3-board/kicad/placement-front.png
