TENLEAP-AI/digital-human-koubo/hardware/esp32-s3-board/kicad/routing.png

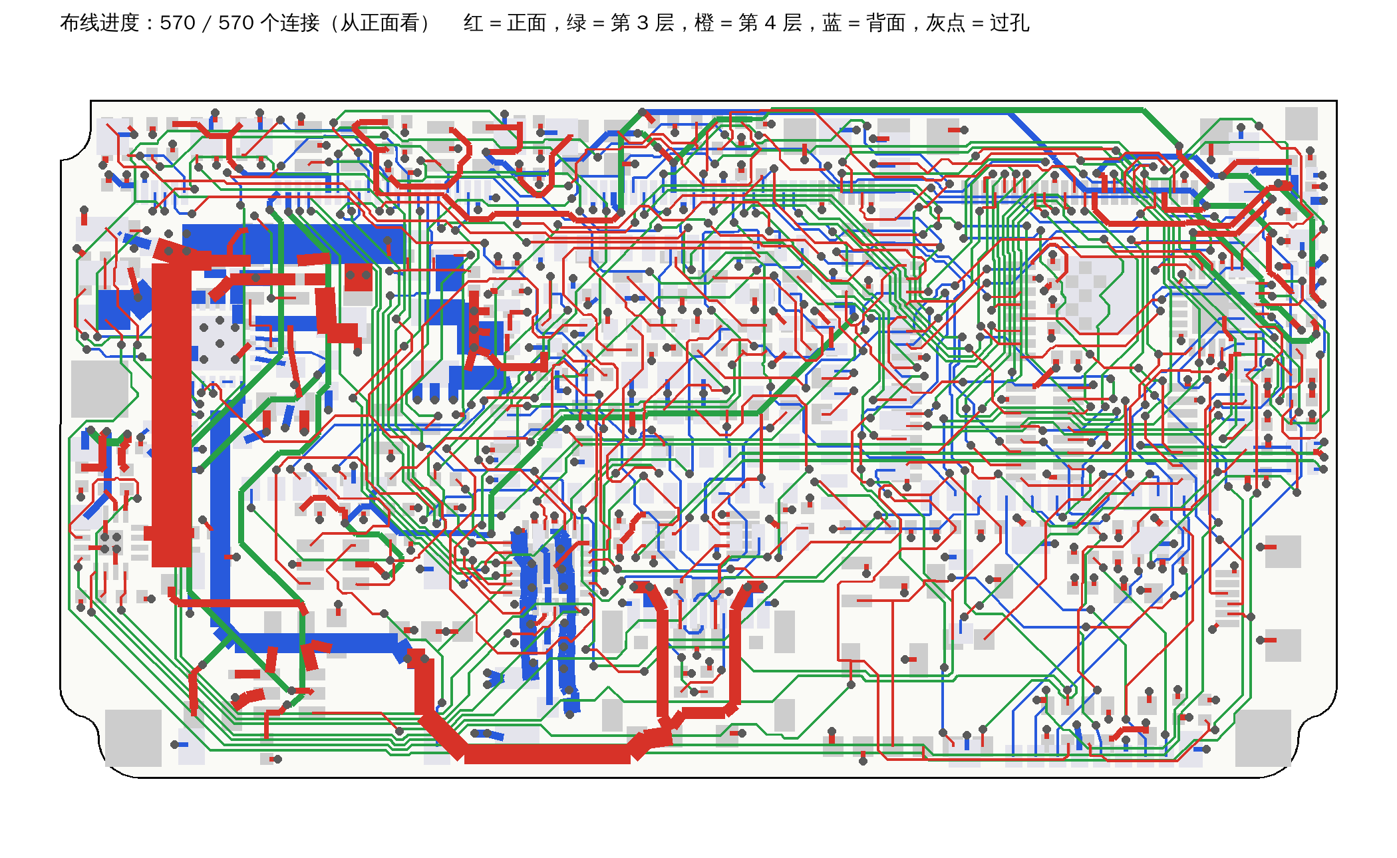
hardware/esp32-s3-board/kicad/routing.png
