TENLEAP-AI/digital-human-koubo/hardware/esp32-s3-board/docs/bom-estimate.md

# 主板 BOM 成本估算（按嘉立创 / 立创商城价格）

> **这是原理图之前的粗估。** 元件清单按 [requirements.md](requirements.md) 的方案三推出来，具体型号还没定。
> 价格是 2026-11 网上搜索到的快照，不是下单页的实时报价；标"估"的是我自己的估计，没有查到报价。
> 等原理图画完，再出一份带立创编号的精确 BOM。

## 结论

| 项目 | 每块板 |
|---|---|
| 元件 | **约 79 ~ 100 元** |
| 其中两个模组（ESP32-S3 + Air780E） | 约 45 ~ 47 元，占一半左右 |
| 贴片加工（见下表，随数量变化很大） | 约 8 ~ 72 元 |
| PCB（四层，64 × 34 mm，估） | 约 2 ~ 20 元 |

| 数量 | 元件 | 贴片 | PCB（估） | **每块合计** |
|---|---|---|---|---|
| 10 块（打样） | 约 100 | 约 72 | 10 ~ 20 | **约 180 ~ 190 元** |
| 100 块 | 约 89 ~ 100 | 约 14 | 4 ~ 6 | **约 107 ~ 119 元** |
| 1000 块 | 约 79 ~ 89 | 约 8 | 2 ~ 4 | **约 89 ~ 101 元** |

不含：屏和触摸、两个摄像头、电池、喇叭、天线、按键和 TF 卡的排线小板、外壳、测试和认证费用。

## 元件明细

"来源"一栏：**查** = 搜到的报价；**估** = 我的估计。

| 元件 | 数量 | 单价（元） | 小计（元） | 来源 |
|---|---|---|---|---|
| ESP32-S3-WROOM-1U-N16R8 模组 | 1 | 20.69 | 20.69 | 查：立创商城 C3013946 单片价 |
| Air780E 模组 | 1 | 24 ~ 25.9 | 24 ~ 25.9 | 查：合宙官方商城 25.9；批量约 24 出自第三方文章 |
| 充电管理芯片（I²C、电源路径、电量检测） | 1 | 3.8 ~ 9.76 | 3.8 ~ 9.76 | 查：SY6970 立创国际站约 0.52 美元；BQ25895 立创 9.76 |
| IO 扩展芯片 XL9555 | 2 | 3.07 ~ 4.77 | 6.14 ~ 9.54 | 查：立创阶梯价，1000 片 3.07，单片 4.77 |
| I²S 功放 | 1 | 2.25 ~ 4.98 | 2.25 ~ 4.98 | 查：NS4168 2.25；MAX98357A 4.98 |
| I²S 硅麦 | 1 | 3 ~ 6 | 3 ~ 6 | 估 |
| 3.3 V 降压芯片 + 电感 | 1 | 0.5 ~ 0.8 | 0.5 ~ 0.8 | 查：SY8089 0.47；电感为估 |
| 背光升压驱动 + 电感 + 二极管 | 1 | 1.5 | 1.5 | 估 |
| 摄像头 LDO（2.8 V、1.2 V） | 2 | 0.3 | 0.6 | 估 |
| 摄像头有源晶振 | 1 | 1.0 | 1.0 | 估 |
| USB 切换芯片 + ESD 保护 | 1 | 2.0 | 2.0 | 估 |
| 电源开关、三极管、TVS 等分立器件 | 1 组 | 2.5 | 2.5 | 估 |
| Type-C 16P 母座 | 1 | 0.26 ~ 1.13 | 0.26 ~ 1.13 | 查：立创，不同型号 |
| Nano SIM 自弹卡座 | 1 | 1.42 ~ 3.93 | 1.42 ~ 3.93 | 查：立创，不同型号和数量档 |
| TF 卡座 | 1 | 1.0 | 1.0 | 估 |
| FPC 座（屏、触摸、摄像头 ×2、按键 ×2） | 6 | 0.4 | 2.4 | 估 |
| IPEX 天线座 | 2 | 0.3 | 0.6 | 估 |
| 电池座 | 1 | 0.3 | 0.3 | 估 |
| 阻容感（约 150 颗） | 1 组 | 3.0 | 3.0 | 估 |
| 220 µF 钽电容（Air780E 供电） | 1 | 2.0 | 2.0 | 估 |
| **合计** | | | **78.96 ~ 99.63** | 查到报价的部分 59 ~ 77；估的部分 20 ~ 23 |

## 原理图 V1 的实际选型（2026-11 更新）

原理图画完后，实际选型与上表的差别：

| 项目 | 估算时的假设 | 原理图 V1 | 对成本的影响 |
|---|---|---|---|
| 充电芯片 | SY6970 或 BQ25895 | SY6970QCC | 取区间低端 |
| 功放 | NS4168 或 MAX98357A | MAX98357A | 取区间高端。NS4168 不适合用电池电压供电 |
| 总线开关 | 没算 | 3 颗 74CBTLV3257，隔开前后摄 | 约 +3 元（估） |
| 扩展芯片、降压、背光驱动、麦克风 | XL9555、SY8089 等 | XL9555QF24、SY8089AAAC、SY7200AABC、MSM261S4030H0R | 不变 |

按这个选型，元件成本约 **85 ~ 97 元 / 块**。

## 贴片加工

按搜到的嘉立创收费规则算：焊点 0.01 元 / 个，工程费 50 元，钢网免费，扩展库元件每种 20 元。

- 焊点约 729 个 → 每块约 7.3 元。
- 固定费用：工程费 50 元 + 扩展库约 30 种 × 20 元 = 约 650 元，按数量摊。

| 数量 | 每块贴片费 |
|---|---|
| 10 块 | 约 72 元 |
| 100 块 | 约 14 元 |
| 1000 块 | 约 8 元 |

没有核实的地方：

- 板子很小，元件大概率要放两面。双面贴的收费我没有查到，实际会比上面高。
- Air780E 是否在嘉立创的可贴片库里没有确认。不在的话要自己寄料，或者手工焊。
- "扩展库约 30 种"是按元件清单猜的，定型号时尽量选基础库可以降下来。

## PCB

四层、64 × 34 mm、0.8 mm 厚，每块面积约 21.8 cm²。

- 嘉立创国际站写的是四层板 10 × 10 cm 以内 7 美元起（片数和工艺条件页面没写）。国内站的人民币价格我没有查到。
- 表里的 PCB 单价是我的估计：打样按一批 50 ~ 100 元摊到 5 ~ 10 块；批量按每块 2 ~ 4 元。
- 0.8 mm 板厚、USB 和天线走线的阻抗控制可能另外加钱，下单时才知道。

## 能省钱的地方

1. **充电芯片**：用 SY6970 而不是 BQ25895，省约 6 元。两者功能接近，脚位兼容需要核对。
2. **功放**：用 NS4168 而不是 MAX98357A，省约 2.7 元。
3. **ESP32-S3**：用芯片 ESP32-S3R8（PSRAM 已封在芯片里）加外置 Flash、晶振和射频匹配代替模组。
   芯片立创国际站 1000 片约 2.25 美元，模组约 3.48 美元；扣掉 Flash 和晶振（估），每块省 3 ~ 5 元。
   高度从 3 mm 左右降到 1 mm 以内，占板面积也小。代价是射频要自己调、无线认证要整机重做，第一版不建议。
4. **IO 扩展芯片**：批量后单价从 4.77 降到 3.07，两颗省约 3.4 元。

## 还没查到的价格

- 北美版模组 Air780EEN 的价格。
- I²S 硅麦、背光驱动、LDO、晶振、TF 卡座、FPC 座、IPEX 座等小料的具体报价。
- 嘉立创四层板的人民币报价、双面贴片的收费。

## 价格来源

- ESP32-S3-WROOM-1U-N16R8：立创商城，编号 C3013946。
- Air780E：合宙官方商城的统一售价。
- 其它芯片和连接器：立创商城和立创国际站的商品页（搜索结果摘要，没有逐页打开核对）。
- 嘉立创四层板起价：https://jlcpcb.com/features/prototype-pcb-way
