TENLEAP-AI/digital-human-koubo/hardware/esp32-s3-board/docs/display-samples-two-makers.md

# 两家屏的打样汇总（内部用，不发屏厂）

日期：2026-11-12。**2026-11-14：两家屏的打样已安排（都按 16 位并口 RGB、40 脚公母座）**。两家同时打样，样品在开发板上测完再定用哪一家，主板跟着改。

## 1. 发给屏厂的文件

| 屏厂 | 驱动芯片 | 接口 | 发这份 |
|---|---|---|---|
| 甲：联讯（ST7102，之前发来 LX280BS0111 规格书） | ST7102 | **16 位并口 RGB**（2026-11-14 由 QSPI 改） | [display-request-rgb-st7102.md](display-request-rgb-st7102.md) |
| 乙：做 NV3049F 的那家 | NV3049F | **16 位并口 RGB**（2026-11-14 由 8 位串行改；做不了再退回串行） | [display-request-rgb-nv3049f.md](display-request-rgb-nv3049f.md) |

两份的 Word 版在 [`vendor/`](vendor/) 目录，可以直接转发。

**2026-11-14：主控换 ESP32-S31，两家屏都改成 16 位并口 RGB（RGB565），排线统一成同一个 40 脚公母座定义**，主板一个座子两家都能插。下面的对比表是按 S3 和 QSPI 写的，留作记录。

## 2. 两家对比

| | 甲：ST7102，QSPI | 乙：NV3049F，串行 RGB |
|---|---|---|
| 屏厂的说法 | 不支持串行 RGB，支持 QSPI 和 MIPI（口头） | 工程看过要求，"能做，重新开一条排线"（口头） |
| 我们核实过没有 | **没有**。手里没有 ST7102 规格书 | **部分**。NV3049F 的串行 RGB 屏市面上有；NV3049 的老手册里没有这个模式 |
| 主控占的脚 | 6 个，加 TE 共 7 个 | 9 个，其中 2 个和调试串口共用 |
| I/O 扩展芯片占的脚 | 1 个（复位） | 4 个（复位、三线 SPI） |
| 排线上的信号 | 8 根 | 13 根 |
| 显存 | **待确认**。有的话主控只在画面变化时送数据 | 没有，主控一直送 |
| 整屏帧率（估算） | SCK 40 MHz、16 位色：最多约每秒 32 帧 | DOTCLK 20 ~ 26 MHz：每秒 17 ~ 22 帧 |
| 颜色 | 16 位（RGB565，约 6.5 万色） | 屏本身是 RGB666（每种颜色 64 级，约 26 万色）；首版只接 5 根数据线，每种颜色 32 级，约 3.3 万色。多接 1 根（D2，要 1 个主控引脚）就是屏的全部颜色 |
| 背光 | 现有屏是 4 颗并联，**要改串联** | 待答复，已要求串联 |
| 触摸 | in-cell，屏自带，只贴盖板，联讯做总成；触摸信号和屏走同一个公母座 | 外挂电容触摸（CST836U 或同类），优先并进屏的公母座 |
| 屏供电 | 现有屏是 2.8 V，要确认 3.3 V 能不能用 | 待答复 |
| 主板 | **要改**：原理图、J8 脚位、主控脚位分配、这一带的走线 | 现在的主板就是按这个接口画的 |
| 最大的风险 | 芯片能不能用 QSPI 送图像；没有显存的话主控能不能一直送得过来 | 帧率偏低，画面变化快时可能闪 |

**2026-11-14 补充：ST7102 支持并口 RGB**。乐鑫组件库里有第三方的 ST7102 驱动（写明 RGB / MIPI DSI 两种接口），同一作者还有一块"ESP32-S31 + 4.3 寸 480 × 800 RGB in-cell 屏（ST7102 + ST7123 触摸）"的板级包，说明 ST7102 用并口 RGB 在 S31 上跑过。联讯说的"不支持 8 位串行 RGB"指的是串行那种，并口 RGB 应该支持，位数待联讯确认。并口 RGB 在 S31 上要约 20 根线（16 位数据 + 4 根同步），比 QSPI 的 7 根多很多，要把按键挪回扩展芯片、加回第二颗扩展芯片才放得下，所以只作为 QSPI 不行时的备选，已加进联讯打样文件的问题表第 12 条。

甲的条件更好：线少、帧率高、调试串口不用和屏共用，屏排线座那一带也是现在 PCB 最挤的地方。
但它的前提一条都还没核实，所以乙不能停。

## 3. 打样前必须拿到的书面内容

没拿到这些就不付模具费。两家要的一样（2026-11-14 起都是 16 位并口 RGB）：

1. 规格书里讲接口选择和 RGB 时序的那几页，证明芯片支持 16 位并口 RGB（NV3049F 不支持的话，确认 8 位串行备选）。
2. **屏的 IO 电平能用 3.3 V。**
3. 16 位模式的完整初始化代码、像素时钟范围、前后沿和极性。
4. 背光串联的确认；屏只用 3.3 V 的确认。
5. 触摸的芯片型号、I²C 地址、电平（联讯是 in-cell，NV3049F 是外挂 CST836U 一类）。
6. 排线图、亚奇公母座型号、母座脚号对照表（按我们的 40 脚定义）。

## 4. 验证的步骤

| 阶段 | 什么时候 | 做什么 |
|---|---|---|
| 0 | 现在 | 买开发板、转接板、背光恒流、摄像头模块、逻辑分析仪；可以先买一两片现成的 NV3049F 串行 RGB 屏（LB28BOE47），提前测串行 RGB 的帧率和闪烁 |
| 1 | 屏厂书面答复后 | 对照第 3 节的清单，缺一样就不付模具费 |
| 2 | 样品到了 | 两家按同样的项目测，记数字。两家都是 16 位并口 RGB，按[开发板验证教程](devboard-validation-guide.md)第三 ~ 五节的方法测（数据宽度改成 16） |
| 3 | 两家都测完 | 按下面的合格线选一家，再看价格和交期 |
| 4 | 选定后 | 按第 5 节改主板 |

## 4.1 样品到了怎么测

两家的排线末端都是亚奇的板对板公座（2026-11-13 定），测试不用等主板：

| 准备 | 说明 |
|---|---|
| ESP32-S3-DevKitC-1-N16R8 | 和主板同一颗芯片、同样的 PSRAM |
| 公母座转接小板 | 贴配套的亚奇母座，引到 2.54 mm 排针。公母座型号定了才能做，最好请屏厂随样品一起配几块；两家型号相同就共用 |
| 背光恒流 | 可调电源限流 20 mA，或背光升压恒流小板。**LEDA / LEDK 不能直接接 3.3 V 或 5 V** |
| 摄像头模块 | 测"刷屏 + 取景"同时进行 |

两家测同样的几项，记下数字对比：

| # | 测什么 | 合格线 |
|---|---|---|
| 1 | 用屏厂给的初始化代码点亮，彩条颜色对 | 必须 |
| 2 | 整屏刷新的实际帧率 | 每秒 20 帧以上 |
| 3 | 手机慢动作录像看闪不闪 | 不闪 |
| 4 | 画面移动时有没有撕裂（甲用 TE 同步） | 看不出 |
| 5 | 同时开摄像头取景，画面稳不稳 | 不漂、不花 |
| 6 | 屏加背光的电流 | 记录，算续航用 |

具体的接线和固件设置按 [开发板验证教程](devboard-validation-guide.md) 做：两家都按第三 ~ 五节测，`data_width` 改成 16、每像素 16 位。

## 5. 选定之后主板要改的

- **选乙**：主板不用改接口。只需按屏厂的排线图定排线座上接还是下接，背光按屏厂答复核对电流。
- **选甲**：按 [QSPI 提案](display-interface-qspi-proposal.md) 第 6 节改原理图、J8 脚位和主控脚位，PCB 上屏这一带重新布线。
  新版布线（分支 `claude/board-v2-gen7-round`）剩下的十几处正好有几处在这一带，会一起处理。
