TENLEAP-AI/digital-human-koubo/(list of files, drawings)

Other design files:
hardware/esp32-s3-board/kicad/freerouting/zeebuddy-mainboard.dsn
