TENLEAP-AI/digital-human-koubo/hardware/esp32-s3-board/kicad/gen/libs.py

"""Load symbols from the installed KiCad libraries and flatten derived symbols."""
import copy
import os

from sexpr import Sym, find, first, parse

SYMDIR = "/usr/share/kicad/symbols"
_cache = {}


def _lib(lib):
    if lib not in _cache:
        with open(os.path.join(SYMDIR, lib + ".kicad_sym"), encoding="utf-8") as f:
            tree = parse(f.read())
        _cache[lib] = {s[1]: s for s in find(tree, "symbol")}
    return _cache[lib]


def load(lib_id):
    """Return a flattened symbol node named 'Lib:Name'."""
    lib, name = lib_id.split(":")
    sym = copy.deepcopy(_lib(lib)[name])
    ext = first(sym, "extends")
    if ext is not None:
        parent = copy.deepcopy(load(lib + ":" + ext[1]))
        pname = ext[1]
        props = {p[1]: p for p in find(sym, "property")}
        out = []
        for item in parent:
            if isinstance(item, list) and item[0] == "property" and item[1] in props:
                out.append(props.pop(item[1]))
            elif isinstance(item, list) and item[0] == "symbol":
                item[1] = name + item[1][len(pname):]
                out.append(item)
            else:
                out.append(item)
        # extra properties defined only by the child go before the first unit
        idx = next((i for i, it in enumerate(out) if isinstance(it, list) and it[0] == "symbol"), len(out))
        for p in props.values():
            out.insert(idx, p)
            idx += 1
        sym = out
    sym[1] = lib_id
    return sym


def pins(sym):
    """List of dicts: number, name, x, y, angle, length, etype, unit."""
    res = []
    for unit in find(sym, "symbol"):
        unit_no = int(unit[1].rsplit("_", 2)[1])
        for p in find(unit, "pin"):
            at = first(p, "at")
            res.append(dict(
                number=first(p, "number")[1], name=first(p, "name")[1],
                x=float(at[1]), y=float(at[2]), angle=int(float(at[3])) if len(at) > 3 else 0,
                length=float(first(p, "length")[1]), etype=str(p[1]), unit=unit_no,
                hidden=any(isinstance(t, Sym) and t == "hide" for t in p) or (first(p, "hide") or [0, Sym("no")])[1] == "yes",
            ))
    return res
