TENLEAP-AI/digital-human-koubo/(commit log)

2026-11-10 docs(hardware): add ESP32-S3 schematic and layout design notes
    Summarize the constraints from Espressif's hardware design guidelines,
    chip and WROOM-1 module datasheets, and the DevKitC-1 reference design
    as the basis for the upcoming board schematic and PCB layout.
    Claude-Session: https://claude.ai/code/session_01JQaTnpSi55n8moiBs7CGgN
2026-11-10 chore(hardware): add KiCad 9 install and toolchain check scripts
    install-kicad.sh installs KiCad 9 from the official PPA (Ubuntu 24.04 only
    ships 7.0.11, which lacks command-line DRC/ERC) and sets up the global
    library tables. check-toolchain.sh builds a throwaway board through the
    Python API and runs DRC, fabrication export, render, ERC and netlist export.
    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
2026-11-10 docs(hardware): add Air780E design notes for pairing with ESP32-S3
    Summarize the constraints from Luat's Air780E hardware manual, AT-mode
    reference schematic and design guides (power, power-on, UART, SIM,
    antenna), plus derived recommendations for wiring it to an ESP32-S3 host.
    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
2026-11-10 docs(hardware): record AT + PPP over UART as the Air780E link to ESP32-S3
    PPP is confirmed in the vendor feature table and AT manual; the manual has
    no CMUX, so note the DTR and RTS/CTS wiring this implies and which signals
    must stay on native GPIO.
    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
2026-11-10 docs(hardware): add board requirements and GPIO budget
    Record the confirmed requirements and flag that an ST7701 (SPI + RGB)
    panel does not fit the ESP32-S3 pin budget alongside a DVP camera.
    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
2026-11-10 docs(hardware): detail the GPIO budget and draft pin map
    With an SPI panel the design fits the 33 usable GPIOs of the N16R8 module
    (31 without TF card, 33 with); an ST7701 RGB panel is 14 pins short.
    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
2026-11-10 docs(hardware): rework the display option for the actual LB28BOE47 panel
    The confirmed panel uses an NV3049F with SPI + RGB and only 8 data lines,
    so it needs 12 native pins rather than 20. Record its pinout, the revised
    GPIO budget (6 pins short before trade-offs) and the open questions.
    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
2026-11-10 docs(hardware): make the TF card a requirement and redo the display budget
    With a TF card the RGB panel no longer fits the ESP32-S3 (one pin short
    even after every trade-off); the SPI panel option still fits.
    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
2026-11-10 docs(hardware): add a scheme that fits the 480x640 RGB panel on ESP32-S3
    Link the Air780E over USB instead of UART, wire only the top five bits of
    the panel data bus, clock the camera from an oscillator and read battery
    voltage over I2C. All 33 GPIOs are assigned; open risks are listed.
    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
2026-11-10 docs(hardware): record why the SPI-camera alternative is not adopted
    Note the open question on how Espressif's measured PCLK ceiling applies
    to an 8-bit serial RGB panel.
    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
2026-11-10 docs(hardware): add Espressif's SPI camera limits on ESP32-S3
    SPI sensors top out at 240x320 colour (or VGA greyscale at 4 fps on S3);
    2 MP stills are only supported over DVP with JPEG output.
    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
2026-11-10 docs(hardware): add NV3049F public-source research
    Collect what open drivers and vendor docs confirm about the NV3049F
    (serial RGB with three clocks per pixel, RGB666, no GRAM, MIPI option,
    init method, real-product timings) and what still needs the panel vendor.
    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
2026-11-10 docs(hardware): cite the TRM on simultaneous LCD and camera use
    The ESP32-S3 TRM states LCD_CAM supports an LCD and a camera at once,
    bounded by 80 MB/s of GDMA bandwidth. Also note the data-bit alignment
    risk and a resistor option for testing all eight panel data lines.
    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
2026-11-10 docs(hardware): research the MIPI panel variant and the ESP32-P4 route
    Record the HXW661528 30-pin MIPI + touch pinout, ESP32-P4 facts from the
    datasheet and design guide, and a side-by-side with the ESP32-S3 serial
    RGB route.
    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
2026-11-10 docs(hardware): record that the ESP32-P4 / MIPI route is ruled out
    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
2026-11-10 docs(hardware): move TF card lines off strapping pins
    Put the hot-pluggable TF card on GPIO15/17/21 and the on-board I2S
    BCLK/DOUT on GPIO0/3 instead. Note series resistors on the GPIO43/44
    panel lines, reserved camera bus switches, and the sales-region
    question for the LTE module.
    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
2026-11-10 docs(hardware): adopt USB modem link and Air780EEN compatibility
    Record the decisions to link the modem over USB and to keep the board
    drop-in compatible with the North America Air780EEN. The two footprints
    are identical, but the EEN is 1.8 V-only, so modem-side signals are made
    level-independent.
    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
2026-11-10 docs(hardware): add a dev-board validation guide
    Step-by-step bring-up on an ESP32-S3-DevKitC-1-N16R8: the panel alone
    (PCLK sweep, effective data bits, DE-only), then panel plus OV2640, then
    with the Air780E over USB, with wiring tables, pass criteria and record
    sheets.
    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
2026-11-10 docs(hardware): add a rough mainboard BOM cost estimate
    Pre-schematic estimate based on the adopted pin plan. Prices are search
    snapshots from LCSC / JLC, with unverified items marked as estimates.
    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
2026-11-10 docs(hardware): correct the chip-versus-module note in the BOM estimate
    ESP32-S3R8 has the PSRAM in the package, so only flash, crystal and RF
    matching are external. Add the price difference found on LCSC.
    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
2026-11-10 feat(hardware): add the first draft of the mainboard schematic
    KiCad 9 project for the ESP32-S3-WROOM-1U + Air780E board, seven sheets:
    power, MCU, IO expanders, cellular, display, cameras, audio and TF card.
    The sheets are generated by gen/design.py. gen/build.sh regenerates
    them, compares the netlist KiCad exports with the intended pin-to-net
    map, runs ERC and exports the PDF.
    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
    [audio_tf.kicad_sch, camera.kicad_sch, cellular.kicad_sch, display.kicad_sch, expander.kicad_sch, mcu.kicad_sch, power.kicad_sch, zeebuddy-mainboard.kicad_sch]
2026-11-10 feat(hardware): follow Espressif guidelines on reset, USB and UART0
    Reserve a reset supervisor on EN (not fitted), add series resistor
    positions on the module's USB pair, and raise the series resistor on
    U0TXD towards the LCD.
    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
    [audio_tf.kicad_sch, camera.kicad_sch, cellular.kicad_sch, display.kicad_sch, expander.kicad_sch, mcu.kicad_sch]
2026-11-10 feat(hardware): use datasheet-checked parts and values in the schematic
    - Expanders: XL9555QF24 (same pinout as TCA9555RTW; has 100k internal
    pull-ups, so pull-downs that must win are 2.2k to 4.7k).
    - Microphone: MSM261S4030H0R with its own symbol.
    - Backlight: SY7200AABC instead of TPS61165.
    - Buck: SY8089AAAC with larger capacitors and a feed-forward capacitor.
    - Charger: 200R on ILIM so the input limit stays at or below 2 A.
    - Front camera: selectable IO supply and options for single-supply
    sensors, so an unpowered sensor cannot hold the shared I2C bus.
    - Amplifier enable gets a pull-down.
    Claude-Session: https://claude.ai/code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
    [audio_tf.kicad_sch, camera.kicad_sch, cellular.kicad_sch, display.kicad_sch, expander.kicad_sch, mcu.kicad_sch, power.kicad_sch]
2026-11-10 feat(hardware): switch the charger to SY6970 for the 2000 mAh battery
    Use an SY6970QCC symbol with the pin names and the external component
    values from its datasheet (1 uH inductor, 200R on ILIM for about 1.8 A
    input). Record the battery capacity and the charge-current note.
    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
    [audio_tf.kicad_sch, camera.kicad_sch, cellular.kicad_sch, display.kicad_sch, expander.kicad_sch, mcu.kicad_sch, power.kicad_sch, zeebuddy-mainboard.kicad_sch]
2026-11-11 feat(hardware): add footprints, the board outline and a first placement
    - Project footprint library: Air780E (from the official decal), SY6970
    QFN-24 and the MSM261S4030H0R microphone (from their datasheets), plus
    stand-ins for connectors that are not chosen yet.
    - Every part now has a footprint; the SIM and TF symbols follow the pad
    names of their stand-in footprints.
    - gen/board.py builds the PCB: 64 x 34 mm outline and screw holes of the
    reference board, all footprints with their nets, the main parts placed
    and the rest parked below the board.
    - gen/build.sh also runs DRC with the schematic parity check.
    Claude-Session: h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
    [audio_tf.kicad_sch, camera.kicad_sch, cellular.kicad_sch, display.kicad_sch, expander.kicad_sch, mcu.kicad_sch, power.kicad_sch, zeebuddy-mainboard.kicad_pcb]
2026-11-11 feat(hardware): cap the default charge current for the 0.5C battery
    The SY6970 powers up with a 2.048 A charge current, above what the
    2000 mAh cell allows. In default mode the input power is now limited in
    hardware: 680R on ILIM (about 0.53 A in) and the charger's DP/DM pins
    shorted and kept off the USB data lines, so no fast-charge handshake can
    raise VBUS. Firmware lifts the limit while it is feeding the watchdog.
    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
    [power.kicad_sch, zeebuddy-mainboard.kicad_pcb, zeebuddy-mainboard.kicad_sch]
2026-11-11 feat(hardware): move the TF socket to the back, beside the Type-C
    The TF socket now sits on the bottom edge of the back side, so TF,
    Type-C and SIM open on the same face. To make room the ESP32 module
    moves to the top edge, the Air780E is turned sideways, the rear camera
    connector shifts left and the 4G antenna socket goes between the SIM
    socket and the Type-C.
    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
    [zeebuddy-mainboard.kicad_pcb]
2026-11-11 feat(hardware): place all parts and add a first routing pass
    - gen/place.py places all 213 parts: the modules, connectors and the
    parts that must sit next to their pins on the back, everything else on
    the front. No courtyard overlaps.
    - gen/route.py with gen/route_core.c is a grid maze router with rip-up
    and reroute; it also adds the GND and +3V3 zones. It makes 508 of the
    599 connections; the routed copper passes KiCad's DRC.
    - A smaller test pad footprint, grounded mounting holes (the one next to
    the board edge has no copper ring), designators moved off the silk.
    The board is not finished: 91 connections are still open.
    C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
    [cellular.kicad_sch, expander.kicad_sch, mcu.kicad_sch, power.kicad_sch, zeebuddy-mainboard.kicad_pcb]
2026-11-11 feat(hardware): prepare the hand-off to Freerouting
    - Net classes for supply nets and the antenna line in the project file.
    - gen/freeroute.py exports the placed board as a Specctra DSN file (GND
    and +3V3 inner layers as planes), can run Freerouting on it and
    imports the session file it writes back.
    - freerouting/zeebuddy-mainboard.dsn is that export, ready to open.
    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
    [zeebuddy-mainboard.dsn]
2026-11-11 wip(hardware): apply the supply, antenna, USB and decoupling layout rules; routing paused
    Placement: 220 uF turned so its + pad faces the Air780E supply pads, C22 opposite them,
    ESP32 decoupling capacitors next to the 3V3 pin.
    Router: VDD_4G pour on the back, antenna line with 0.3 mm spacing and ground vias, ground area
    under it on In2 (not yet verified by a full run), ESP32 supply routed via -> 22 uF -> 100 nF -> pin,
    long USB pair laid side by side, critical tracks exported locked, dangling track ends trimmed.
    Freerouting hand-off keeps the locked tracks; README has the step-by-step instructions.
    The routing run was stopped while a move to six layers is being considered: the PCB file in
    t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
    [zeebuddy-mainboard.kicad_pcb]
2026-11-11 docs(hardware): add the six-layer layout and routing specification
    Stack-up and layer roles, routing order, general rules, and numbered rules for power,
    the 4G antenna line, USB, decoupling, other signals, ground and manufacturing, each with
    its level, how it is checked and where it comes from. Lists what the current placement
    must change and what still needs confirming with the fab.
    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
2026-11-11 wip(hardware): start the move to six layers, 1.6 mm
    Board script: six copper layers, 1.6 mm. Router: four routing layers (F, In2, In3, B) with a
    preferred direction on the two inner ones, two ground planes, antenna line as a coplanar line
    with ground-only strip beside it. Placement: antenna matching parts in one line with the socket,
    220 uF closer to the Air780E supply pads.
    Not routed yet. The placed board has three courtyard overlaps to fix, and the In4 opening under
    the antenna line is being reconsidered after a review of the layout specification.
    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
    [zeebuddy-mainboard.kicad_pcb]
2026-11-11 feat(hardware): six-layer board per layout spec V0.2, first routing runs
    Spec: docs/layout-spec.md is now V0.2 (1.6 mm, 7628 outer prepreg, local opening under the
    antenna socket instead of a full-length slot, L4 as a pure 3.3 V layer, corrected inner-layer
    current widths, new rules), with a list of open issues found against the schematic and placement.
    Board: six layers, 1.6 mm; antenna matching parts in one line with the socket; placement has no
    courtyard overlaps.
    Router: three signal layers (L1, L3, L6), ground on L2/L5, +3V3 as a plane on L4 with capacitors
    getting their via first; antenna line 0.34 mm with ground beside it, ground vias along it,
    ground-only strip of 1 mm, In4 opening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
    [zeebuddy-mainboard.dsn, zeebuddy-mainboard.kicad_pcb]
2026-11-11 feat(hardware): router improvements and a diagnosis of the open connections
    Router: short connections are routed before long ones; rip-up removes only the paths that are in
    the way instead of whole nets, reconnects them, and keeps the best state seen; leftover stubs and
    vias are cleaned up; every open pad group is reported with its position and whether it is shut in
    by fixed copper (build/open.json).
    Result on six layers with L4 as a pure 3.3 V layer: 514 of 580 connections. Only 3 of the 66 open
    pad groups are shut in by fixed copper; they sit on the front along the two modules' pad columns
    and the top connector row, where both sides together have 50 to 80 pads per square centimetre.
    The p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
    [zeebuddy-mainboard.dsn, zeebuddy-mainboard.kicad_pcb]
2026-11-11 fix(hardware): export net classes and rules in the Freerouting hand-off
    The stripped board was loaded without its project file, so the DSN carried KiCad's defaults
    (0.2 mm tracks and clearance, 0.6 mm vias) instead of the board's classes. A copy of the project
    file now sits next to the stripped board. The +3V3 plane on In3 leaves out the ground under the
    antenna socket's opening, so the two planes no longer overlap.
    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
    [zeebuddy-mainboard.dsn]
2026-11-11 feat(hardware): negotiated routing (experimental) and a diagnosis of why routing stops short
    Router:
    - NEGOTIATE=1 routes all nets that are not fixed together: tracks may run through the space another
    net needs but pay for it, the price rises every round and contested cells keep a history cost.
    From the second round on only the connections in another net's way are taken out and laid again.
    It does not converge yet (about 145 connections stay in conflict with signals allowed on L4), so
    the default is still the one-net-after-the-other flow.
    - Footprints and pads are sorted before routing: KiCad stores them in the order of their random ids,
    which made the result vary by a few connecti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
    [diagnose.py, route.py, route_core.c]
2026-11-11 feat(hardware): import the first Freerouting result and finish it
    freerouting/zeebuddy-mainboard.ses is the session Freerouting produced from the hand-off file.
    gen/finish.py takes the imported board the rest of the way: it removes what Freerouting left
    hanging, takes out the pieces that break rules it does not know (tracks through holes that have
    no copper on the inner layers, less than 0.3 mm to the board edge, tracks under the minimum
    width), gives every ground and +3V3 pad a stub and a via, and routes what is still open with
    everything else fixed.
    Result: no clearance, short or edge violations; 73 connections open (31 signal, 15 ground,
    21 +3V3, 6 supply). Freerouting left 28 signal con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
    [zeebuddy-mainboard.kicad_pcb]
2026-11-11 feat(hardware): lay the locked base for the second Freerouting round
    The first round routed the signals first and the supply afterwards, which
    left 73 connections open and supply nets on an inner layer. This follows
    the order of layout-spec.md section 2 instead: the base goes in first and
    is locked, the autorouter only gets the signals.
    Placement
    - charger turned by 90 degrees: BAT / SYS / PGND face up, SW faces right;
    inductor 2.7 mm from the switch pins, capacitors at their pins
    - Air780E load switch above the 220 uF, capacitor turned (plus pad up);
    its small capacitors and TVS on the front opposite the supply pins
    - 3.3 V buck next to the system-supply vias, backlight boost moved to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
    [zeebuddy-mainboard.dsn, zeebuddy-mainboard.kicad_pcb]
2026-11-11 feat(hardware): second Freerouting round on the locked base
    The hand-off file no longer gives Freerouting the nets that the base has
    finished: their copper goes over as keep-out areas and their pads carry no
    net, so it sees obstacles and 243 signal connections. Ground and +3V3 keep
    one pad each so that the planes still close their layers to signal tracks.
    The scripted run has a time limit, because Freerouting only writes its
    result when it stops.
    Imported result of an 8 minute run plus finish.py: 532 of 576 connections,
    rule check clean, 44 signal connections still open.
    Claude-Session: https://claude.ai/code/session_01JQaTnpSi55n8mo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
    [zeebuddy-mainboard.dsn, zeebuddy-mainboard.kicad_pcb]
2026-11-11 feat(hardware): import the 20 minute Freerouting result
    538 of 576 connections after finish.py, rule check clean. The 38 that are
    still open are pads that cannot get out, most of them on the three FPC
    connectors at the top edge.
    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
    [zeebuddy-mainboard.kicad_pcb]
2026-11-11 docs(hardware): record the second Freerouting round and where it stops
    538 of 576 connections, rule check clean. The README now says how the
    hand-off file is made, how to rerun with a time limit, and why 38 signal
    connections are left: pads that cannot get out, 20 of them on the three FPC
    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
2026-11-11 feat(hardware): clear a band below the front camera connector and route again
    C46, C47 and Q2 leave the area below J11's pads; Q3..Q5 and the three
    resistor rows under them move down 0.9 mm. The supply copper is untouched.
    Result of a 20 minute Freerouting run plus finish.py: 534 of 576
    connections, rule check clean. That is within the noise of the previous
    placement (538): the band lets the pins out, but the front camera bus still
    has to cross 25 mm of the Air780E's surroundings to reach its bus switches.
    The README says what would have to move next.
    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
    [zeebuddy-mainboard.dsn, zeebuddy-mainboard.kicad_pcb]
2026-11-11 feat(hardware): move the front camera connector to its bus switches
    J11 goes from x = 20 to x = 51.1 on the top edge, right above U12..U14 and
    over the ESP32 module, where the back has no pads. What had to follow:
    - key connector J5 moves 10 mm left (x = 39.4);
    - the bus switches, U7 and their capacitors move down 1.6 mm: 2.5 mm below
    the connector's pads stay free;
    - the front camera option parts (C48, C49, R66, R67, R71..R73) sit in a
    column beside the connector;
    - the camera LDOs and the clock form one strip under y = 4.2 with their
    capacitors between the chips, so that the front is free below the pads of
    the display and rear camera connectors on the back.
    The supply copper is unt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
    [zeebuddy-mainboard.dsn, zeebuddy-mainboard.kicad_pcb]
2026-11-11 feat(hardware): test pads and clock resistors beside what they connect to; hand-routing and push-through tools
    Placement: TP19 / TP20 and TP17 / TP18 sit beside the module pins they
    probe (they were 13 mm away), the camera clock resistors beside the
    oscillator, the CAM_SEL pull-down beside the bus switches, and the camera
    LDO strip starts at x = 11.5.
    Tools: gen/hand.py lays signal connections given by coordinates and checks
    them against the router's clearance map; finish.py can push the last
    connections through other signal tracks (RIPUP=seconds), keeping a step only
    when fewer connections are open; freeroute.py can leave L4 open to signals
    (L4_SIGNALS=1, the fallback that STK-6 names).
    T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
    [zeebuddy-mainboard.dsn, zeebuddy-mainboard.kicad_pcb]
2026-11-11 feat(hardware): signals on the two expanders follow where the parts are
    TP_INT and CHG_INT move from expander A (right side of the board) to
    expander B (left of the middle); CAMF_PWDN and CAM_SEL move the other way.
    The touch connector and the charger are on the left, the front camera
    connector and the bus switches on the right: four tracks of 30 .. 65 mm
    across the board become short ones. Both INT outputs were already tied
    together, so inputs on either chip still wake the ESP32. R26 (touch
    interrupt pull-up) moves beside expander B.
    Schematic, PDF and board are regenerated; netlist check 0 errors. The board
    file in this commit is the locked base for the new netlist (243 signal
    connections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
    [expander.kicad_sch, zeebuddy-mainboard.dsn, zeebuddy-mainboard.kicad_pcb]
2026-11-11 feat(hardware): route the board with the swapped expander pins
    20 minutes of Freerouting, then finish.py with the push-through step:
    560 of 576 connections, rule check clean, schematic parity 0. 16 signal
    connections are open (24 before the pin swap); CHG_INT and CAMF_PWDN, which
    used to cross the whole board, are connected.
    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
    [zeebuddy-mainboard.kicad_pcb]
2026-11-11 feat(hardware): free two shut-in expander pins, output capacitors at the LDO outputs, TF socket escape
    Found by looking at the open connections one by one:
    - expander B sits over the antenna line; the line's ground vias shut in its
    pins 8 and 11 (P07, P11). They stay unused: CAM_RST and EXP_SPARE move to
    free pins of expander A, TP_INT to P17 of expander B. TP10 moves beside A.
    - the output capacitors of the two camera LDOs (C39, C40; C42, C43) sit at
    the top of their columns, level with the output pin; before, the input
    capacitor lay between the 1.2 V output pin and its capacitor.
    - TF socket under the microphone: the +3V3 stub of pin 4 and the clock pin 5
    go straight up into the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
    [expander.kicad_sch, zeebuddy-mainboard.dsn, zeebuddy-mainboard.kicad_pcb]
2026-11-11 chore(hardware): do not compare footprints with the KiCad libraries in the rule check
    The footprints are written into the board by the scripts; whether another
    KiCad installation has the same footprint in its own libraries says nothing
    about the board (43 warnings on a second machine, 1 here). Both checks are
    set to ignore in the project file and in board.py, which writes it.
    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
2026-11-11 feat(hardware): drop the three option links from the display's low data lines to the TF card
    Decided for the first board: 5 display data lines (G3..G7) and the TF card.
    R58..R60 (unfitted 0R, G0..G2 to SD_CLK / SD_CMD / SD_D0) are removed from
    the schematic and the board; R55..R57 still tie G0..G2 to ground and the TF
    card's own lines are untouched. The three numbers are not reused, so every
    other resistor keeps its reference. 209 parts, netlist check 0 errors,
    schematic parity 0.
    R8 and R73 stay; the README lists what each waits for, and the pin map of
    the two expanders that the firmware has to follow.
    The board file is the locked base for this netlist (237 signal connections
    open); the F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
    [display.kicad_sch, zeebuddy-mainboard.dsn, zeebuddy-mainboard.kicad_pcb]
2026-11-11 feat(hardware): route the board without the three option links
    20 minutes of Freerouting, then finish.py: 558 of 570 connections, rule
    check clean, schematic parity 0. 12 signal connections are open (16 before):
    six at expander A (KEY1, KEY2, KEY5 twice, CAMF_PWDN, EXP_INT), three at the
    display connector (LCD_CS, LCD_HSYNC, LCD_G6), CAMR_VSYNC at the rear camera
    connector, USB_SEL and EXP_INT at expander B.
    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
    [zeebuddy-mainboard.kicad_pcb]
2026-11-11 wip(hardware): placement and base fixes for the next routing round (scripts only)
    Scripts only; the board file in this commit is still the one from 7ab37c0
    (558 of 570 connections, old placement). The run with these changes is
    going on a scratch copy; if its result is taken, the board follows in the
    next commit, otherwise this commit is reverted.
    - U8 (expander B) 0.8 mm lower: its top pins face the gap between two pad
    rows of the Air780E on the back, so each can have its own via; at the old
    position the two +3V3 pins shared one via and their link shut in the
    interrupt pin (U8.22) on the locked base alone.
    - U8 pin 18 (address pin, ground) goes into the centre pad instead of round
    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
    [place.py, power.py]
2026-11-11 feat(hardware): route the board with U8 moved, U7 turned and the interrupt pin joined in the base
    Freerouting stopped by itself after 35 passes with 3 connections open;
    finish.py leaves 1: 569 of 570 connections, rule check clean, schematic
    parity 0. All 12 connections that were open in 7ab37c0 are made (EXP_INT at
    U8.22 and U7.22, LCD_CS, LCD_HSYNC, LCD_G6, CAMR_VSYNC, CAMF_PWDN, USB_SEL,
    KEY1, KEY2, KEY5 twice). One new one is open: I2C_SCL at the charger, U2.5.
    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
    [zeebuddy-mainboard.dsn, zeebuddy-mainboard.kicad_pcb]
2026-11-11 feat(hardware): all 570 connections routed; closure record and rule-check report
    KiCad 9.0.9, full check with schematic parity: 0 unconnected, 0 violations,
    0 parity issues (reports/drc-report.txt, .json).
    The one connection left after Freerouting and finish.py, the charger's I2C
    clock pin (U2.5), is laid by hand (gen/hand.py): the three vias in the
    0.24 mm strip below the chip stand one above the other at the smallest pitch
    the rules allow. A first attempt was 0.078 mm from a track on L3 and was
    taken back; the via moved 0.03 mm.
    gen/widen.py widens tracks that Freerouting necked down: 8 pieces kept
    wider, 2 went back because the clearance was not there.
    reports/routing-closure.md record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
    [zeebuddy-mainboard.kicad_pcb]
2026-11-11 docs(hardware): take the independent review of 731b83a into the closure record
    The review (KiCad 10.0.8, files only) agrees on 0 unconnected, 0 violations
    and 0 net differences. Its numbers were recomputed here with KiCad 9.0.9 and
    match. Two figures in the record were wrong and are corrected: the CHG_INT
    via is about 0.152 mm from R3.1 (0.105 mm came from the pad's bounding box),
    and 107 vias miss GEN-7 at 0.15 mm (not 'about 130'). Added what the record
    did not cover: two antenna ground vias inside small pads (VIP-1), the
    display pixel clock with 5 layer changes over 63 mm (SIG-4), return vias
    (GEN-10), and the four schematic / BOM questions to settle before another
    routing round.
    Co-Auth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
2026-11-12 feat(hardware): U1 pin 5 to VBUS, R44 fitted; display interface for the panel maker
    Decided after the independent review:
    - U1 (USBLC6-2SC6) pin 5 goes to VBUS as in ST's circuit. On this board the
    pad is shut in by the locked USB tracks and the Type-C pads on the back,
    so it stays open (1 unconnected) until the USB pairs are laid again.
    - R44 (10k, VDD_4G to the Air780E's USB-detect pin) is fitted by default:
    the 4G data link is USB only. Whether pin, value and level are right is
    not confirmed by Luat yet.
    - USB-7 in the layout spec (V0.4) is written per USB path: the Type-C path
    ends at the ESP32-S3, which is full speed only, so 4 pF per line is
    enough there; under 1 pF stays f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
    [audio_tf.kicad_sch, camera.kicad_sch, cellular.kicad_sch, display.kicad_sch, expander.kicad_sch, mcu.kicad_sch, power.kicad_sch, zeebuddy-mainboard.kicad_pcb]
2026-11-12 feat(hardware): backlight to 20 mA; the panel maker's part is MIPI, not serial RGB
    The panel maker sent the specification of the HD28142C22 (2.83 inch,
    480 x 640, NV3049), its outline drawing and an initialisation sequence.
    - The part has a two-lane MIPI-DSI interface. This board drives 8-bit
    serial RGB plus 3-wire SPI from an ESP32-S3, which has no MIPI-DSI. The
    interface definition for the maker now opens with that and with what the
    maker has to answer: can the same glass be brought out as serial RGB, at
    what cost, with which initialisation, and does it work at 17 to 22 frames
    a second. No board order before this is settled.
    - Backlight per the specification: six LEDs in series,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
    [display.kicad_sch, zeebuddy-mainboard.kicad_pcb]
2026-11-12 docs(hardware): QSPI interface definition for the panel maker to evaluate
    The maker proposes a QSPI version of the 2.8 inch 480 x 640 panel. The
    proposal keeps the cable of the HD28142C22 and the positions of backlight,
    supply, ground and reset; the three MIPI pairs become CS, SCK and D0..D3,
    one ground pin becomes TE. It lists what we need (frame memory in the
    driver, 40 MHz, TE, single 3.3 V supply) and what the maker has to answer,
    first of all which driver chip it is: the ST7701S as documented takes
    commands over SPI and pixels over RGB or MIPI, not QSPI.
    Also recorded: one frame is 614 kB, so 40 MHz QSPI gives at most about
    32 frames a second, and Espressif's own tests of QSPI panels o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
2026-11-12 docs(hardware): what the NV3049 datasheet says about its interfaces
    From the NV3049 datasheet (New Vision, 2014-08-25, preliminary V1): no frame
    memory; pixels over two-lane MIPI-DSI or over parallel RGB with 16, 18 or 24
    data lines; commands over 3-line 9-bit SPI; the choice is made by four
    hardware pins. Neither 8-bit serial RGB nor QSPI is in it.
    Consequences written into the two interface documents: without MIPI this
    glass needs 20 RGB lines, and the ESP32-S3 has no 11 spare pins; whether the
    NV3049F that the maker's initialisation sequence is written for has the
    serial RGB mode this board relies on is a question for the maker or the chip
    vendor; a QSPI version means a different driver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
2026-11-12 docs(hardware): one-page request for a serial RGB version of the panel
    For a second panel maker who can build NV3049 panels and asks what exactly
    to change: the interface we need (8 data lines, three clocks per pixel, plus
    3-wire SPI; not parallel RGB), the 22-pin cable definition the board already
    has, what the maker has to do, and nine questions, the two decisive ones
    first: does their NV3049 have the 8-bit serial mode at all, and does the
    panel work at 17 to 22 frames a second.
    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
2026-11-12 wip(hardware): via to pad 0.15 mm in the base router (scripts only)
    Scripts only; the board file is the one from b0d31d9 (routed, 1 unconnected
    at U1.5). First step of the next routing round:
    - route.py keeps a via's centre 0.40 mm from every pad edge, its own net's
    pads included: 0.15 mm copper to copper for a 0.45 mm via (GEN-7).
    - power.py: the four hand-laid vias that sat closer are moved (ground
    between C5 and C6, ground beside the battery pads, LTE_PWR_G, EXP_INT at
    U7).
    - place.py: C6 0.15 mm to the right so that the via fits between the two
    ground pads; TP1 and TP3 0.05 mm apart from each other.
    On a scratch copy the base regenerates without a misfit, all supply nets
    connec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
2026-11-12 docs(hardware): the ST7701P has no QSPI either
    From the ST7701P specification (V1.2, 2025-02): no display RAM, pixels over
    parallel RGB (16 / 18 / 24 bit) or MIPI-DSI, and a 3-line or 4-line serial
    interface for commands only. The 4-line serial interface is ordinary SPI,
    not four data lines in parallel; the two are easily mixed up. The QSPI
    proposal therefore has no chip behind it for now; the route that remains is
    8-bit serial RGB with the second maker's NV3049F.
    The specification is marked confidential and is not added to the repository.
    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
2026-11-12 docs(hardware): ST7701P checked across all three volumes
    The interface select pins give only parallel RGB plus SPI (8, 9 or 16 bit)
    or MIPI with optional SPI, and the SPI writes commands only. The pixel
    format register has 16, 18 and 24 bits per pixel. No QSPI and no 8-bit
    serial RGB anywhere in the specification.
    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
2026-11-12 route(hardware): base without a shut-in pin and without fence vias in small pads
    Scripts only; the board file is still the 731b83a routing.
    - power.py: the camera regulator's enable pin (U16.3) gets its way out by
    hand, down between pins 3 and 4 to a via below the display connector's
    pads. Left to itself the 3.3 V link from pin 1 to the input capacitor ran
    round the pin and shut it in.
    - route.py: a fence via inside a chip's ground pad must also keep 0.15 mm
    from every other pad, on either side of the board. Two fence vias sat
    in U9.34 and C29.2 on the back (VIP-1).
    - route.py: a free stretch with room for one via gets it halfway between
    its neighbours; where no via fits for mor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
2026-11-12 route(hardware): USB pairs matched from pin to pin (USB-3)
    - check.py: USB-3 measures each line along its copper from pin to pin.
    The old figure was all copper of the net, branches to test pads
    included, which made the Air780E pair look 3.7 mm apart when it is
    0.07 mm.
    - power.py: the Type-C section is laid by hand. Both lines leave from
    the top of their B-row contact, so turning the plug adds the same join
    to both; D- gets one bend on the back to make up for D+'s longer way.
    - power.py: at the series resistors D+ runs down the back and returns on
    the inner layer, which makes up for D- having to go round a pad there
    an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
2026-11-12 check(hardware): GEN-7 and VIP-1 as a KiCad rule, in the hand-off and in the check table
    - board.py writes zeebuddy-mainboard.kicad_dru: a via keeps 0.15 mm from
    the pads of other nets.
    - freeroute.py: every surface-mount pad gets an area that bars vias within
    0.15 mm in the copy handed to the autorouter, which has no such rule.
    - check.py: two rows, vias on small pads (VIP-1) and vias closer than
    0.15 mm to a pad, own net included (GEN-7).
    By these rows the committed board (731b83a routing) has 67 vias on small
    pads and 297 closer than 0.15 mm, most of them supply vias of the old
    base on the pad of their own net. The new base on the scratch copy has
    none of either.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
2026-11-12 docs(hardware): the NV3049F maker's engineering says the serial RGB panel can be done
    A spoken answer so far: can do, with a new flex cable. Listed what has to
    come in writing before the tooling for the cable is paid.
    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
2026-11-12 route(hardware): hand-off bars vias 0.15 mm from pads, not 0.25 mm
    Scripts and the autorouter's result only; the board file is still the
    731b83a routing.
    Freerouting keeps its own 0.10 mm clearance from a via keep-out, so the
    keep-out round each pad is the pad grown by 0.05 mm. Grown by the full
    0.15 mm the router's vias sat 0.25 mm or more from the pads and 34
    connections stayed open after clean-up; with the smaller areas 13 stay
    open (562 of 575), on the same base and the same 20 minutes.
    freerouting/round4-gen7.ses is that second result. On the scratch copy
    after import and finish.py, KiCad 9.0.9 with the via-to-pad rule: no
    violations, 13 unconnected, no parity issues; no via on a smal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
    [freeroute.py]
2026-11-12 route(hardware): three changes to the base, autorouter comparison pending
    - power.py: the output capacitors of the two camera regulators hang on
    the output pin by hand, and U16's supply pin goes to the 3.3 V plane
    beside the pin. In the last run a track through the 0.75 mm gap cut
    the 2.8 V capacitors off from the regulator.
    - place.py: the pull-ups of keys 4 to 6 sit beside key connector B at
    the top edge, where those lines go, instead of in the corner under
    expander A.
    - power.py: the front VSYS trunk steps 0.7 mm to the left where it passes
    the charger's four signal pins; the room for vias below them grows
    from 0.4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
2026-11-12 route(hardware): key pull-ups back in place, U15 0.6 mm left
    Three bases were routed side by side, 25 minutes each, then cleaned up:
    regulator capacitors by hand 14 open; the same with the pull-ups of keys
    4 to 6 moved to key connector B 16 open; the same again with the VSYS
    trunk stepped aside at the charger 16 open. The moved pull-ups eased
    the corner under expander A (5 open there down to 2) but stood where the
    rear camera connector's last pins drop their vias (4 new open), so they
    go back. The stepped trunk stays.
    In every run one to three of the display data lines stayed open. Above
    the display connector's pads (back) the fron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
2026-11-12 docs(hardware): record of the routing round in progress
    What the new base achieves (GEN-7, VIP-1, USB-3, U1 pin 5, RF-5 without
    vias on small pads, regulator capacitors), what it does not yet (13 to 19
    of 575 connections open after the autorouter and clean-up, six variants
    with their figures), why, and the decision that is open: keep 0.15 mm
    between vias and pads, or order plugged and capped vias and go back to
    plain copper clearance.
    The stored autorouter result is removed: it belonged to a base that has
    changed since.
    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
2026-11-12 docs(hardware): the ST7102 maker says QSPI and MIPI, not serial RGB
    The project goes for QSPI samples from this maker, so the QSPI proposal
    is live again. Listed what the maker has to confirm in writing first:
    display RAM or not, clock and pixel format over QSPI, init code, and the
    backlight and supply, which on this maker's present panel do not match
    the mainboard.
    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
2026-11-12 route(hardware): short signal connections before the ground stubs; CC resistors out of the 5 V loop
    - route.py: pads of a signal net up to 4 mm apart are joined in the base,
    before the ground and supply stubs. Where a module's pads cover the back
    and its small parts the front, the few spots where a via keeps 0.15 mm
    from every pad went to the stubs, and the same short connections stayed
    open in every autorouter run. 56 of 63 such connections are made; the
    autorouter is left with 174 instead of 232.
    - place.py, power.py: the two Type-C CC resistors stand right of the
    protection diode instead of inside the 5 V loop on the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
    [place.py, power.py, route.py]
2026-11-12 route(hardware): resistor ground and supply pads join nearby copper instead of a via each
    - route_core.c: in plane mode the via cost is what a via of its own costs
    the pad. The first spot where a via fits is kept and taken only if no
    copper that already reaches the plane turns up within that much more.
    - route.py: capacitors, chips and connectors get their own via as before;
    resistors, transistors, diodes and test pads come after with a via cost
    of 600 (3 mm of track). The ground and 3.3 V stubs need 134 vias instead
    of 166, and the 32 spots freed are where small parts crowd.
    - power.py: D- at the series resistors is laid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
2026-11-12 route(hardware): via-to-pad distance as a setting; record of the later runs
    Scripts and record only; the board file is still the 731b83a routing.
    VIA_GAP (default 0.15 mm, GEN-7) sets both the base router's distance and
    the keep-outs handed to the autorouter, so that the cost of the rule can
    be measured. The default changes nothing.
    Record: two more runs at 19 open, the pass-by-pass course of the
    autorouter (plateau between 22 and 30 after ten minutes), and the trial
    with layer 4 open for the last connections (14 open), which shows that
    what is missing is room for vias beside the connectors' pads, not a layer.
    Claude-Session: https: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
    [freeroute.py, route.py]
2026-11-12 docs(hardware): relaxing the via-to-pad distance to 0.10 mm does not close the routing either
    Same base, same 25 minutes, VIA_GAP=0.10: 21 connections open, against
    13 to 19 at 0.15 mm. The 0.05 mm is not what matters; the previous board
    closed because supply and ground vias sat on their own pads. Rewrote the
    decision that is open accordingly: via-in-pad with plugged and capped
    vias and the previous routing, or vias off the pads and a new placement
    round the connectors.
    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
2026-11-12 docs(hardware): sampling requests for the two display makers
    - display-request-qspi-st7102.md: new, for the ST7102 maker. QSPI for
    commands and pixels, the 22-pin definition, backlight in series
    (their present panel has four LEDs in parallel, which the boost driver
    cannot run), and what has to come in writing before sampling.
    - display-request-serial-rgb.md: for the NV3049F maker. Asks for written
    confirmation of NV3049F and 8-bit serial RGB, backlight in series, the
    flex drawing; the internal progress note moved out.
    - display-samples-two-makers.md: internal overview. The two makers side
    by side, what each must confirm, how the samples are tested on a dev
    board, and what chang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
2026-11-12 docs(hardware): how the two display samples are tested
    - devboard-validation-guide.md: a section for the QSPI sample (wiring on
    the GPIOs the mainboard would use, interface setup, test patterns,
    frame rate at 20 to 80 MHz, TE and tearing, camera and 4G on top, pass
    marks), and a note that the serial RGB sample follows sections 3 to 5.
    - display-samples-two-makers.md: the verification in stages, from
    buying the parts now to choosing a maker and changing the mainboard.
    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
2026-11-13 docs(hardware): brief for an outside PCB engineer to redo the layout
    pcb-redesign-brief.md and its Word copy in docs/vendor/: what is asked
    (re-place and re-route against layout-spec V0.4 to zero DRC errors and
    zero unconnected), where the material is, board parameters, main parts
    and connectors with their positions, the power tree, the ESP32 and
    expander pin maps, the open display interface (QSPI or serial RGB, to
    be routed last), the key rules, the via-in-pad question with the two
    ways out, the crowded spots found so far, the open items we owe, and
    what is to be delivered and how it is accepted.
    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
2026-11-13 docs(hardware): touch goes into both display samples
    Both sampling requests now ask for a capacitive touch panel on its own
    6-pin 0.5 mm flex (CST836U or similar, I2C, 3.3 V): 1 INT, 2 RST, 3 SCL,
    4 SDA, 5 GND, 6 VDD, the order of the touch tail on the display maker's
    drawing T-HY028003A-01. The same pinout for both makers, so one board
    fits either panel. Touch questions and a touch test added; the engineer
    brief notes that J9 in the schematic still has the old placeholder order.
    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
2026-11-13 docs(hardware): flex ends as gold fingers with stiffener, no board-to-board connectors
    The display maker asked how the flex should end. Both requests now say:
    0.5 mm gold fingers with a stiffener, 0.3 mm thick at the fingers, into
    the flip-lock FPC sockets on the mainboard; no BTB plug and receptacle.
    The maker picks the contact side and we choose top or bottom contact
    sockets to match.
    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
2026-11-13 docs(hardware): display and touch connect through board-to-board connectors (Yaqi)
    Decision 2026-11-13: the flex ends in a Yaqi-brand BTB plug, the
    mainboard carries the matching receptacle, instead of gold fingers into
    flip-lock FPC sockets. Both sampling requests ask the makers for the
    matching plug and receptacle part numbers, pitch and mated height (aim
    1.0 mm or less), a table of receptacle pin number to signal (plug and
    receptacle are mirrored), and whether the touch tail can join the
    display flex so that one connector carries both. The engineer brief and
    the overview follow; the dev-board test needs receptacle breakout boards.
    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
2026-11-13 docs(hardware): the ST7102 panel has in-cell touch; no separate touch panel
    Lianxun says their 2.8-inch panel is in-cell: touch is built into the
    panel, only a cover glass is added, and they deliver the assembly. The
    ST7102 request now asks for that assembly, with the touch signals (INT,
    RST, SCL, SDA) on the same flex and connector as the display, and asks
    whether touch works while pixels come over QSPI, the I2C address, and
    whether the touch lines are 3.3 V or 1.8 V. The NV3049F request keeps
    the separate touch panel.
    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
2026-11-13 docs(hardware): evaluation of the ESP32-S31 as the main controller
    From Espressif's own material: the S31 and WROOM-1U datasheets
    (pre-release v0.5), the technical reference manual, ESP-IDF v6.1's
    soc_caps.h and chip support table, and the component manifests.
    What matters here: 54 GPIOs on the WROOM-1U against 33, in-package octal
    PSRAM at 250 MHz DDR, two separate USB ports (high-speed OTG on dedicated
    pins for the Air780E, full-speed serial/JTAG for Type-C, so the USB
    switch can go), RGB/8080 LCD and quad SPI but still no MIPI, 8/16-bit
    DVP with hardware JPEG and PPA. ESP-IDF supports it from v6.1;
    iot_usbh_modem and esp_video/esp_cam_sensor (OV2640) list it,
    esp32-camera does not. Rough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
2026-11-13 docs(hardware): can the ESP32-S31 drive our 480x640 panels
    ESP-IDF's S31 RGB LCD page recommends a pixel clock under 80 MHz for an
    8-bit bus and uses the IO MUX when all signals sit on the dedicated pads
    (data GPIO8-15, PCLK 40, DE 43, HSYNC 44, VSYNC 45); the datasheet gives
    80 MHz for a general-purpose SPI master, quad on the SPI2 pads GPIO9-14.
    Frame-rate estimates for both panels at 40, 60 and 80 MHz, against
    17-22 fps on the S3; the camera's dedicated pads are GPIO46-57.
    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
2026-11-13 docs(hardware): main controller changes to the ESP32-S31
    Decision 2026-11-13. New esp32-s31-pinmap.md: pin assignment for the
    ESP32-S31-WROOM-1U-N16R16V. Display and camera on the dedicated IO MUX
    pads (LCD data GPIO8-15, PCLK 40, DE/HSYNC/VSYNC 43-45; camera GPIO46-57),
    TF card 4-bit on the fixed SDIO pins GPIO20-25, Type-C USB on the
    full-speed serial/JTAG pins GPIO33/34 and the Air780E on the dedicated
    high-speed port, keys and interrupts on the low-power pins GPIO0-7,
    debug UART on 58/59, BOOT on 61, strapping pins 36/37 left free. QSPI
    variant on the SPI2 pads GPIO9-14. One XL9555 instead of two; the USB
    switch FSUSB42 goes; Y1 can go if the cameras run on the controller's
    clock.
    Requi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
2026-11-13 docs(hardware): Espressif's authorised distributors in Shenzhen
    From the distributor page on espressif.com: Wireless-Tag, Comtech, Ferry
    Semi and China InfoSafe in Shenzhen; samples and dev boards from the
    official Taobao shop or Espressif's own store.
    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
2026-11-14 docs(hardware): S31 hardware notes from Espressif's design guide; PCBA plan
    esp32-s31-pinmap.md section 6: what the S31 hardware design guidelines
    (2026-11-12), the datasheet's power and electrical chapters, the
    WROOM-1U datasheet, the chip errata and the Korvo-1 schematic settle:
    3.3 V of at least 600 mA, EN RC 10k + 1 uF and a ~3.0 V supervisor for a
    battery product (U5 to be fitted), GPIO36 pulled up inside the module,
    GPIO61 needs a pull-up and no large capacitor, only GPIO0-7 work in deep
    sleep, input high threshold 0.75 x VDD (1.8 V parts need a level
    shifter), SDIO slot 0 needs no pull-ups, series-resistor footprints on
    both USB ports; the two errata do not affect us. The WROOM-1U has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
2026-11-14 docs(hardware): what Espressif offers that the AI photo-learning device can use
    espressif-resources-for-ai-camera.md, from Espressif's site, the S31
    developer hub, ESP-VISION, the private agents platform, SDK READMEs, the
    component registry and the developer portal: per product function which
    Espressif piece to use and its S31 status (ADF v3 ai_agent with the
    Tongyi vision example as the starting point, ESP-SR, esp_video with
    hardware JPEG, LVGL with PPA, esp_player with MJPEG at 66 fps for
    640x480 vs 13 fps for software H.264, Audio-Effects, iot_usbh_modem),
    licensing, a suggested software path, effects on hardware and production
    (no WROOM-1U jig so own test pads, antenna gain 2.33 dBi, fro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
2026-11-14 docs(hardware): ST7102 stays in the sampling; note its third-party driver and S31 reference
    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
2026-11-14 docs(hardware): ST7102 supports parallel RGB; ask Lianxun about it as a fallback
    The registry has a third-party ST7102 driver for RGB and MIPI DSI and an
    ESP32-S31 board package driving a 4.3-inch 480x800 ST7102 in-cell panel
    over RGB. Lianxun's 'no serial RGB' therefore reads as the 8-bit serial
    mode only. Parallel RGB would cost about 20 controller pins against 7 for
    QSPI, so it is asked as a fallback (question 12) and noted in the
    overview.
    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
2026-11-14 docs(hardware): display goes 16-bit parallel RGB; one 40-pin connector for both panels
    Decision 2026-11-14: the ST7102 panel from Lianxun uses 16-bit parallel
    RGB (RGB565) with 3-wire SPI init instead of QSPI.
    - display-request-rgb-st7102.md (new, with Word copy): in-cell touch
    assembly, 3.3 V IO required, PCLK about 21-25 MHz for 60 fps, a 40-pin
    board-to-board definition by receptacle pin with the ESP32-S31 pin of
    each signal, questions and acceptance. The QSPI request is marked void
    and its Word copy removed.
    - display-request-serial-rgb.md: same 40-pin connector for the NV3049F
    panel, which uses D0-D7 only and its touch on pins 37-40; asks whether
    NV3049F can do 16-bit paral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
2026-11-14 docs(hardware): both panels on 16-bit parallel RGB
    Decision 2026-11-14: the NV3049F panel moves from 8-bit serial RGB to
    16-bit parallel RGB (RGB565) like the ST7102 one, on the same 40-pin
    board-to-board definition. New display-request-rgb-nv3049f.md with its
    Word copy (8-bit serial kept only as a fallback on the same connector);
    the serial request is marked void and its Word copy removed. Overview,
    engineer brief and pin map follow.
    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
2026-11-14 docs(hardware): official KiCad footprint for the S31 module; display sampling under way
    Espressif's kicad-libraries has an ESP32-S31-WROOM-1U symbol, footprint
    and 3D model; checked against the datasheet's land pattern (64 signal
    pads, nine 0.9 mm ground pads, 1.27 mm outer pitch, inner ring of twenty
    0.4 x 0.8 mm pads at 0.8 mm). Pin map and engineer brief point to it.
    The display overview records that both makers' samples are arranged.
    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
2026-11-14 docs: firmware architecture and development plan for the ESP32-S31
    Per product function the Espressif component to use and its S31 status,
    the software layers with a board-support layer swappable between the
    Korvo-1 and our board, ESP-IDF v6.1 as the common base, a cloud design
    that keeps the model API keys on our own backend instead of in the
    firmware, a PSRAM and core budget (about 7-9 MB of 16 MB), the order of
    work on the Korvo-1 dev board, and the risks to verify first.
    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
2026-11-14 docs: new selling points from Espressif capabilities, checked for ESP32-S31
    On-device face detection (eye-distance reminder), face recognition (per
    child profiles), image classification and object detection (offline
    picture-to-English), hand gestures, multilingual wake words and offline
    commands, Bluetooth Classic headphones, slow playback and voice effects,
    and a mistakes notebook; USB webcam/audio-device mode needs the
    high-speed USB port, now taken by the Air780E, so a USB switch would have
    to come back before the schematic is redone; posture, voiceprint,
    WebRTC, ESP-NOW and Wi-Fi sensing to be verified; OCR and touch keys not
    advised.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
2026-11-14 PCBA plan: front camera spec for face and gesture features
    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
2026-11-14 Display connector: OCN OK-128 0.35 mm 40-pin BTB chosen
    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
2026-11-14 Selling points: webcam/UVC dropped, no USB switch
    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
2026-11-14 docs: UART0 TX/RX corrected, second expander back to 0x22, brief and pinmap updated for the S31 schematic
    GPIO58 is U0TXD and GPIO59 is U0RXD (module datasheet table 3-1). 0x21 clashes with the GC0308 / GC032A front
    cameras, so U8 stays at 0x22. The engineer brief now lists two expanders, the fitted supervisor, the unfitted
    24 MHz oscillator and the touch merged into the 40-pin socket.
    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
